huynhpham13790-rgb/Innowork-2026/docs/slide_assets/fire_car.jpg

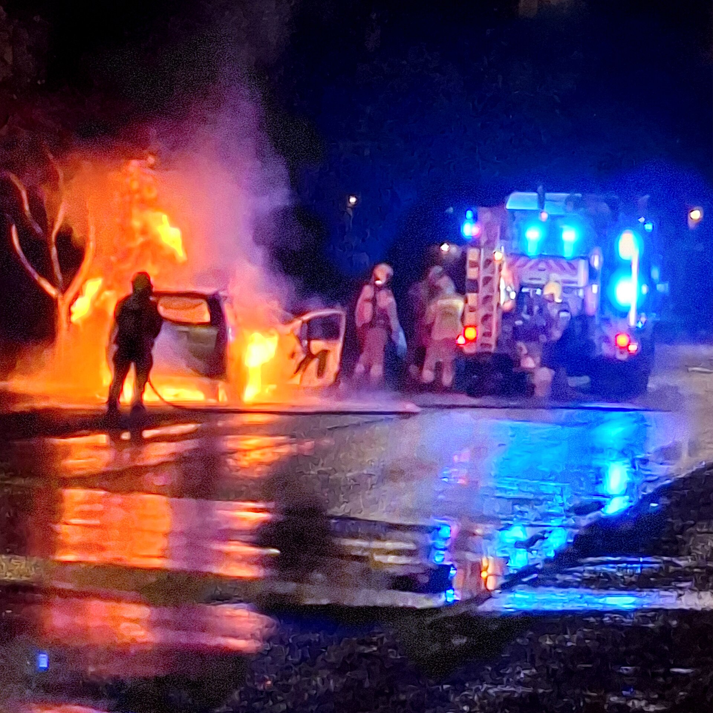
docs/slide_assets/fire_car.jpg
