huynhpham13790-rgb/Innowork-2026/docs/standee/grafana_crop.jpg

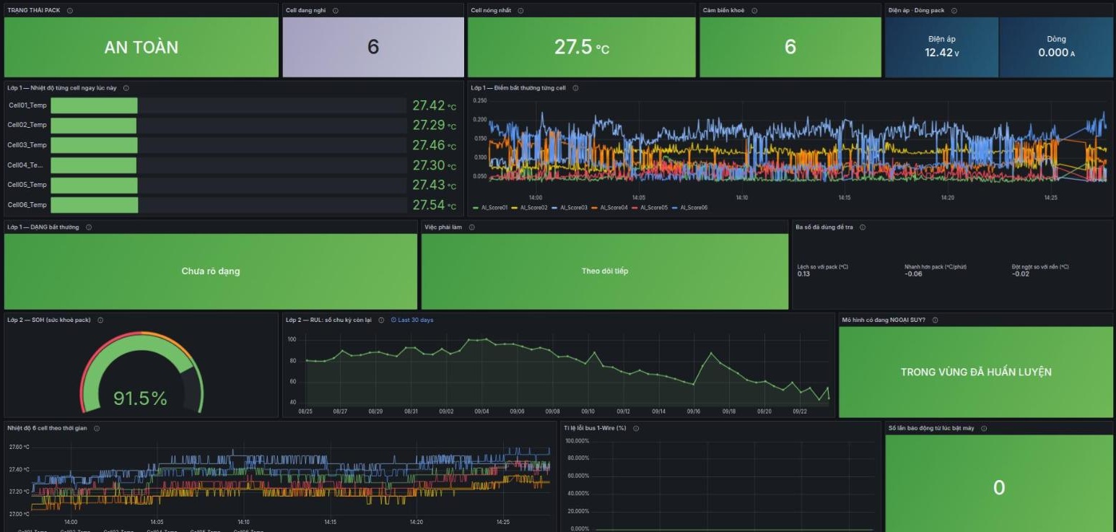
docs/standee/grafana_crop.jpg
