huynhpham13790-rgb/Innowork-2026/docs/MODULE_MAP.md

# Module Map — chức năng nằm ở đâu

Mục đích: người mới (hoặc AI) cần sửa một chức năng thì biết mở file nào, và biết sửa nó sẽ đụng tới đâu.

---

## Sơ đồ đường đi dữ liệu

```
ESP32-S3 ──MQTT/1883──► Mosquitto ──sub──► Node-RED ──HTTP──► InfluxDB ──Flux──► Grafana
   │                    (có auth)          (chuyển đổi)       (lưu 90d)      (dashboard)
   └── mất mạng ──► LittleFS spool ──► đẩy bù khi nối lại (giữ nguyên ts)
```

Khi có tài khoản WISE-IoT: bốn hộp bên phải được thay bằng WISE-IoT, ESP32 **không đổi** (xem `docs/DATA_CONTRACT.md` §5).

---

## Firmware — `VEDCaPhenika/esp32s3_wiseiot_test/esp32s3_wiseiot_test.ino`

Một file duy nhất, cố ý. Đây là sketch *test đường truyền*, không phải firmware sản phẩm; gộp một file để nạp nhanh và đọc hết trong một lượt.

| Vùng | Hàm | Ghi chú |
|---|---|---|
| **Số cell** | `pack_config.h` → `PACK_N_CELLS` | **Nguồn sự thật DUY NHẤT.** `AI_N_CELLS`, `DS_N_PROBES`, `CC_N_CELLS`, `PM_N_CELLS`, `NUM_CELLS`, `PM_V_MIN/MAX` đều suy ra từ đây. Đang là **6**; **8 là bản dự phòng**, đổi một dòng. Số khác 6/8 bị `#error` chặn. Xem QĐ-038. |
| Cấu hình | các `const` đầu file | `STAGE 1/2` quyết định bắn đi đâu. Sửa WiFi/broker ở đây. |
| Thời gian | `isoTimestampUtc()`, `syncTime()`, `timeIsValid()` | `timeIsValid()` chặn không cho gửi khi NTP chưa xong. |
| **Store-and-forward** | `spoolBegin/Append/Compact/Flush/Size()` | Đệm xuống LittleFS khi mất mạng. Có test riêng. |
| Mạng | `ensureWifi()`, `mqttTryConnect()` | **Không chặn.** Chặn ở đây là loop() đứng và mất luôn khả năng đệm. |
| Cloud WISE-IoT | `fetchCredentialFromDccs()` | Chỉ dùng ở STAGE 2. Lấy host/user/pass từ Credential Key. |
| **BLE cho thợ** | `ble_view.h/.cpp` → `BleView` | Dịch vụ GATT `HuTieu-BMS`: **6 đặc tính chỉ đọc + 1 đặc tính lệnh**, xem bằng nRF Connect. Phục vụ NGƯỜI DÙNG B (đứng cạnh pack), **không** thay Wi-Fi. Đặc tính lệnh chỉ nhận `mute`/`quiet`, đòi **ghép đôi + PIN**, tự hết hạn 5 phút. **Sưởi cố ý KHÔNG có mặt.** Thêm lệnh mới = phải qua QĐ. Xem QĐ-041, QĐ-042. |
| Giao thức | `buildTopics()`, `publishConfig/Data/ConnState/Heartbeat()` | Sửa mấy hàm này là **đụng data contract** → phải đọc `docs/DATA_CONTRACT.md` trước. |
| Vòng chính | `setup()`, `loop()` | `loop()` luôn lấy mẫu đúng nhịp bất kể có mạng hay không. |

**Cài đặt build:** Board `ESP32S3 Dev Module`, Partition Scheme **`8M with spiffs (3MB APP/1.5MB SPIFFS)`**.
⚠️ Không chọn các scheme `16M Flash (... FATFS)` — chúng không có phân vùng SPIFFS nên `LittleFS.begin()` sẽ fail và mất toàn bộ store-and-forward. Chi tiết: `docs/DECISION_LOG.md` QĐ-006.

Thư viện: `PubSubClient`, `ArduinoJson` v7.

## Test firmware — `VEDCaPhenika/esp32s3_wiseiot_test/test/`

| File | Vai trò |
|---|---|
| `run_test.sh` | Cắt code spool **thật** từ `.ino` rồi biên dịch cùng test. Chạy trên PC, không cần board. |
| `test_spool.cpp` | Giả lập LittleFS + MQTT, kiểm 5 nhóm tình huống mất mạng. |
| `ble_check.py` | Nghiệm thu BLE **từ PC**: đọc đủ các đặc tính, khẳng định **chỉ đúng một đặc tính ghi được**, notify có bắn, và có quảng bá lại sau khi ngắt. |
| `ble_write_check.py` | Nối mà **không ghép đôi** rồi thử ghi lệnh tắt còi. Phải bị chặn. Xem QĐ-042. |
| `dtr_mute_check.py` | Mở cổng serial với `dtr=True` (kịch bản xấu nhất) rồi **đọc trạng thái qua BLE** để chắc còi không bị tự tắt tiếng. Xem QĐ-041. |

⚠️ Hai file trên cần `bleak` + `pyserial` và **Bluetooth trên PC đang bật**
(`rfkill unblock bluetooth`). Chạy bằng venv riêng:
`/tmp/claude-1000/blevenv/bin/python test/ble_check.py`.

⚠️ **Đọc serial phải dùng `dtr=False`.** `dtr=True` ghì GPIO0 xuống suốt phiên
(GPIO0 = nút tắt tiếng) **và** làm mất dữ liệu — đo 21/09: 4 dòng so với 25.

Chạy: `./test/run_test.sh`. Sửa logic spool mà không chạy lại cái này là đang bay mù.

## Bench phần cứng — `test/`

Sketch chạy **trên board thật**, không phải test trên PC. Mỗi thư mục nghiệm thu
một mảnh phần cứng, để khi hỏng thì chỉ có một nghi phạm.

| Thư mục | Nghiệm thu cái gì |
|---|---|
| `ds18b20_stress_test/` · `ds18b20_power_diag/` · `ds18b20_boot_latch/` | Bus 1-Wire, nguồn, hiệu chuẩn offset |
| `cell_temp_ai_bench/` | `cell_temp` + `cell_ai` chạy cùng nhau |
| `alarm_bench/` | Bốn mức báo động (QĐ-028) |
| `pack_meter_bench/` | Giải mã thanh ghi INA228 — **chạy khô, không cần chip** |
| `pack_meter_live/` | `PackMeter` trên **chip thật**: kiểm đường tự nhận INA226/INA228 (QĐ-037) |
| **`hw_bringup_6s/`** | **Đợt 3: INA226 + 2×D4184 + sưởi 20 Ω + còi SFM-27.** Menu serial T1..T9 + `d`. Bằng chứng: `docs/BANG_CHUNG_BRINGUP_PHAN_CUNG_2026-09-20.md` |

Nạp `hw_bringup_6s` (board cắm cổng USB-Serial-JTAG, `/dev/ttyACM0`):

```
FQBN="esp32:esp32:esp32s3:USBMode=hwcdc,CDCOnBoot=default,PSRAM=opi,FlashSize=16M"
```

⚠️ FQBN trên là của `hw_bringup_6s`. Sketch chính `esp32s3_wiseiot_test` phải
thêm **`PartitionScheme=default_8MB`**, nếu không build trượt với
`text section exceeds available space in board` — app đã 1,37 MB, không lọt
phân vùng mặc định:

```
FQBN="esp32:esp32:esp32s3:USBMode=hwcdc,CDCOnBoot=default,PSRAM=opi,FlashSize=16M,PartitionScheme=default_8MB"
```

⚠️ `CDCOnBoot=cdc` **nạp được, chạy được, nhưng serial câm tịt**. Máy này không
có `arduino-cli` trên PATH; bản đi kèm nằm trong AppImage của Arduino IDE
(`--appimage-extract`).

## Tầng cloud Plan B — `VEDCaPhenika/planb_cloud/`

| File | Vai trò | Sửa khi nào |
|---|---|---|
| `docker-compose.yml` | 4 container: mosquitto, influxdb, nodered, grafana | Đổi port, đổi version (đọc comment ghim version trước) |
| `.env.example` | Mẫu secret. Copy thành `.env` | Không commit `.env` |
| `mosquitto/mosquitto.conf` | Bắt buộc đăng nhập MQTT | Bật ẩn danh chỉ khi chạy LAN nhà |
| `mosquitto/passwd` | Sinh bằng `mosquitto_passwd`, **không commit** | Đổi mật khẩu MQTT |
| `nodered/flow_wisepaas_to_influx.json` | Flow chạy thật, import qua UI | Đổi luồng xử lý |
| `nodered/flow_demo_control.json` | **Màn hình người dùng cuối** — `http://127.0.0.1:1880/hutieu`. Trạng thái, 6 cell, chẩn đoán TH-1/2/3, nút tắt còi; phần sưởi nằm dưới mục "chỉ dùng khi trình diễn", **hai nút: TH-1 nóng vọt / TH-2 ấm ổn định** (gửi `{"cmd":"heat","mode":"fast\|steady"}`, QĐ-049) | Đổi giao diện. Chỉ dùng node LÕI, không cần cài palette. **Flow đang chạy có id `1c36b21664cab788`**, khác tên file — sửa xong phải đồng bộ hai chiều |
| `seed_layer2.py` | Seed lịch sử Lớp 2: phát lại 60 chu kỳ pin NASA B0005 qua MQTT thật, để Node-RED tự tính SOH/RUL (QĐ-050). `--clear` xoá kết quả Lớp 2 mô phỏng 45 ngày qua | Trước buổi demo; đổi đoạn chu kỳ phát lại |
| `nodered/convert.js` | Bản đọc được của node "WISE-PaaS → line protocol" | Đổi cách map payload → DB |
| `nodered/check_influx_response.js` | Bản đọc được của node "Kiểm tra kết quả ghi" | Đổi cách báo lỗi ghi |

⚠️ `convert.js` và `check_influx_response.js` là **bản chép để đọc**; bản chạy thật nằm trong JSON. Sửa file `.js` thì phải đồng bộ lại vào JSON, nếu không sẽ sửa một đằng chạy một nẻo.

## Tài liệu

| Nhóm | Ở đâu |
|---|---|
| Điều khiển AI, gate, DoD | `CLAUDE.md` |
| Hợp đồng dữ liệu, module map, test, quyết định, RTM | `docs/` |
| Nghiên cứu, phần cứng, lộ trình, Plan B | `VEDCaPhenika/*.md` |

## Ba màn hình, ba người dùng — đừng nhầm vai

| Màn | Phục vụ ai | Chỉ nó làm được |
|---|---|---|
| **Grafana** `:3000` | A — quản lý đội xe | Đồ thị lịch sử, nhiều pack. **Đây là phần được chấm điểm.** |
| **Node-RED** `/hutieu` | Người dùng cuối + người trình diễn | **Có nút bấm** gửi lệnh xuống thiết bị. Hợp điện thoại. |
| **BLE** (nRF Connect) | B — thợ đứng cạnh pack | **Chạy không cần mạng.** Đọc tự do; tắt còi thì phải ghép đôi. |

Grafana là dashboard đồ thị nên **không gửi lệnh xuống thiết bị được** — mọi nút
bấm bắt buộc nằm ở trang Node-RED. Đó là lý do có hai trang web chứ không một.

## App Android — `app_android/app/src/main/java/vn/ictu/hutieu/`

| File | Vai trò | Sửa khi nào |
|---|---|---|
| `MainActivity.kt` | Kết nối BLE, hàng đợi GATT, vẽ màn hình | Đổi bố cục, đổi luồng kết nối |
| `Strings.kt` | Chữ của app hai thứ tiếng + từ điển dự phòng cho chữ chip | Thêm nhãn/nút |
| `ChipText.kt` | Bóc SỐ khỏi chuỗi chip gửi (`ble_view.cpp`) rồi tự viết câu có dấu, song ngữ (QĐ-049) | **Mỗi lần đổi định dạng `snprintf` trong `ble_view.cpp`** — không khớp mẫu thì app rơi về chữ không dấu, không mất số |

## Sưởi demo — `demo_heater.*`

Hai chế độ (QĐ-049): `DH_MODE_FAST` bật hết cỡ tới +6 °C (diễn TH-1), `DH_MODE_STEADY`
băm xung tỉ lệ, trần 30 % công suất, giữ cell ấm ổn định (diễn TH-2). Serial: `h` = nhanh,
`w` = ổn định, `s` = dừng. Mọi hạn mức an toàn dùng chung, chế độ không nới cái nào.
