huynhpham13790-rgb/Innowork-2026/VEDCaPhenika/KICH_BAN_CALL_ADVANTECH.md

# Cuộc gọi với Advantech WISE — chuẩn bị sẵn, khỏi lo tiếng Anh

Đội Hủ Tiếu · 06/09/2026

---

## Trước hết: đây không phải phỏng vấn

Không ai chấm điểm bạn cả. Đây là **cuộc gọi bán hàng** — quy trình chuẩn của mọi công ty B2B khi có người đăng ký dùng thử. Mục đích của họ chỉ là biết bạn là ai, định dùng sản phẩm làm gì, và có khả năng thành khách hàng không. Không có câu trả lời đúng/sai, không ai trượt. Thực tế bạn còn đang ở thế thuận: bạn là đội thi trong chương trình InnoWorks do chính Advantech tổ chức, tức là đúng đối tượng họ muốn hỗ trợ.

Nút **Book Time** chỉ là đặt lịch. Email ghi "DO NOT reply" nên đừng trả lời email, cứ bấm nút đó.

---

## Đường tắt nên thử trước: xin nói chuyện bằng tiếng Việt

Advantech có văn phòng tại Việt Nam. Trong ô ghi chú khi đặt lịch, cứ nói thẳng là bạn muốn được kết nối với đội ngũ Advantech Việt Nam. Đây là yêu cầu bình thường, họ gặp suốt và thường đồng ý. Nếu được chuyển sang Advantech VN thì toàn bộ vấn đề ngôn ngữ biến mất.

Song song, hỏi BTC InnoWorks xem có đầu mối Advantech Việt Nam không — một lời giới thiệu từ BTC thường nhanh hơn form công khai.

---

## Text tiếng Anh dán vào ô ghi chú khi đặt lịch

Viết đủ thông tin vào đây là quan trọng nhất. Nếu họ đọc mà đã hiểu hết, cuộc gọi sẽ rất ngắn — hoặc họ cấp trial luôn không cần gọi.

```
Hello,

I am Pham Van Huynh, team leader of "Hu Tieu" from Thai Nguyen University
of Information and Communication Technology (ICTU), Vietnam.

We are a finalist team (Top 20) in AIoT InnoWorks 2026, organized by
Advantech. Our semifinal is on September 15, 2026 at Phenikaa University,
and the final is on November 27, 2026.

Our project monitors per-cell temperature of electric motorcycle battery
packs. An autoencoder runs on an ESP32-S3 to detect abnormally hot cells,
and we want to use EdgeHub as our cloud layer for dashboards and RUL
(remaining useful life) computation.

We would like to request the EdgeHub 90-day free trial (5 devices /
100 parameters is more than enough for us - we need 1 device and 8 tags).

Two requests:
1. Because our semifinal is on September 15, we would be very grateful if
   the trial could be activated as soon as possible.
2. My English is limited. If possible, could we communicate by email
   instead of a call? Or could we be connected to the Advantech Vietnam
   team so we can speak Vietnamese?

Thank you very much for your support.

Pham Van Huynh
Team Hu Tieu - AIoT InnoWorks 2026
huynhpham13790@gmail.com
```

Đoạn "My English is limited" không hề làm mất điểm. Nói trước như vậy là chuyên nghiệp, và người ta sẽ tự động nói chậm lại hoặc chuyển sang email.

---

## Nếu vẫn phải gọi — kịch bản 5 phút

Họ gần như chỉ hỏi bốn câu này. Bạn học thuộc câu trả lời là đủ.

**"Can you tell me about your project?"** (Dự án của bạn là gì?)
> We monitor the temperature of each battery cell in electric motorcycles. An AI model on the ESP32 detects abnormal cells. We use EdgeHub for the cloud dashboard.

**"How many devices do you need?"** (Cần bao nhiêu thiết bị?)
> Just one device and eight tags. The trial quota is enough.

**"What is your timeline?"** (Tiến độ thế nào?)
> Our competition semifinal is September 15. We need access before that date.

**"Are you a student or a company?"** (Sinh viên hay công ty?)
> I am a student at ICTU in Vietnam. This is for the AIoT InnoWorks 2026 competition organized by Advantech.

Câu cứu hộ khi không nghe kịp — dùng thoải mái, không ai phiền:
> Sorry, could you repeat that more slowly, please?
> Could you type that in the chat, please?
> Could you send me that by email? My English is not very good.

Mẹo thực tế: cuộc gọi thường qua Teams hoặc Google Meet, cả hai đều có **phụ đề trực tiếp** (live captions). Bật lên, bạn đọc chữ dễ hơn nghe nhiều. Và rủ thêm một bạn trong đội khá tiếng Anh vào cùng — đây là cuộc gọi của cả đội chứ không riêng bạn.

---

## Đặt lịch khung giờ nào

Advantech ở Đài Loan, cùng múi giờ Việt Nam +1. Chọn khung 14:00–16:00 giờ Việt Nam là an toàn, rơi vào đầu giờ chiều của họ.

---

## Quan trọng nhất

Đừng để việc này chặn tiến độ. Đặt lịch xong là quay lại cắm ESP chạy STAGE 1 — phần đó không phụ thuộc vào Advantech chút nào, và nó mới là thứ giám khảo xem ở vòng bán kết.
