huynhpham13790-rgb/Innowork-2026/docs/standee/standee_80x180.pdf

AIoT InnoWorks 2026 | Đội Hủ Tiếu · ICTU

GIÁM SÁT AN TOÀN PIN XE ĐIỆN

# Bắt cell pin hỏng trước khi nó cháy

Đám cháy pin nào cũng bắt đầu từ một cell nóng hơn phần còn lại.

## Chúng tôi đo từng cell, và AI ngay trên chip nhận ra cell đó khi nó mới

lệch vài độ — còn rất xa ngưỡng 60 °C.

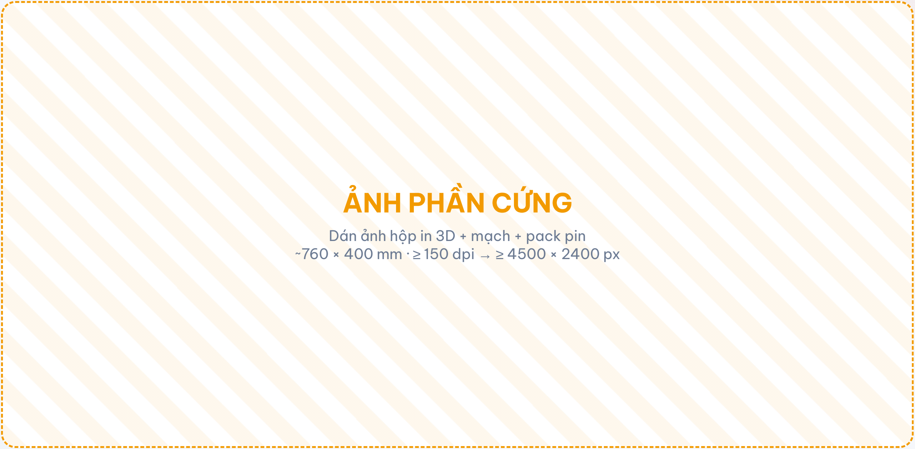
[picture p17: figure]
ẢNH PHẦN CỨNG; Dán ảnh hộp in 3D + mạch + pack pin

~760 × 400 mm · ≥ 150 dpi → ≥ 4500 × 2400 px

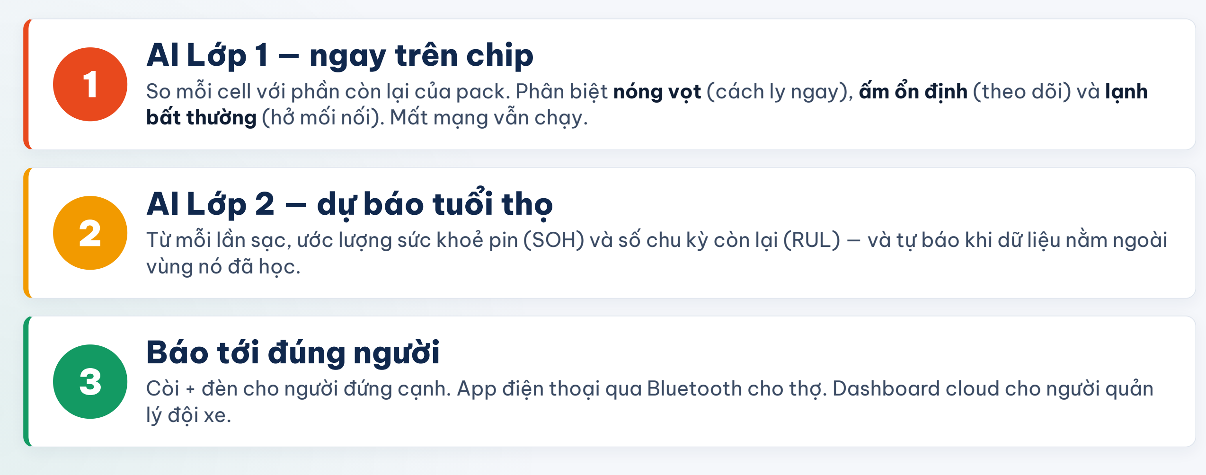
[picture p18: figure]
AI Lớp 1 — ngay trên chip; AI Lớp 2 — dự báo tuổi thọ; vùng nó đã học.; Báo tới đúng người; lý đội xe.

So mỗi cell với phần còn lại của pack. Phân biệt nóng vọt (cách ly ngay), ấm ổn định (theo dõi) và lạnh bất thường (hở mối nối). Mất mạng vẫn chạy.

Từ mỗi lần sạc, ước lượng sức khoẻ pin (SOH) và số chu kỳ còn lại (RUL) — và tự báo khi dữ liệu nằm ngoài

Còi + đèn cho người đứng cạnh. App điện thoại qua Bluetooth cho thợ. Dashboard cloud cho người quản

Xem trực tiếp tại gian ảnh chụp từ hệ thống đang chạy

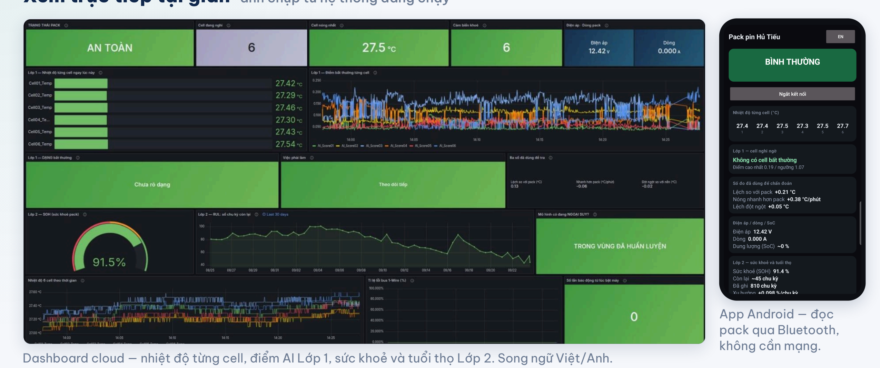
[picture p19: figure]
App Android — đọc pack qua Bluetooth, không cần mạng.

Dashboard cloud — nhiệt độ từng cell, điểm AI Lớp 1, sức khoẻ và tuổi thọ Lớp 2. Song ngữ Việt/Anh.

Cảm biến
6 cell + dòng/áp

›

ESP32-S3
AI on-device

›

MQTT
WISE-PaaS

›

Cloud
dashboard · app

## Đội Hủ Tiếu

Phạm Văn Huynh · Phạm Minh Tú · Đàm Đức Đôn · Hoàng Văn Huy · Nguyễn Hoàng Anh Tuấn GVHD: Đào Thị Hằng

Trường ĐH Công nghệ Thông tin và Truyền thông — ĐH Thái Nguyên · Khoa CNTT
