huynhpham13790-rgb/Innowork-2026/VEDCaPhenika/DOC_LANDING_PAGE_BTC.md

# Đọc landing page BTC — ba thứ cần xử lý ngay

Đội Hủ Tiếu · 06/09/2026 · nguồn: https://giaiphap.advantech.com.vn/aiot-innoworks/

---

## 1. Ngày Bán kết đang lệch — hỏi BTC hôm nay

Bảng lịch trên landing page chính thức ghi:

| Vòng thi | Thời gian | Địa điểm |
|---|---|---|
| Vòng Bán Kết | **26/09** | ĐH Phenikaa |
| Vòng Chung Kết | 27/11 | ĐH Phenikaa |

Tài liệu của đội mình đang ghi Bán kết **26/09**. Chênh 11 ngày. Đây là thứ phải gọi hỏi trước tất cả mọi thứ khác, vì mọi kế hoạch tớ viết cho bạn mấy hôm nay đều tính theo 26/09.

Cho tới khi BTC xác nhận, **cứ chuẩn bị theo mốc 26/09**. Sai theo hướng sớm thì thừa 11 ngày, sai theo hướng muộn thì mất giải.

**BTC Phenikaa:** Cô Trần Thị Linh — 0346.286.519 · Anh Quan Văn Dương — 0328.582.728

---

## 2. Tài khoản Academy mà BTC nhắc **không phải** nền tảng cloud

Đây là điểm dễ hiểu lầm nhất trong tin nhắn của BTC. "Tài khoản miễn phí bằng Gmail trên Advantech Academy" là tài khoản **học liệu** — vào xem khóa học, làm quiz, lấy chứng chỉ. Nó không kèm tenant WISE-IoT, không có IoT Hub để nhận MQTT, không có Grafana để dựng dashboard.

Nên nếu mục tiêu của bạn là *có dashboard thật chạy dữ liệu thật từ ESP32*, tài khoản Academy không giải quyết được. Vẫn phải đi một trong hai đường: xin BTC cấp, hoặc tự redeem trial EdgeHub.

Landing page cũng viết rõ: dự án 2026 **không bắt buộc** phải dựng trên WISE-IoT, nhưng *"những nhóm có nhu cầu sử dụng nền tảng này trong cuộc thi cần đăng ký trước với BTC. Số lượng tài khoản đăng ký có hạn."*

Câu đó đáng chú ý ở chỗ "số lượng có hạn" — nghĩa là đăng ký sớm có lợi, và **BTC mới là kênh chính thức**, không phải form free-trial quốc tế.

---

## 3. Advantech có văn phòng Hà Nội — hết lo tiếng Anh

Đây là thứ gỡ hẳn nỗi lo cuộc gọi tiếng Anh hôm qua:

**Advantech Việt Nam — Hà Nội:** Tầng 2, Tòa nhà VTC Online, 18 Tam Trinh, P. Tương Mai · **+84 24 3399 1155**
**TP.HCM:** Tầng 4, Central Garden, 328 Võ Văn Kiệt · +84 28 3836 5856
Đầu mối marketing của Advantech VN cho cuộc thi: **Ms. Quỳnh Anh**

Gọi thẳng số Hà Nội, nói tiếng Việt: bạn là đội Top 20 InnoWorks 2026, cần tài khoản WISE-IoT/EdgeHub để làm dự án, hỏi xin hướng dẫn. Nhanh hơn và dễ hơn nhiều so với đặt lịch call tiếng Anh với đội sales quốc tế.

---

## Thứ tự làm

1. Gọi/nhắn BTC chốt ngày Bán kết + hỏi luôn xin tài khoản WISE-IoT (kênh chính thức, có hạn số lượng).
2. Gọi Advantech VN Hà Nội bằng tiếng Việt làm đường song song.
3. Vẫn giữ lịch call quốc tế đã đặt — không mất gì, có thì tốt.
4. **Trong lúc chờ cả ba: cắm ESP chạy STAGE 1.** Phần đó không phụ thuộc ai, và nó mới là thứ giám khảo xem.
