huynhpham13790-rgb/Innowork-2026/docs/SLIDE_BAN_KET_HuTieu_VI.pptx

AIoT InnoWorks 2026 · Vòng Bán kết

Giám sát an toàn nhiệt
pack pin xe điện bằng Edge AI

Đội Hủ Tiếu · ICTU – Đại học Thái Nguyên
Tìm ra cell hỏng trước khi nó thành đám cháy.

Ảnh: pack pin lithium-ion hỏng vì thermal runaway (pin APU Boeing 787 của JAL) — NTSB, phạm vi công cộng

## Slide 2

Vấn đề

Pack pin không hỏng đồng loạt.
Một cell yếu nóng lên trước.
Thermal runaway một khi đã chạy thì tự nuôi, không dừng được.


vụ cháy xe điện xảy ra khi xe đang đỗ

~31%

xảy ra trong hầm để xe

~25%

đồng để thay một pack xe máy điện

Ảnh: xe cháy trong bãi đỗ (không phải xe điện) — Jim Heaphy, CC BY-SA 3.0 · Số liệu cháy: EV FireSafe

1,5–12tr

## Slide 3

BMS nào cũng có ngưỡng cứng 60 °C. Vậy cần AI làm gì?

Vì dấu hiệu nguy hiểm xuất hiện rất lâu trước khi chạm bất kỳ ngưỡng tuyệt đối nào.


NGƯỠNG CỨNG
Kết luận: bình thường
Không cell nào gần 60 °C.

EDGE AI CỦA ĐỘI
Kết luận: cell bất thường
Cell #3 nóng hơn phần còn lại 4 °C, cùng một tải.

Mô hình đọc quan hệ giữa các cell — không đọc con số tuyệt đối.

## Slide 4

Giải pháp của đội

Một module giá thấp, theo dõi từng cell và tự suy luận ngay trên thiết bị.


Autoencoder chạy trên ESP32-S3, mỗi giây chỉ ra cell bất thường. Không cần cloud.

1

PHÁT HIỆN

Mô hình trên cloud đọc đường sạc, báo sức khoẻ pin và tuổi thọ còn lại.

2

DỰ BÁO

Báo động tại chỗ 4 mức: còi và đèn vẫn kêu khi mất mạng hoàn toàn.

3

HÀNH ĐỘNG

Ảnh: cell 18650 / 21700 — Wikimedia Commons, CC0

## Slide 5

Kiến trúc hệ thống

Hai lớp AI, chia theo việc câu trả lời cần nhanh tới mức nào.

An toàn không bao giờ phụ thuộc vào mạng. Thiết bị tự phát hiện và tự kêu; cloud chỉ thêm dashboard và phần dự báo dài hạn.

Pack thí nghiệm 6 cell
6 × DS18B20 · INA228
1 mẫu / giây

ESP32-S3
LỚP 1 — autoencoder
chạy trên thiết bị, mỗi giây

MQTT / WISE-PaaS
/wisepaas/scada/{nodeId}/data

Cloud
LỚP 2
sức khoẻ / tuổi thọ còn lại
1 lần mỗi chu kỳ sạc

BÁO ĐỘNG TẠI CHỖ
còi + LED · chạy khi mất mạng

Đệm và gửi bù
lưu vào flash lúc offline

## Slide 6

Phần cứng đội đã làm

Pack thí nghiệm 6 cell 18650 — mỗi cell một đầu dò riêng.

Gây lỗi một cách an toàn: điện trở công suất sứ sưởi một cell. Firmware cắt cứng ở 60 °C. Không cell nào bị lạm dụng.

Ảnh linh kiện: Wikimedia Commons (CC BY-SA 4.0 / CC BY 2.0 / CC0)


ESP32-S3-DevKitC-1
có tập lệnh vector cho ML


6 × DS18B20
mỗi cell một đầu dò


BMS 6S có cân bằng
chính nó tạo tình huống ngắt


6 cell 18650 đồng bộ
cùng lô, cùng tuổi

## Slide 7

Lớp 1 — bộ phát hiện cell bất thường

Chạy ngay trên vi điều khiển, mỗi giây một lần, không cần internet.

Mô hình có sai thì ngưỡng cứng vẫn kêu. Dòng đó không bao giờ được bỏ.

Nó đọc quan hệ, không đọc độ C
· lệch bao nhiêu so với trung bình của pack
· có nóng lên nhanh hơn các cell khác không
· lệch từ từ (lão hoá) hay đột ngột (sự cố)

Chỉ báo động khi tín hiệu giữ liên tục nửa phút — nhiễu một mình không kích hoạt được.

rất nhỏ

mô hình gọn
trong ~1 KB flash

1 Hz

tần số suy luận
trên thiết bị

offline

phát hiện
không cần mạng

60 °C

ngưỡng cứng,
nằm ngoài AI

## Slide 8

Đội đã thử nghiệm những gì

Pack thí nghiệm dùng cell tương tự, cộng với dữ liệu công khai đo trên pack thật — chưa phải pack xe điện đang chạy.

Đây là kết quả trên bàn thí nghiệm và trên dữ liệu công khai. Sưởi một cell trên chính pack của đội, và đo trên pack xe điện đang chạy, là hai bước tiếp theo — đội chưa làm.

Cảm biến và đường truyền, trên bàn

lên dashboard theo thời gian thực, đệm khi mất mạng

Logic báo động, kiểm đủ trên bench

cả bốn mức đúng, kể cả khi tắt AI

Dữ liệu công khai, tiêm lỗi vào một cell

phát hiện ổn định

Pack thật độc lập, chưa từng thấy

file lỗi tách rõ khỏi file bình thường

## Slide 9

Phép kiểm đội đã TRƯỢT — và nó dạy được gì

Đội nêu chuyện này vì đây là kết quả kỹ thuật giá trị nhất đội có.

Đây cũng chính là thứ làm cho sản xuất hàng loạt khả thi: mọi máy nạp cùng một mô hình.

1 · TRƯỢT
Trên pack thật chưa từng huấn luyện, mô hình báo động cả ở file bình thường.
Cao hơn cả file có lỗi.

2 · CHẨN ĐOÁN
Các đầu vào tuyệt đối — nhiệt môi trường, dòng, mức sạc — lệch xa khỏi dải đã học.
Chúng giống nhau ở mọi cell nên đẩy tất cả lên cùng lúc.

3 · ĐÃ SỬA
Bỏ chúng, chỉ giữ quan hệ giữa các cell.
Báo oan giảm, phát hiện tốt hơn, và chuyển giao được sang pack lạ.

## Slide 10

Lớp 2 — pack này còn dùng được bao lâu?

Không ai xả kiệt pin mỗi tuần để đo. Nhưng ngày nào người dùng cũng cắm sạc.

Lớp 2 đặt trên cloud là cố ý: cải tiến mô hình không được phép bắt nạp lại firmware cho từng xe.

Đọc dáng của đường sạc.
Cell chai chạm ngưỡng điện áp sớm hơn, rồi nằm ở pha điện áp không đổi lâu hơn hẳn.
Đo được ngay trong một lần sạc bình thường — người dùng không phải làm gì.


## Slide 11

Bốn mức báo động, không phải một cái còi

"Theo dõi tiếp" và "ngắt sạc ngay" là hai mệnh lệnh khác nhau.

OK

bình thường

THEO DÕI

một cell đang lệch

BÁO ĐỘNG

AI, giữ liên tục

NGUY KỊCH

có cell vượt 60 °C

MẤT CẢM BIẾN báo xanh dương, không phải đỏ.
"Không nhìn thấy pack" ≠ "pack đang nguy hiểm".

Có nút tắt tiếng — và tắt tiếng không tắt đèn.
Còi không tắt được thì sẽ bị cắt dây.

## Slide 12

Hiện tại hệ thống đang chạy ở đâu

Firmware đã nói đúng giao thức WISE-PaaS — đội chỉ đang tự host các lớp bên dưới.

topic /wisepaas/scada/{nodeId}/data — đúng định dạng của Edge SDK chính chủ Advantech

Dashboard Grafana của chính đội — số liệu trong ảnh là số mô phỏng

ESP32-S3
payload WISE-PaaS

Mosquitto
MQTT broker

Node-RED
bóc tách + Lớp 2

InfluxDB
chuỗi thời gian

Grafana
dashboard


Vì sao đúng bộ này?
Đây chính là các thành phần mà WISE-PaaS dựng trên đó.
Không phần nào là giải pháp chống chế phải vứt đi.

## Slide 13

Người vận hành nhìn thấy gì

Ba giây để trả lời: pack có an toàn không, cell nào, và số này có tin được không?

Dashboard Grafana của chính đội. Số liệu trong ảnh là số mô phỏng để minh hoạ kịch bản.


Đọc hàng đầu là đủ

Trạng thái pack, cell đang nghi, cell nóng nhất, cảm biến khoẻ — không phải đọc biểu đồ.

Cell #3 lộ ngay

Bar gauge là so sánh không gian, nên cell khác thường thấy ngay.

Trung thực trên màn hình

Số nào còn là giả định thì tự khai là giả định.

## Slide 14

Nếu được cấp tài khoản WISE-PaaS

Là đổi cấu hình, không phải viết lại — firmware không đổi một dòng nào.

ESP32-S3
firmware không đổi
cùng payload, cùng topic

WISE-PaaS IoT Hub
quản lý thiết bị + TLS

chỉ đổi host broker + credential

WISE-PaaS Dashboard

AFS — nơi chạy mô hình Lớp 2

Quản lý thiết bị

Cấp phát, TLS và cập nhật OTA do nền tảng lo.

Dashboard & cảnh báo

WISE-PaaS Dashboard thay cho Grafana của đội.

AFS cho Lớp 2

Huấn luyện lại, triển khai mà không đụng vào xe nào.

## Slide 15

Demo trực tiếp — 90 giây

Dashboard đang chảy nhiệt độ từng cell theo thời gian thực.

Rút mạng ngay trước mặt giám khảo.

Sưởi một cell bằng điện trở.

Module phát hiện và kêu còi — vẫn đang mất mạng.

Cắm mạng lại: dữ liệu quãng offline hiện lên dashboard, đúng vị trí trên trục thời gian.

Edge AI, báo động tại chỗ và đệm-gửi-bù — cả ba trong một lần chạy.


1

2

3

4

5

Ảnh: trạm sạc xe điện — Wikimedia Commons, CC BY-SA 3.0

## Slide 16

Ai là người trả tiền

Đơn vị vận hành đội xe và mạng lưới trạm đổi pin — nơi pin thuộc về một pháp nhân.

Người dùng cá nhân là câu chuyện mở đầu. Đội xe mới là mô hình kinh doanh.

Ảnh: tủ đổi pin xe máy điện — Wikimedia Commons, CC BY-SA 4.0


Pin thuộc đơn vị vận hành, nên người mất tiền khi pin hỏng cũng chính là người mua được thiết bị.

Chủ sở hữu = người trả tiền

Thay pack thành bảo dưỡng có lịch, thay vì sự cố.

Có kế hoạch, không khẩn cấp

Pin về trạm mỗi ngày — WiFi trạm làm đường truyền.

Không cần SIM

## Slide 17

Những gì đội CHƯA chứng minh được

Thà nói trước còn hơn để bị hỏi.

Không có điều gì trong bộ slide này được nói quá hơn thứ đội thật sự đo được.

Không cell nào lệch nên Lớp 1 im. Ngưỡng cứng 60 °C lo việc này — chưa kiểm được trên phần cứng.

Cả pack cùng nóng đều

Hiện mới có pack thí nghiệm cùng loại cell và dữ liệu công khai. Đo trên xe chạy hằng ngày là bước tiếp theo.

Pack xe điện đang vận hành thật

Cell còn mới — chỉ có một điểm ở đầu thang đo. Đội tính mượn pack đã chai.

Dự báo lão hoá trên pack đã chai

## Slide 18

Từ Bán kết tới Chung kết

27/11/2026

HIỆN TẠI

THÁNG 10

THÁNG 11

Giàn 6 cell, Lớp 1 chạy trên thiết bị, báo động 4 mức, cloud đã chạy

Đo dòng thật → chu kỳ sạc thật → kết quả Lớp 2 thật

Kiểm trên pack đã chai · vỏ hộp · mô hình chi phí · phỏng vấn đội xe

## Slide 19


Một cell châm ngòi.
Đội theo dõi từng cell.

Đội Hủ Tiếu · ICTU – Đại học Thái Nguyên
Cảm ơn thầy cô. Rất mong nhận câu hỏi — nhất là câu khó.

Ảnh: cell 18650 sau thermal runaway — Wikimedia Commons, CC BY 4.0
