huynhpham13790-rgb/Innowork-2026/docs/anh/grafana_lop2_seed_2026-09-23.jpg

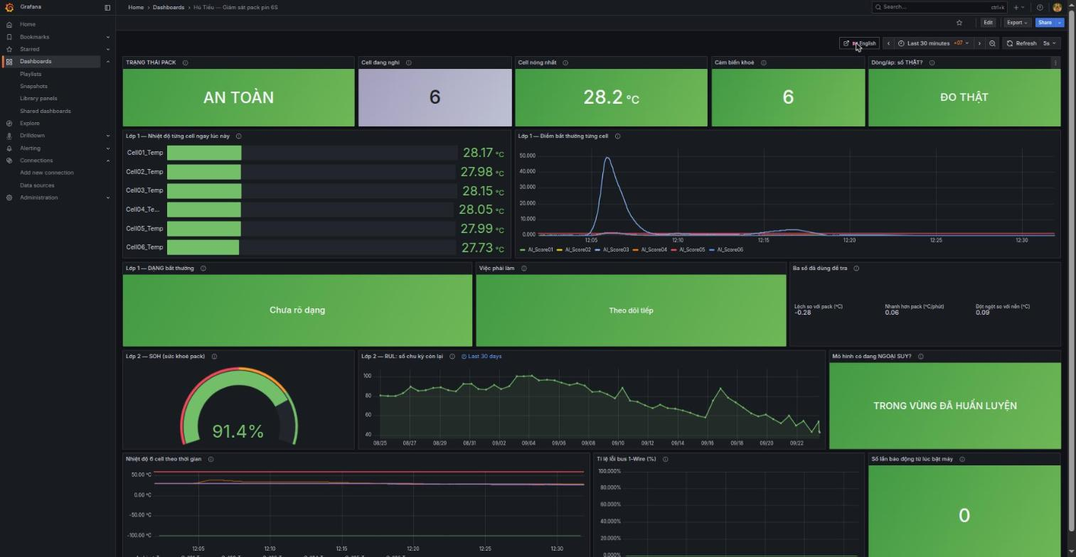
docs/anh/grafana_lop2_seed_2026-09-23.jpg
