huynhpham13790-rgb/Innowork-2026/docs/slide_assets/bms6s.jpg

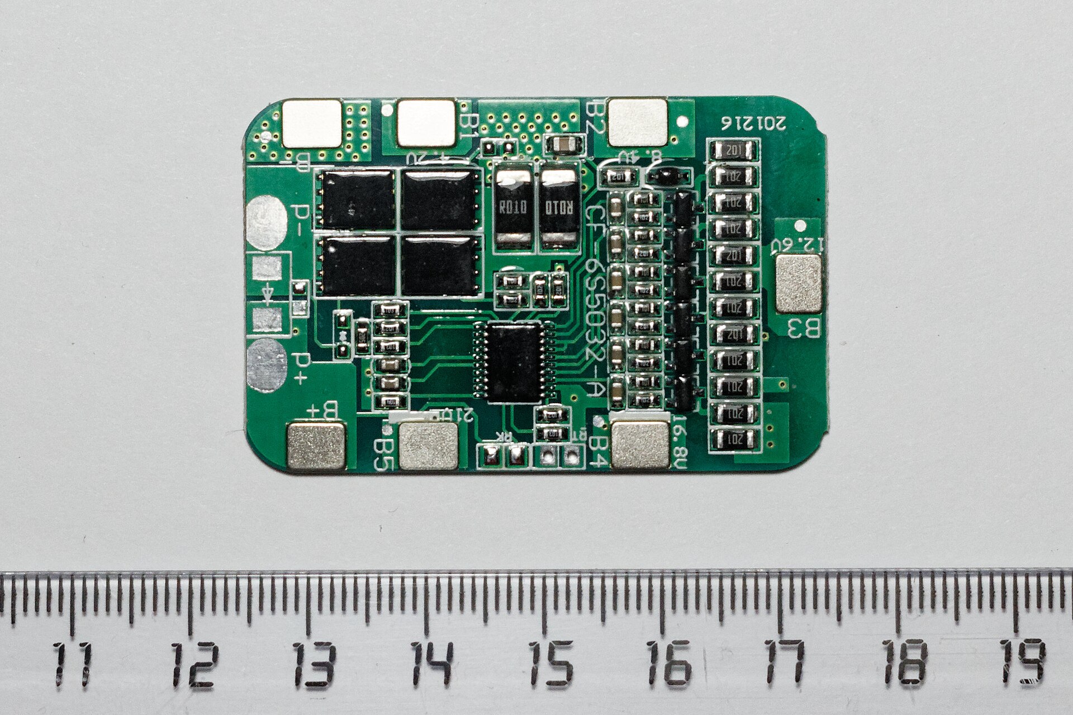
docs/slide_assets/bms6s.jpg
