huynhpham13790-rgb/Innowork-2026/docs/slide_assets/burnt_car.jpg

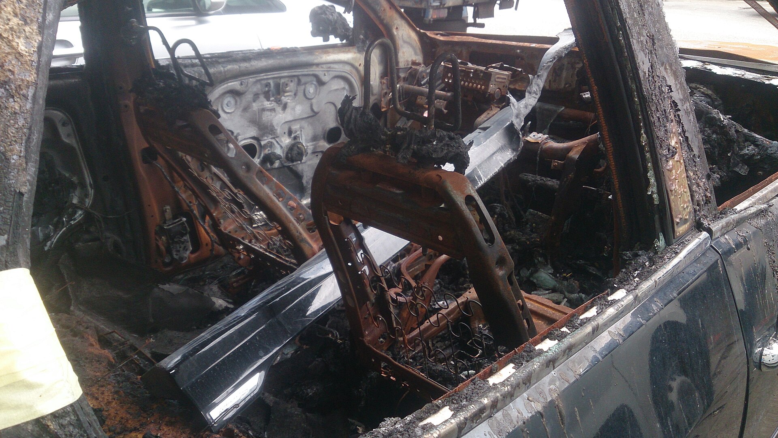
docs/slide_assets/burnt_car.jpg
