huynhpham13790-rgb/Innowork-2026/docs/slide_assets/cell_explosion.jpg

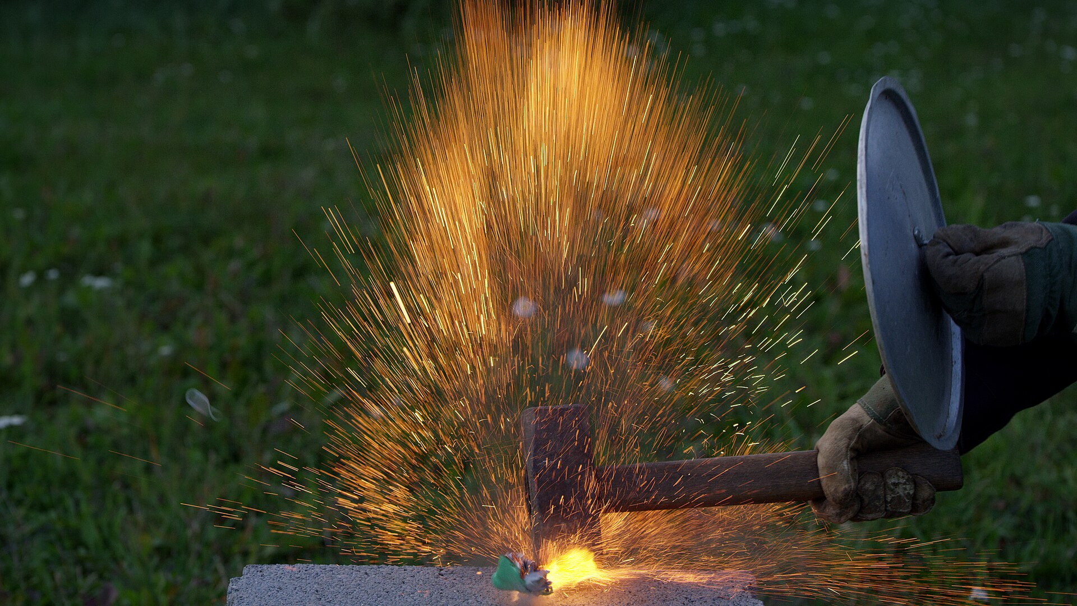
docs/slide_assets/cell_explosion.jpg
