huynhpham13790-rgb/Innowork-2026/docs/slide_assets/cells_charger.jpg

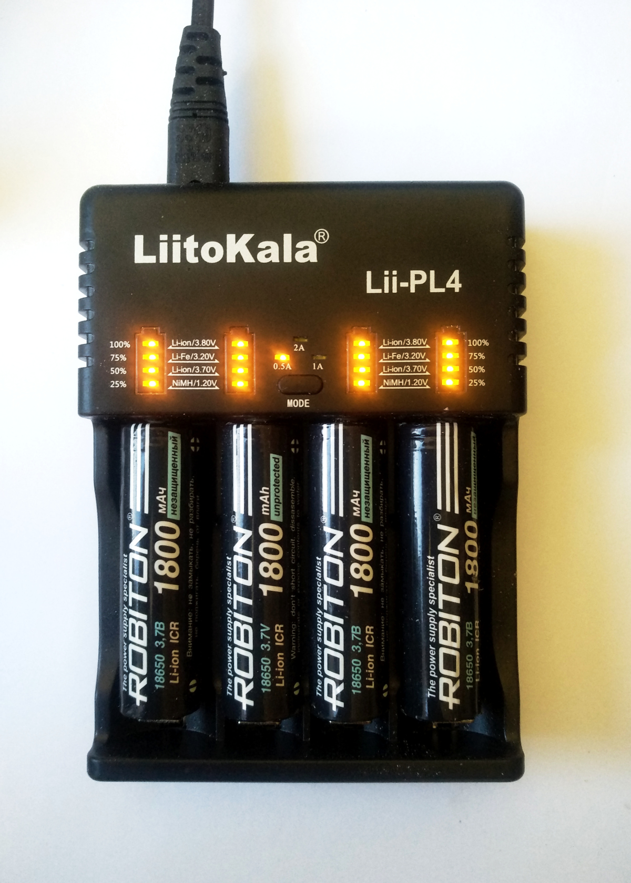
docs/slide_assets/cells_charger.jpg
