huynhpham13790-rgb/Innowork-2026/docs/slide_assets/pack_bmw.jpg

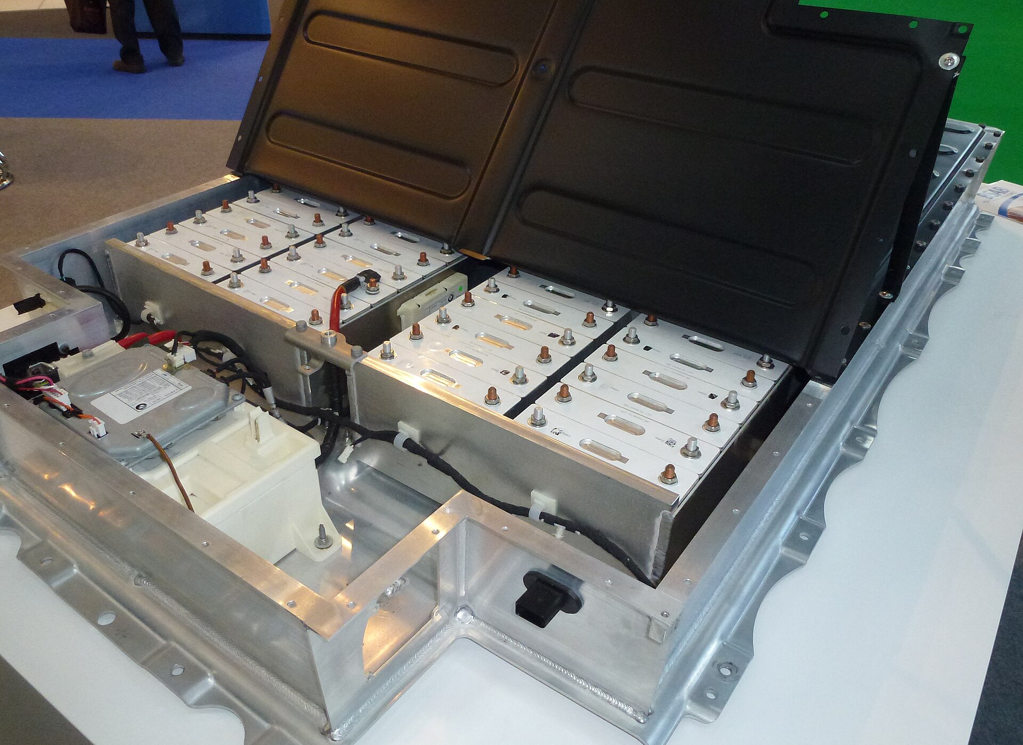
docs/slide_assets/pack_bmw.jpg
