huynhpham13790-rgb/Innowork-2026/docs/slide_assets/pack_leaf.jpg

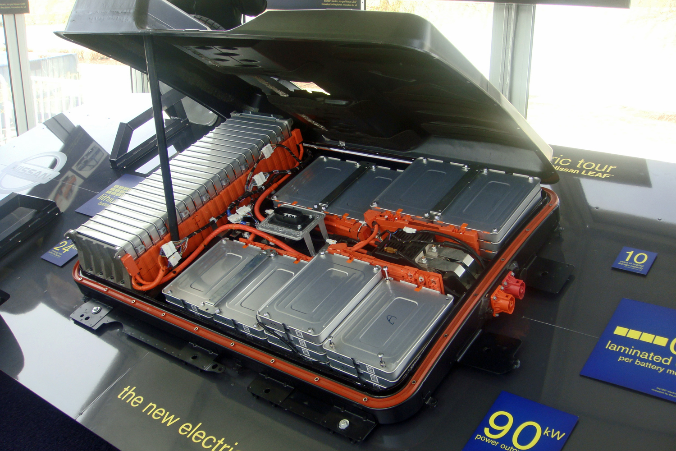
docs/slide_assets/pack_leaf.jpg
