huynhpham13790-rgb/Innowork-2026/docs/slide_assets/swap.jpg

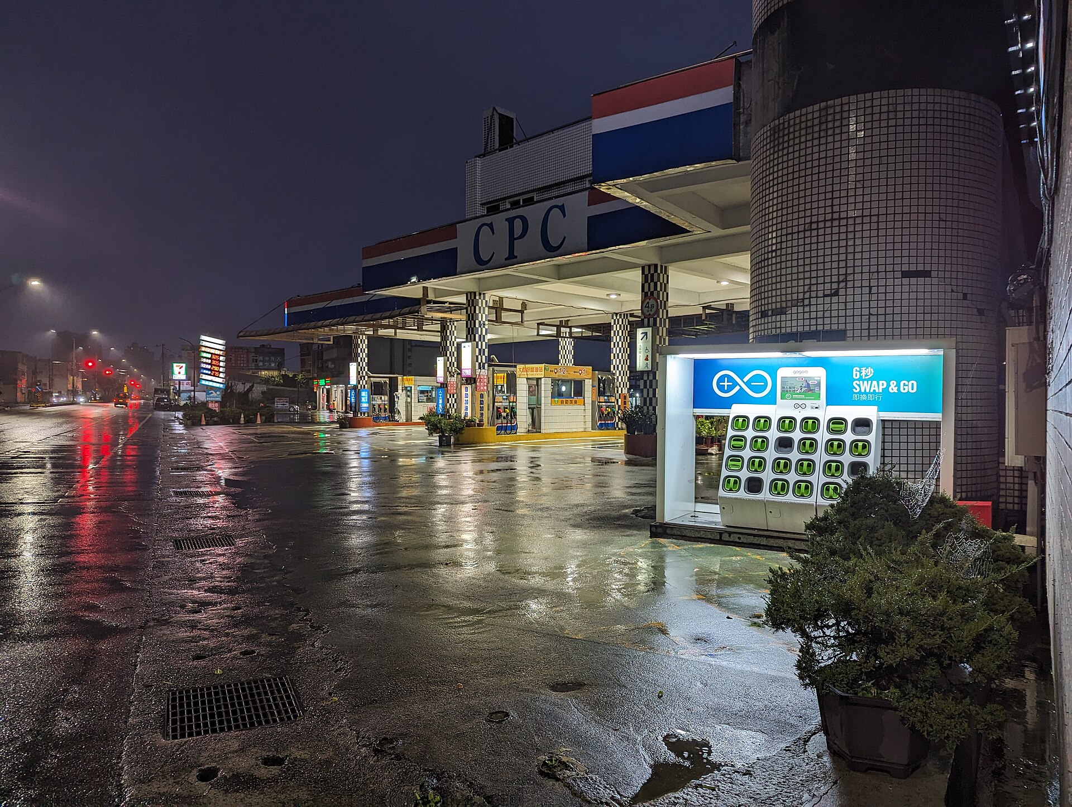
docs/slide_assets/swap.jpg
