huynhpham13790-rgb/Innowork-2026/docs/slide_assets/swap_cabinet.jpg

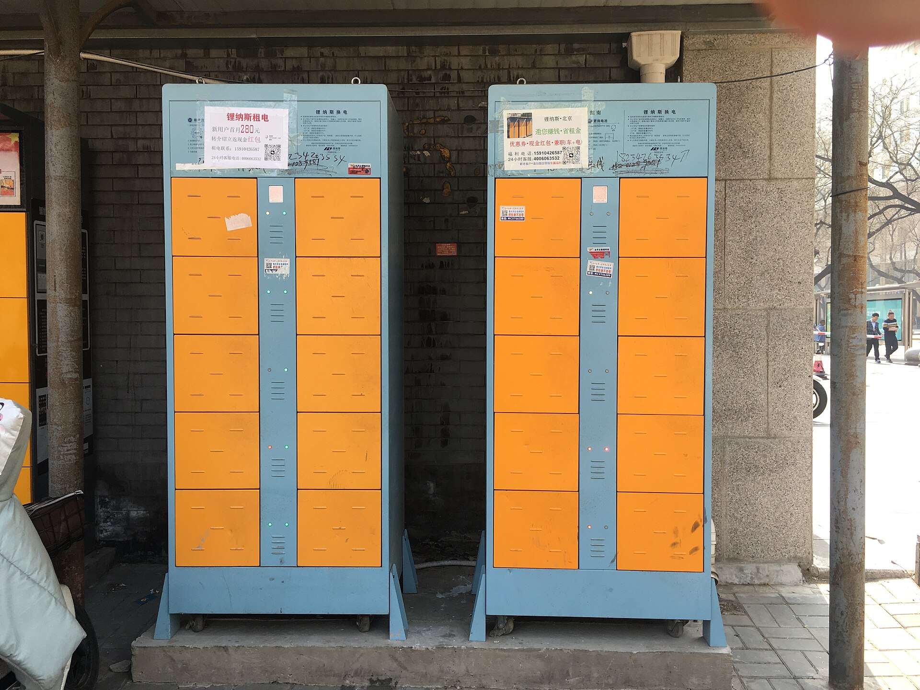
docs/slide_assets/swap_cabinet.jpg
