huynhpham13790-rgb/Innowork-2026/docs/standee/app_crop.png

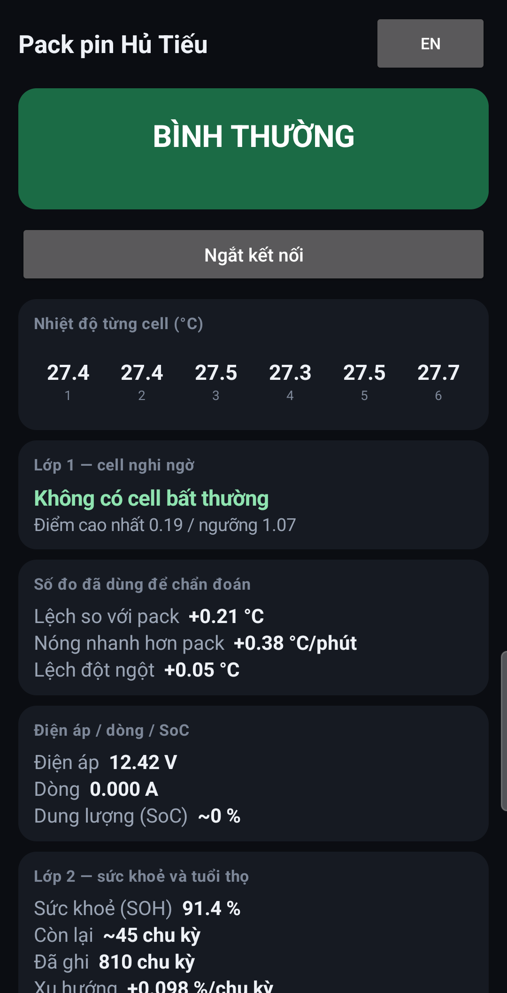
docs/standee/app_crop.png
