huynhpham13790-rgb/Innowork-2026/docs/standee/xem_truoc.png

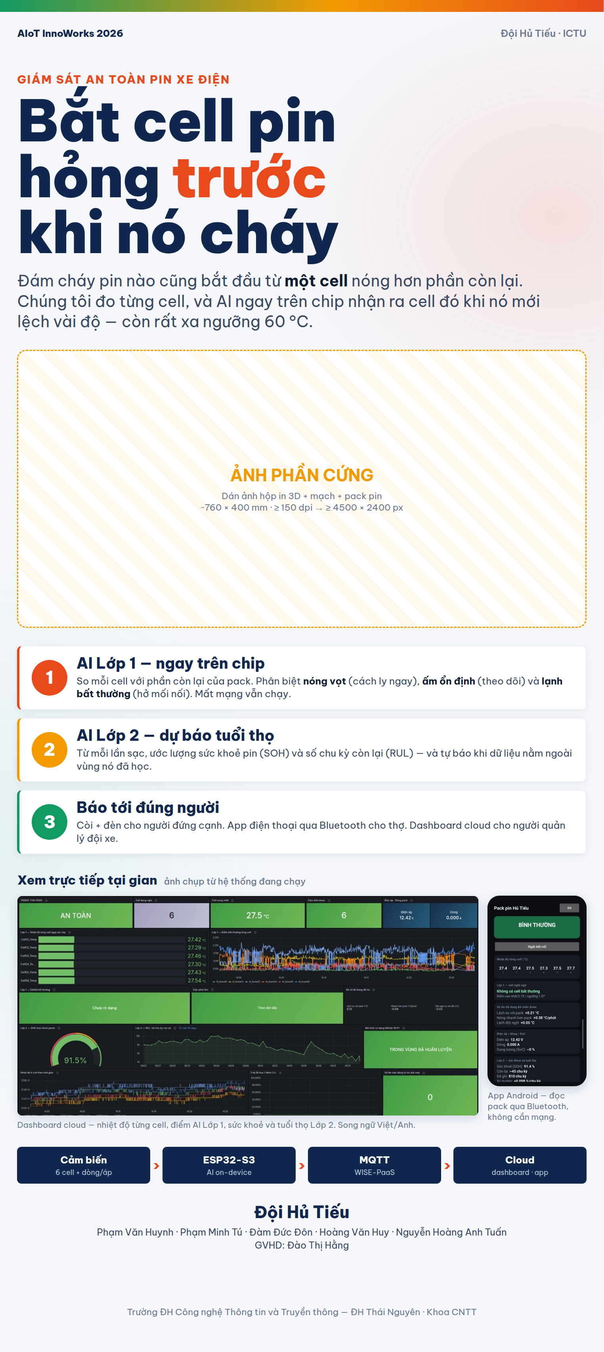
docs/standee/xem_truoc.png
