huynhpham13790-rgb/Innowork-2026/VEDCaPhenika/DANH_SACH_MUA_LINH_KIEN_DOT1_DOT2.xlsx

Sheet: ĐỢT 1 - Mua ngay
ĐỢT 1 — BẮT BUỘC MUA TRƯỚC (đủ để chạy demo bán kết 15/09/2026)
Đội Hủ Tiếu — ICTU | AIoT InnoWorks 2026 | Lập ngày 05/09/2026 | Giá tham khảo, phải xác nhận lại với shop
# | Nhóm | Tên linh kiện (tên để tìm/đặt hàng) | SL | Shop đề xuất | Giá/cái (₫) | Thành tiền (₫) | Link sản phẩm | ⚠️ Biến thể PHẢI chọn / Ghi chú | HĐ đỏ?
A. BỘ NÃO — không có cái này thì không làm được gì (mua đầu tiên)
1 | A. Vi điều khiển | ESP32-S3-DevKitC-1 N16R8 (16MB Flash / 8MB PSRAM) | 2 | icdayroi.com | 239000 |  | https://icdayroi.com/kit-esp32-s3-devkitc-1-n16r8 | ⚠️ PHẢI chọn đúng biến thể N16R8. Bản N8R2 / N8R8 KHÔNG đủ Flash cho buffer offline. Mua 2 cái: 1 chạy, 1 dự phòng — cháy 1 board sát ngày là hỏng cả cuộc thi. | Cần hỏi
2 | A. Vi điều khiển | (DỰ PHÒNG — chỉ mua nếu món #1 hết hàng) MKE-K01 ESP32-S3 N16R8 | 0 | hshop.vn | 230000 |  | https://hshop.vn/ | SL để 0 nên KHÔNG tính vào tổng. Dùng chip nạp CH343P (không phải CP2102) → phải cài driver CH343 riêng. GPIO35/36/37 đã bị PSRAM chiếm, không dùng được. Chỉ đổi SL thành 2 khi món #1 hết hàng. | Cần hỏi
B. CẢM BIẾN NHIỆT — trái tim của đề tài, thiếu là không có dữ liệu
3 | B. Cảm biến | DS18B20 loại đầu dò thép chống nước, dây 1m (6x50mm) | 10 | nshopvn.com | 19000 |  | https://nshopvn.com/product/cam-bien-nhiet-do-ds18b20-chong-nuoc/ | 8 con gắn 8 cell + 2 con dự phòng (dễ đứt dây khi hàn). Loại đầu dò TRỤ áp vào cell TRÒN chỉ tiếp xúc theo ĐƯỜNG → bắt buộc phải bôi keo tản nhiệt vào khe. | Cần hỏi
4 | B. Cảm biến | Điện trở 4.7kΩ 1/4W (pull-up cho bus 1-Wire) | 20 | icdayroi.com | 350 |  | https://icdayroi.com/dien-tro-4-7k-1-4w | ⚠️ Listing thường bán theo dải giá trị — PHẢI chọn đúng 4K7. Mua thêm 20 con 2K2 phòng khi bus dài bị lỗi CRC thì hạ trở kéo xuống. | Cần hỏi
5 | B. Cảm biến | Điện trở 2.2kΩ 1/4W (dự phòng cho bus dài) | 20 | icdayroi.com | 350 |  | https://icdayroi.com/dien-tro-2-2k-1-4w | Chỉ dùng nếu 4K7 bị lỗi đọc. Rẻ, mua kèm luôn cho đỡ phải đặt lần 2. | Cần hỏi
C. PACK PIN THÍ NGHIỆM 8S — đối tượng đo
6 | C. Pack pin | Cell 18650 Samsung INR18650-25R 2500mAh 20A (CHÍNH HÃNG, CÙNG LÔ) | 10 | nshopvn.com | 86000 |  | https://nshopvn.com/product/pin-18650-samsung-25r-2500mah/ | ⚠️ PHẢI mua 1 lần 10 viên CÙNG LÔ. Cell lệch nội trở sẽ tự sinh nhiệt khác nhau ngay từ đầu → Autoencoder học phải nhiễu thay vì học dị thường. LG HG2 tốt hơn nhưng shop có HĐ đỏ không bán. | Cần hỏi
7 | C. Pack pin | Đế/hộp nhựa giữ 4 cell 18650 NỐI TIẾP (không có pin bên trong) | 2 | hshop.vn | 9000 |  | https://hshop.vn/ | ⚠️ Listing có option 1/2/3/4 cell và nối tiếp/song song — PHẢI chọn '4 cell NỐI TIẾP'. Chọn nhầm song song là sai toàn bộ mạch. 2 đế nối tiếp nhau = 8S. | Cần hỏi
8 | C. Pack pin | Sạc pin 18650 rời đa năng LiitoKala Lii-500 (4 khe, đo dung lượng + nội trở) | 1 | nshopvn.com | 440000 |  | https://nshopvn.com/product/bo-sac-pin-liitokala-lii-500/ | ⚠️ MÓN QUAN TRỌNG NGẦM. Ngoài sạc, nó ĐO ĐƯỢC NỘI TRỞ từng viên → dùng để CHỌN 8 viên đồng đều nhất trong 10 viên. Đây chính là việc mà cả đề tài phụ thuộc vào. | Cần hỏi
D. BƠM NHIỆT (tạo dị thường để demo) — không có thì không có gì để phát hiện
9 | D. Sưởi | Điện trở sứ công suất 10W — GIÁ TRỊ 10R (10 Ohm) | 4 | icdayroi.com | 4000 |  | https://icdayroi.com/dien-tro-su-10w-10r | ⚠️ CHỌN ĐÚNG 10R. KHÔNG mua 1R/2R (5V đã ăn 25W/12,5W → cháy). 10R ở 5V=2,5W (sưởi chậm), 7V=4,9W (tốc độ demo tốt nhất), 10V=10W (kịch trần). | Cần hỏi
10 | D. Sưởi | Điện trở sứ 10W — 5R và 20R (mỗi loại 2 con, để thử dải công suất) | 4 | icdayroi.com | 4000 |  | https://icdayroi.com/dien-tro-su-10w | Tùy chọn. Gọi hỏi tồn kho trước — nhiều shop chỉ có 5R ở loại 25W. Không có cũng không sao, 10R là đủ. | Cần hỏi
11 | D. Sưởi | Module MOSFET công suất HA210N06 (kích mức logic 3.3V thật) | 2 | hshop.vn | 45000 |  | https://hshop.vn/ | ⚠️ ĐỪNG chỉ mua IRF520. IRF520 có Vgs(th) tới 4V → ESP32 3.3V kích không mở hết, MOSFET nóng và điện trở sưởi không đủ nhiệt. Mua cả 2 loại rồi thử. | Cần hỏi
12 | D. Sưởi | Module MOSFET IRF520 (mua kèm để đối chứng, rẻ) | 2 | icdayroi.com | 13000 |  | https://icdayroi.com/mach-cong-suat-mosfet-irf520 | Chỉ dùng được nếu kích cổng bằng 5V. Rẻ nên mua kèm để so sánh. | Cần hỏi
13 | D. Sưởi | Nguồn adapter 12V 2A (thay cho nguồn bàn 1,8 triệu) | 2 | icdayroi.com | 50000 |  | https://icdayroi.com/nguon-adapter-12v-2a | 💡 TIẾT KIỆM 1,75 TRIỆU: 12V trên 10R = 14,4W (quá tải), nhưng băm xung PWM 20–40% qua MOSFET → trung bình 2,9–5,8W, ĐÚNG dải cần. ESP32 điều khiển đường sưởi bằng phần mềm — demo còn đẹp hơn vặn núm tay. | Cần hỏi
E. TIẾP XÚC NHIỆT — quyết định số đo có thật hay không
14 | E. Lắp ráp | Keo tản nhiệt STARS-922 (hoặc silicone thermal paste bất kỳ) | 2 | icdayroi.com | 12000 |  | https://icdayroi.com/keo-tan-nhiet-stars-922 | ⚠️ BẮT BUỘC. Đầu dò trụ áp vào cell trụ chỉ chạm theo 1 đường → không có keo thì đo nhiệt độ không khí chứ không phải nhiệt độ cell. | Cần hỏi
15 | E. Lắp ráp | Băng keo Kapton chịu nhiệt 10mm (ép đầu dò vào thân cell) | 2 | nshopvn.com | 38000 |  | https://nshopvn.com/product/bang-keo-kapton-chiu-nhiet/ | Ép cơ học cho đầu dò dính chặt. Băng keo điện thường sẽ chảy/bong ở 50–60°C. | Cần hỏi
F. ĐỒ NGHỀ LẮP MẠCH — thiếu là không cắm được board
16 | F. Đồ nghề | Breadboard MB-102 830 lỗ | 2 | icdayroi.com | 35000 |  | https://icdayroi.com/breadboard-mb-102-830-lo | ⚠️ ĐỪNG mua loại 400 lỗ. Board ESP32-S3 44 chân cắm vào 400 lỗ là không còn hàng lỗ nào để đấu dây. | Cần hỏi
17 | F. Đồ nghề | Dây cắm breadboard đực-đực / đực-cái / cái-cái (mỗi loại 1 bó 40 sợi) | 3 | icdayroi.com | 8000 |  | https://icdayroi.com/day-cam-breadboard | Mua đủ cả 3 loại. DS18B20 ra dây trần nên cần loại cái-cái để nối qua domino/terminal. | Cần hỏi
18 | F. Đồ nghề | Đồng hồ vạn năng UNI-T UT33D+ (đo điện áp từng cell để đối chứng) | 1 | hshop.vn | 285000 |  | https://hshop.vn/ | Không có đồng hồ thì mọi lỗi đấu nhầm đều thành lỗi 'phần mềm' và mất cả buổi để mò. | Cần hỏi
TỔNG CỘNG

Sheet: ĐỢT 2 - Hoãn được
ĐỢT 2 — HOÃN ĐƯỢC (mua khi kinh phí về, kịp cho chung kết 27/11/2026)
Không món nào trong sheet này chặn demo bán kết. Nếu tiền về chậm, bỏ qua toàn bộ sheet này.
# | Nhóm | Tên linh kiện (tên để tìm/đặt hàng) | SL | Shop đề xuất | Giá/cái (₫) | Thành tiền (₫) | Link sản phẩm | ⚠️ Biến thể PHẢI chọn / Ghi chú | HĐ đỏ?
G. ĐO DÒNG & QUẢN LÝ PIN — nâng cấp cho vòng chung kết
1 | G. Đo dòng | Module cảm biến dòng INA228 (85V, 20-bit) | 2 | icdayroi.com | 420000 |  | https://icdayroi.com/cam-bien-dong-ina228 | ⚠️ KHÔNG dùng INA219 (chỉ 26V) — pack 8S sạc đầy 33,6V sẽ làm chết chip. INA228 đo luôn điện áp bus nên KHÔNG cần mạch chia áp + ADC nữa. | Cần hỏi
2 | G. Quản lý pin | BMS DALY Smart 8S Li-ion 3.7V có cân bằng, có cổng UART | 2 | icdayroi.com | 720000 |  | https://icdayroi.com/bms-daly-smart-8s | ⚠️ BẪY: listing mặc định thường là bản LiFePO4. PHẢI chọn 'Li-ion 3.7V 8S'. Bản smart đọc được ĐIỆN ÁP TỪNG CELL qua UART — điện áp thường lệch TRƯỚC nhiệt độ, ghép vào vector đặc trưng là lợi thế lớn. | Cần hỏi
3 | G. Sạc pack | Sạc pack 8S Li-ion 33.6V 2A (đầu DC 5.5x2.1) | 1 | icdayroi.com | 350000 |  | https://icdayroi.com/sac-pin-lithium-33-6v-2a | ⚠️ PHẢI là 33,6V (Li-ion 8x4,2V). Loại 29,2V là LiFePO4 — SAI hóa học, sạc không bao giờ đầy. Dòng 2A (~0,8C), KHÔNG mua loại 10A (3,3C sẽ phá cell). | Cần hỏi
H. GHI DỮ LIỆU & BẰNG CHỨNG ĐỐI CHỨNG
4 | H. Lưu trữ | Module đọc thẻ microSD SPI + thẻ 32GB Class10 | 2 | icdayroi.com | 45000 |  | https://icdayroi.com/module-doc-the-nho-micro-sd | Lưu dữ liệu thô khi mất mạng. Có thể thay tạm bằng ghi vào 16MB Flash của S3 trong giai đoạn đầu. | Cần hỏi
5 | H. Bằng chứng | Camera nhiệt gắn điện thoại InfiRay P2 Pro (hoặc FLIR ONE) | 1 | Shopee Mall | 4200000 |  | https://shopee.vn/search?keyword=infiray%20p2%20pro | 💡 Vũ khí thuyết phục giám khảo: chiếu ảnh nhiệt cạnh biểu đồ AI → chứng minh mô hình chỉ đúng chỗ cell nóng. Nhưng KHÔNG chặn tiến độ, mua sau cũng kịp. | Có (Mall)
I. NGUỒN PHÒNG THÍ NGHIỆM & HÀN MẠCH — chỉ mua nếu còn dư kinh phí
6 | I. Nguồn | Nguồn DC điều chỉnh DF-305D (0-30V 5A) | 1 | hshop.vn | 1800000 |  | https://hshop.vn/ | 💡 CÓ THỂ BỎ HẲN: adapter 12V 2A (50k) + PWM qua MOSFET đã thay thế được hoàn toàn cho mục đích sưởi. Chỉ mua nếu muốn có thiết bị lâu dài cho lab. | Cần hỏi
7 | I. Hàn mạch | Mạch đục lỗ (perfboard) 7x9cm + thiếc + nhựa thông | 5 | icdayroi.com | 12000 |  | https://icdayroi.com/board-duc-lo | Dùng để chuyển từ breadboard sang bản chạy ổn định trước chung kết 27/11. | Cần hỏi
8 | I. Hàn mạch | Mỏ hàn nhiệt độ điều chỉnh 60W + chân đế | 1 | hshop.vn | 250000 |  | https://hshop.vn/ | Nếu trường/khoa đã có thì bỏ qua. | Cần hỏi
9 | I. Dây dẫn | Dây silicone chịu nhiệt 18AWG (đỏ + đen, mỗi màu 2m) | 4 | icdayroi.com | 15000 |  | https://icdayroi.com/day-dien-silicone-18awg | Dùng cho đường dòng lớn của pack. Dây thường sẽ giòn khi gần điện trở sưởi. | Cần hỏi
TỔNG CỘNG

Sheet: LƯU Ý QUAN TRỌNG
1. HÓA ĐƠN ĐỎ (VAT) — ĐỌC TRƯỚC KHI ĐẶT BẤT KỲ ĐƠN NÀO
Vấn đề | KHÔNG shop nào trong danh sách này công bố chính sách xuất hóa đơn VAT trên website. Cột 'HĐ đỏ?' ghi 'Cần hỏi' là vì mình CHƯA xác minh được, không phải vì shop từ chối.
Việc phải làm TRƯỚC | Nhắn tin / gửi mail hỏi từng shop: 'Shop có xuất hóa đơn GTGT (VAT) cho đơn hàng không? Cần thông tin gì của bên mua?' — HỎI BẰNG VĂN BẢN để có bằng chứng, đừng gọi điện suông.
Ai nhiều khả năng có | hshop.vn (có chuỗi cửa hàng vật lý, pháp nhân rõ) > icdayroi.com > nshopvn.com > Shopee Mall. Người bán cá nhân trên Shopee gần như KHÔNG xuất được HĐ đỏ.
Liên hệ | hshop.vn: trang /lien-he. nshopvn.com: 0932734186 / dientunshop@gmail.com.
Chiến thuật | Gom càng ít shop càng tốt — mỗi shop là một bộ hồ sơ hóa đơn phải làm. Nếu 1 shop chịu xuất HĐ và có ~80% danh mục, mua hết ở đó dù đắt hơn 10-15% vẫn lời về mặt thủ tục.
2. NĂM CÁI BẪY CHỌN BIẾN THỂ — chọn sai là mua lại
BMS DALY | Listing mặc định là LiFePO4. Phải chọn Li-ion 3.7V 8S. Chọn nhầm → ngưỡng cắt sai, pack không bao giờ sạc đầy.
Sạc pack | 33,6V = Li-ion 8S (đúng). 29,2V = LiFePO4 8S (SAI). Dòng 2A, không phải 10A.
Đế pin | Phải chọn '4 cell NỐI TIẾP'. Loại song song cho ra 4,2V thay vì 16,8V.
Điện trở kéo | Listing bán theo dải 1K2→10K, phải bấm chọn đúng 4K7.
Board ESP32-S3 | Phải là N16R8. N8R2/N8R8 thiếu Flash cho buffer offline.
3. HAI QUYẾT ĐỊNH TIẾT KIỆM ĐÃ CHỐT
Bỏ nguồn bàn 1,8tr | Adapter 12V 2A (50k) + PWM qua MOSFET → công suất trung bình 2,9–5,8W trên điện trở 10R, đúng dải cần. ESP32 điều khiển được bằng phần mềm, demo đẹp hơn vặn núm.
Sạc rời thay sạc pack (đợt 1) | Sạc từng viên cắt đúng 4,2V nên giai đoạn 1 KHÔNG cần BMS → hoãn được 1,44 triệu. Đánh đổi: ESP32 không quan sát được pha sạc tại chỗ, mà đó là lúc ~15–18% vụ cháy xảy ra và là lúc tín hiệu suy giảm rõ nhất. Chấp nhận cho bán kết, phải bổ sung trước chung kết.
4. AN TOÀN — LÀM TRƯỚC LẦN SƯỞI ĐẦU TIÊN
Điện trở ≠ cell | Điện trở sứ 10W chạy kịch trần có thể vượt 200°C bề mặt. Mình cần CELL ở 50°C, không phải ĐIỆN TRỞ ở 200°C. Chạy ở 2–5W thôi.
Cắt cứng firmware | Gá 1 con DS18B20 áp thẳng vào cell bị sưởi. Viết cắt cứng: chạm 60°C → MOSFET ngắt ngay. Viết cái này TRƯỚC khi sưởi lần đầu, không phải sau.
Đo baseline trước | 8 cell nghỉ cùng điều kiện chênh nhau bao nhiêu độ? Đó là sàn nhiễu. Mọi dị thường phải vượt trên nó mới có nghĩa.
5. CHÚ THÍCH CỘT
Cột 'Thành tiền' | Là công thức =SL × Giá. Sửa số lượng hoặc đơn giá là tổng tự tính lại.
Ô nền vàng | Là chỗ dễ mua sai — đọc kỹ trước khi bấm đặt hàng.
Giá | Là giá tham khảo tháng 9/2026, phải xác nhận lại khi đặt. Gọi hỏi tồn kho ESP32-S3 N16R8 và BMS 8S trước — hai món này hay hết hàng.
Còn 10 ngày tới bán kết 15/09/2026. Đặt nhóm A + B + C ngay hôm nay.
