huynhpham13790-rgb/Innowork-2026/docs/TEST_VA_ACCEPTANCE.md

# Test & Acceptance Criteria — thế nào là "chạy đúng"

Không có mục nào ở đây được tick bằng cảm giác. Mỗi mục phải có **bằng chứng chạy được** ghi vào `docs/BANG_CHUNG_KIEM_THU_*.md`.

Ký hiệu: ✅ đã kiểm chứng · ⬜ chưa làm · 🔶 làm rồi nhưng chưa có board thật

---

## AC-01 — Đường truyền ESP → cloud thông suốt

| # | Tiêu chí | Cách kiểm | Trạng thái |
|---|---|---|---|
| 1.1 | 4 container đều `running` | `docker compose ps` | ✅ 06/09 |
| 1.2 | Node-RED nối được Mosquitto có auth | log `Connected to broker` | ✅ 06/09 |
| 1.3 | Payload đúng contract → ghi được vào InfluxDB | query Flux thấy đủ 8 tag | ✅ 06/09 |
| 1.4 | Grafana vẽ được 8 đường nhiệt độ | dashboard `hutieu-pin`, panel + ô cảnh báo ngưỡng | ✅ 06/09 |
| 1.5 | Firmware biên dịch cho ESP32-S3 | `arduino-cli compile` | ✅ 06/09 |
| 1.6 | ESP32 thật bắn lên và thấy trên dashboard | nạp board, 800 điểm / 100 mỗi cell, không mất gói | ✅ 06/09 |

## AC-02 — Timestamp do thiết bị quyết định (nền của màn demo)

| # | Tiêu chí | Cách kiểm | Trạng thái |
|---|---|---|---|
| 2.1 | Gói có `ts` lùi 2 giờ được vẽ đúng ở vị trí 2 giờ trước | bắn 1 gói backdate, query Influx | ✅ 06/09 |
| 2.2 | Gói `ts` năm 1970 (NTP fail) bị chặn kèm cảnh báo rõ | bắn gói ts 1970, xem `docker compose logs nodered` | ✅ 06/09 |
| 2.3 | ESP32 không gửi khi NTP chưa đồng bộ | `timeIsValid()` chặn trong `publishData()` | ✅ 06/09 (NTP đồng bộ OK trên board) |
| 2.4 | WISE-IoT thật có tôn trọng `ts` không | **ẩn số** — chỉ trả lời được khi có tài khoản | ⬜ chờ tài khoản |

## AC-03 — Store-and-forward (90 giây đắt nhất của bài demo)

| # | Tiêu chí | Cách kiểm | Trạng thái |
|---|---|---|---|
| 3.1 | Mất mạng → dữ liệu ghi xuống flash, không mất | `test/run_test.sh` TEST 1 | ✅ 06/09 |
| 3.2 | Nối lại → đẩy bù **đúng thứ tự gốc** | TEST 1 | ✅ 06/09 |
| 3.3 | Rớt mạng giữa lúc đang đẩy bù → phần còn lại giữ nguyên, không mất không đảo | TEST 2 | ✅ 06/09 |
| 3.4 | Đệm nhiều hơn 1 lô → chia nhiều lượt, không nghẽn `loop()` | TEST 3 | ✅ 06/09 |
| 3.5 | Flash đầy → bỏ dữ liệu cũ, giữ dữ liệu mới, không phình vô hạn | TEST 4 | ✅ 06/09 |
| 3.6 | **Trên board thật:** ngắt 60s, nối lại, dữ liệu bù về đúng vị trí thời gian | 83 điểm liên tục, 0 lỗ hổng | ✅ 06/09 |
| 3.7 | Không đẩy bù trước khi subscriber kịp nối lại | TEST 6 + chạy thật trên board | ✅ 06/09 |

## AC-04 — An toàn khi đưa lên máy chủ công cộng

| # | Tiêu chí | Cách kiểm | Trạng thái |
|---|---|---|---|
| 4.1 | Node-RED (1880) không lắng nghe trên 0.0.0.0 | `docker compose ps` thấy `127.0.0.1:1880` | ✅ 06/09 |
| 4.2 | InfluxDB (8086) không lắng nghe trên 0.0.0.0 | như trên | ✅ 06/09 |
| 4.3 | MQTT bắt buộc đăng nhập | `allow_anonymous false` + nối thử không user → bị từ chối | ✅ 06/09 |
| 4.4 | Không có secret nào trong git | `git log -p` không thấy `.env`, `passwd` | ✅ 06/09 |
| 4.5 | Lỗi ghi DB hiện trong `docker compose logs`, không im lặng | ép token sai, xem log | ✅ 06/09 |
| 4.6 | Chạy thử trên VPS công cộng thật | dựng lên rồi bắn từ ESP qua 4G | ⬜ trước ngày thi vài hôm |

## AC-05 — Sẵn sàng ngày thi

| # | Tiêu chí | Trạng thái |
|---|---|---|
| 5.1 | Phát WiFi từ điện thoại, không dùng mạng hội trường | ⬜ |
| 5.2 | Có đường lùi: cloud Advantech hỏng → đổi 1 dòng về Plan B | 🔶 cơ chế có sẵn (`#define STAGE`), chưa diễn tập |
| 5.3 | Diễn tập trọn kịch bản 5 phút ít nhất 2 lần | ⬜ |
| 5.4 | Dashboard Grafana đã dựng sẵn, không dựng tại chỗ | ⬜ |

## AC-06 — Lớp 1: AI phát hiện cell bất thường

| # | Tiêu chí | Cách kiểm | Trạng thái |
|---|---|---|---|
| 6.1 | Mô hình < 50 KB | 1,4 KB float32 (356 tham số) | ✅ 11/09 |
| 6.2 | Bắt 100% ca ramp ở mọi tốc độ đã thử | `tune_threshold.py` | ✅ 11/09 |
| 6.3 | **Bản C khớp bản Python từng số** | `test_c_vs_python.py`, lệch <1e-6 | ✅ 11/09 |
| 6.4 | Báo động giả < 1 lần/ngày | 0,033/giờ = 1 lần mỗi 1,3 ngày | ✅ 11/09 |
| 6.5 | Chạy được trên ESP32 thật, 1 Hz | +5,5 KB flash, +2,9 KB RAM | ✅ 11/09 |
| 6.6 | Phát hiện đúng cell trên board thật | cell 5: 5,189 vs 7 cell còn lại ~0,4 | ✅ 11/09 |
| 6.7 | Kết quả AI lên tới dashboard, không đổi data contract | query InfluxDB thấy `AI_*` | ✅ 11/09 |
| 6.8 | Kiểm chứng trên mất cân bằng THẬT (Stanford/Warwick) | — | ⬜ **chưa làm** |
| 6.9 | Ngưỡng cứng 60°C vẫn chạy song song | `runAI()` kiểm độc lập | ✅ 11/09 |
| 6.10 | 8 cảm biến DS18B20 lên bus, ROM ổn định | 8/8 con, ROM giống nhau qua 4 lần chạy | ✅ 14/09 |
| 6.11 | Nhiễu nền nhỏ hơn tín hiệu cần bắt | std 0,019–0,033 °C | ✅ 14/09 |
| 6.12 | Cả 8 con có nguồn riêng (hỏi từng ROM) | 1 600 lần hỏi, 0 lần ký sinh | ✅ 14/09 |
| 6.13 | Đọc không chặn vòng lặp 1 Hz | chặn và không chặn đều 0,00 % lỗi | ✅ 14/09 |
| 6.14 | **Bus sạch: 3 lần × ≥5 phút liên tiếp, lỗi 0,00 %** | 3×2 800 đọc, 0 lỗi, sau khi lau khô đầu dò | ✅ 14/09 |
| 6.15 | Firmware đếm + báo lỗi cảm biến theo từng kênh | `cell_temp.cpp` + tag `Sensor_*` lên cloud | ✅ 14/09 |
| 6.16 | Bảng offset đo trong nước, 2 lần khớp ~0,05 °C | 2 lần khớp 0,025 °C; lệch thật 0,3665 °C | ✅ 14/09 — `ds18b20_offsets.h` |
| 6.17 | Bỏ breadboard, hàn/terminal block trước khi gắn pack | — | ⬜ chưa làm |
| 6.8b | **Kiểm chứng Lớp 1 trên pack THẬT có lỗi cố ý (McMaster)** | `ai/validate_mcmaster.py` | ❌ **15/09 — TRƯỢT**, không chuyển giao zero-shot |
| 6.40 | **Chuyển Lớp 1 sang 11 đặc trưng thuần tương đối** | ngưỡng 1,0707 giữ 30 s; C khớp Python 11/11 | ✅ 15/09 — QĐ-033 |
| 6.41 | `test_c_vs_python.py` không viết cứng số đặc trưng | đọc từ `AI_N_FEAT` trong `cell_ai.h` | ✅ 15/09 |
| 6.42 | Lớp 1 (11 đặc trưng) chạy thật trên pack của đội | — | ⬜ chờ dán đầu dò lên pin |
| 6.37 | **AE thuần tương đối: giữ được khả năng phát hiện?** | tốt hơn toàn diện trên NASA; drift 46%→88% | ✅ 15/09 |
| 6.38 | **AE thuần tương đối: chuyển giao sang pack lạ?** | lỗi 0,36–1,26% vs bình thường ≤0,065% — tách ~19 lần | ⚠️ 15/09 dùng được, còn 1 ca trượt |
| 6.39 | ESP32 tự tìm broker, không ghim IP | `broker_find.cpp` 3 đường lùi, chạy thật OK | ✅ 15/09 |
| 6.35 | Chuẩn hoá 4 đặc trưng bối cảnh theo dải vận hành của chính pack | — | ⬜ sửa đúng nguyên nhân tìm được ở 6.8b |
| 6.36 | Tách nguyên nhân trượt: hạ dữ liệu NASA xuống bước 1 °C rồi chạy lại | — | ⬜ làm được ngay, không cần phần cứng |
| 6.31 | **Driver INA228 viết sẵn trước khi linh kiện về** | `pack_meter.{h,cpp}`, bench giải mã 14/14 đạt | ✅ 15/09 |
| 6.32 | Dòng/áp thật thay hằng số bịa `0.0f`/`80.0f` trong `runAI()` | có `Meter_IsReal` lên dashboard khi vẫn là giả định | ✅ 15/09 (mã); ⬜ chờ chip |
| 6.33 | Đo lại `PM_R_SHUNT` bằng nguồn dòng đã biết | — | ⬜ **bắt buộc trước khi tin số Lớp 2** (~5 % sai số) |
| 6.34 | SOC thật bằng đếm coulomb thay vì xấp xỉ tuyến tính từ điện áp | — | ⬜ chưa làm; hiện dùng ước lượng thô, sai >20 đ.p.t. ở vùng giữa |
| 6.30 | **Đo mức đánh đổi khi bớt cảm biến (8/4/2)** | `ai/sensor_count_study.py` — ramp trễ ×2,6 và ×7; offset N=2 bằng 0 % | ✅ 15/09 |
| 6.22 | **Còi + LED cảnh báo tại chỗ** (không cần mạng) | `alarm.cpp`, bench 11/11 đạt, LED RGB trên board | ✅ 15/09 — logic xong, còi rời chưa về (`AL_PIN_BUZZER -1`) |
| 6.24 | Báo động có 4 mức, phân biệt được bằng nhịp lẫn màu | `test/alarm_bench` TH-A…TH-D | ✅ 15/09 |
| 6.25 | Ngưỡng cứng 60 °C kích được KỂ CẢ khi AI im hoàn toàn | TH-E: `ai_alarm=false`, vẫn NGUY KỊCH | ✅ 15/09 |
| 6.26 | Trễ 5 °C chống còi kêu ngắt quãng quanh ngưỡng | TH-F: 57 °C vẫn kêu, 54,5 °C mới nhả | ✅ 15/09 |
| 6.27 | Mất cảm biến báo màu RIÊNG, không trộn vào màu đỏ | TH-G xanh dương; TH-H không xoá báo động đang có | ✅ 15/09 |
| 6.28 | Mất cả bus không làm đèn đứng hình | nhánh `isnan` vẫn gọi `gAlarm.update(...,true)` | ✅ 15/09 |
| 6.29 | Tắt tiếng được, và tắt tiếng tự huỷ khi leo thang | nút BOOT; `if (lvl_ > prev) muted_ = false` | ✅ 15/09 (logic; chờ còi để nghe thật) |
| 6.23 | Rơ-le/MOSFET ngắt đường sạc khi báo động | — | ⬜ chưa làm, cần cân nhắc rủi ro ngắt sai |
| 6.18 | Lớp 1 chạy trên nhiệt độ THẬT (không mô phỏng) | bench `cell_temp_ai_bench`, `USE_REAL_TEMP 1` | ✅ 14/09 (chưa chạy toàn tuyến, thiếu WiFi) |
| 6.19 | Hiệu chỉnh offset thu hẹp độ rộng trên board thật | thô 0,375 → 0,030 °C (12,4 lần) | ✅ 14/09 |
| 6.20 | Lớp 1 im lặng khi 8 cell cùng nhiệt độ | 0/251 mẫu báo động; điểm 0,32 vs ngưỡng 1,85 | ✅ 14/09 |
| 6.21 | `runAI()` và `publishData()` dùng chung một bộ số đo | `sampleCellTemps()` | ✅ 14/09 |

## AC-07 — Lớp 2: Dự báo tuổi thọ (RUL/SOH), chạy ở CẢ cloud và chip

| # | Tiêu chí | Cách kiểm | Trạng thái |
|---|---|---|---|
| 7.1 | Chỉ dùng đặc trưng đo được ngoài đời (pha sạc) | `nasa_prepare.py`, không dùng dung lượng phóng | ✅ 11/09 |
| 7.2 | Đánh giá trên pin CHƯA TỪNG THẤY | leave-one-battery-out, 4 pin | ✅ 11/09 |
| 7.3 | Thắng baseline "đoán trung bình" | 12,2 vs 25,8 chu kỳ MAE | ✅ 11/09 |
| 7.4 | So với LSTM như tài liệu đề xuất | LSTM 20,3 — **thua** tuyến tính 12,2 | ✅ 11/09 (kết quả ngược kỳ vọng) |
| 7.5 | Sai số dự đoán sớm (25–50% vòng đời) | 9,8 chu kỳ | ✅ 11/09 |
| 7.6 | SOH có ích thương mại | RMSE 3,8 điểm phần trăm | ✅ 11/09 |
| 7.7 | Kiểm chéo trên bộ dữ liệu thứ hai (UPC/CALCE) | — | ⬜ **chưa làm** |
| 7.8 | Nối luồng thật: ESP32 → cloud tính → dashboard | chạy trên board, RUL 85,2→79,6 | ✅ 11/09 |
| 7.9 | Bản C của đặc trưng sạc khớp bản Python | `test_charge_cycle.py` | ✅ 11/09 |
| 7.10 | Cảnh báo khi mô hình ngoại suy | cờ `Extrapolating` + log | ✅ 11/09 |
| 7.11 | Hiệu chỉnh lại hệ số trên pack THẬT của đội | — | ⬜ **bắt buộc trước khi tin con số RUL** |
| 7.12 | Chip tự tính RUL/SOH khi mất mạng | log `[RUL ] tren chip` trên board thật | ✅ 22/09 |
| 7.13 | Chip và cloud ra CÙNG một số | `test_rul_c_vs_js.py`, 500 chu kỳ, lệch 3,2e-5 | ✅ 22/09 |
| 7.14 | Kết quả trên chip lên tới cloud (`ONB_*`) | bắt bằng `mosquitto_sub` | ✅ 22/09 |
| 7.15 | Lịch sử chu kỳ sống qua mất điện | reset cứng → `lich su: 7 chu ky` | ✅ 22/09 |
| 7.16 | Không báo xu hướng khi chưa đủ dữ liệu | `ONB_SOH_Slope` vắng ở n=2, có ở n=3 | ✅ 22/09 |

Bằng chứng 7.12–7.16: `docs/BANG_CHUNG_LOP2_TREN_CHIP_2026-09-22.md`.

---

## Cách chạy bộ test

**Test store-and-forward (không cần board, ~10 giây):**
```bash
cd VEDCaPhenika/esp32s3_wiseiot_test && ./test/run_test.sh
```

**Test biên dịch firmware:**
```bash
arduino-cli compile --fqbn esp32:esp32:esp32s3:PartitionScheme=default_8MB,FlashSize=16M \
  VEDCaPhenika/esp32s3_wiseiot_test
```

**Test đường truyền cloud (cần Docker):** làm theo `VEDCaPhenika/PLAN_B_CLOUD.md`, rồi bắn thử một gói bằng `mosquitto_pub` và query lại InfluxDB. Các bước cụ thể và kết quả mong đợi nằm trong `docs/BANG_CHUNG_KIEM_THU_2026-09-06.md`.

## AC-08 — Tắt tiếng ở mức NGUY KỊCH và song ngữ (QĐ-045, QĐ-046)

| # | Tiêu chí | Cách kiểm | Trạng thái |
|---|---|---|---|
| 8.1 | Vào được mức NGUY KỊCH | hạ tạm ngưỡng xuống 27 °C | ✅ 22/09 |
| 8.2 | Còi kêu ở mức NGUY KỊCH | log `[ALRM] coi: KEU` | ✅ 22/09 |
| 8.3 | Tắt được tiếng từ app ở mức NGUY KỊCH | log `coi: IM` | ✅ 22/09 |
| 8.4 | Tự bật lại sau 2 phút | log `het han tat tieng o muc NGUY KICH` | ✅ 22/09 |
| 8.5 | Ngưỡng đã trả về 60 °C sau khi thử | MQTT `Alarm_Level = 0` @ 27,7 °C | ✅ 22/09 |
| 8.6 | Nút trên app phản ánh trạng thái chip | đặc tính `000A`, đếm lùi 4:54 | ✅ 22/09 |
| 8.7 | App song ngữ Việt/Anh | ảnh chụp cả hai ngôn ngữ | ✅ 22/09 |
| 8.8 | Dashboard song ngữ | `/hutieu`, nhớ trong localStorage | ✅ 22/09 |
| 8.9 | Grafana bản tiếng Anh | `make_dashboard.py --lang en` → `hutieu-pin-en` | ✅ 22/09 |
| 8.10 | Thử ở **60 °C thật** bằng sưởi | — | ⬜ **chưa** — bài 8.1 xác nhận đường đi, không xác nhận ngưỡng |

Bằng chứng: `docs/BANG_CHUNG_NGUY_KICH_2026-09-22.md`.
