huynhpham13790-rgb/Innowork-2026/VEDCaPhenika/esp32s3_wiseiot_test/esp32s3_wiseiot_test.ino

/* =============================================================================
 *  Đội Hủ Tiếu — AIoT InnoWorks 2026
 *  Test đường truyền: ESP32-S3-DevKitC-1 N16R8  ->  WISE-IoT (EdgeSync360/EdgeHub)
 *
 *  Chạy theo 2 GIAI ĐOẠN, đổi bằng #define STAGE bên dưới:
 *    STAGE 1 : bắn lên broker công cộng (HiveMQ). KHÔNG cần tài khoản WISE-IoT.
 *              -> Chứng minh: WiFi OK, MQTT OK, JSON đúng format, timestamp đúng.
 *    STAGE 2 : bắn lên WISE-IoT IoT Hub thật. Chỉ đổi thông tin đăng nhập,
 *              KHÔNG phải sửa logic. Nếu STAGE 1 chạy mà STAGE 2 hỏng
 *              => lỗi nằm ở credential/tenant, không phải ở code.
 *
 *  Dữ liệu: nhiệt độ giả lập cho PACK_N_CELLS cell (pack 6S). Một cell được cho nóng dần lên
 *  để có sẵn một "bất thường" nhìn thấy trên dashboard.
 *
 *  Thư viện cần cài (Arduino IDE > Library Manager):
 *    - PubSubClient   (Nick O'Leary)
 *    - ArduinoJson    (Benoit Blanchon, v7)
 *  Board: "ESP32S3 Dev Module"  (esp32 by Espressif >= 3.0)
 * ============================================================================= */

#define STAGE 1          // <<<<<< ĐỔI 1 -> 2 khi đã có credential WISE-IoT

#include <WiFi.h>
#include <WiFiClientSecure.h>
#include <HTTPClient.h>
#include <PubSubClient.h>
#include <ArduinoJson.h>
#include <LittleFS.h>
#include <time.h>
#include "cell_ai.h"
#include "charge_cycle.h"
#include "cell_temp.h"
#include "alarm.h"
#include "pack_meter.h"
#include "broker_find.h"
#include "demo_heater.h"
#include "ble_view.h"
#include "rul_onboard.h"

// ---------------------------------------------------------------- Nguồn nhiệt độ
// 1 = đọc 8 con DS18B20 thật · 0 = quay lại giả lập (khi tháo cảm biến ra)
// Giữ đường lùi này vì ngày thi mà dây tuột thì vẫn còn cái để diễn.
#define USE_REAL_TEMP 1
#define TEMP_PIN      4      // bus 1-Wire, khớp với các sketch trong test/

// Bí mật (mật khẩu WiFi + MQTT). Phải include TRƯỚC khối WiFi bên dưới vì
// danh sách mạng lấy từ SECRET_WIFI_LIST trong file này.
#include "arduino_secrets.h"

// ---------------------------------------------------------------- WiFi
// Danh sách mạng nằm trong arduino_secrets.h (không commit), thử theo thứ tự
// ưu tiên. Board chạy lúc ở trường, lúc ở nhà, lúc qua hotspot điện thoại —
// ghim một SSID nghĩa là mỗi lần đổi chỗ phải sửa code rồi nạp lại.
struct WifiCred { const char* ssid; const char* pass; };
static const WifiCred WIFI_LIST[] = { SECRET_WIFI_LIST };
static const int WIFI_N = sizeof(WIFI_LIST) / sizeof(WIFI_LIST[0]);
static int gWifiIdx = 0;            // mạng đang thử

const char* WIFI_SSID = WIFI_LIST[0].ssid;   // chỉ để in log cho quen mắt

// Mạng mở thì phải gọi WiFi.begin(ssid) MỘT tham số. Truyền chuỗi rỗng làm
// tham số mật khẩu khiến driver vẫn thương lượng theo kiểu có mã hoá và hỏng
// im lặng — nối mãi không được mà không báo lỗi gì.
static inline void wifiStart() {
  const WifiCred& c = WIFI_LIST[gWifiIdx];
  Serial.printf("[WiFi] thu mang %d/%d: %s\n", gWifiIdx + 1, WIFI_N, c.ssid);
  WiFi.disconnect(true);            // bỏ phiên cũ, nếu không thì đổi SSID không ăn
  if (c.pass && c.pass[0]) WiFi.begin(c.ssid, c.pass);
  else                     WiFi.begin(c.ssid);
}

// Chuyển sang mạng kế tiếp trong danh sách, quay vòng. Gọi khi một mạng thử
// mãi không được — thà quay vòng còn hơn kẹt vĩnh viễn ở mạng đầu tiên khi
// mang board tới chỗ khác.
static inline void wifiNext() {
  gWifiIdx = (gWifiIdx + 1) % WIFI_N;
}
// LƯU Ý: ESP32-S3 chỉ bắt WiFi 2.4GHz. Wifi 5GHz sẽ không hiện/không nối được.

// ---------------------------------------------------------------- STAGE 2: WISE-IoT
// Cách A (khuyến nghị): dán Credential Key lấy từ portal, ESP tự gọi DCCS lấy
// host/port/user/pass. Đây đúng là việc mà EdgeAgent SDK làm bên trong.
#define WISE_USE_DCCS   1
const char* DCCS_API_URL  = "https://api-dccs-ensaas.education.wise-paas.com";
const char* DCCS_CRED_KEY = "DAN_CREDENTIAL_KEY_VAO_DAY";

// Cách B: nhập tay nếu portal cho thẳng thông tin broker
const char* MQTT_HOST_MANUAL = "";
const int   MQTT_PORT_MANUAL = 8883;
const char* MQTT_USER_MANUAL = "";
const char* MQTT_PASS_MANUAL = "";

// nodeId lấy ở portal (EdgeHub > Node). deviceId do mình tự đặt.
const char* NODE_ID   = "DAN_NODE_ID_VAO_DAY";   // dạng UUID
const char* DEVICE_ID = "BatteryPack01";

// ---------------------------------------------------------------- STAGE 1: broker riêng / công cộng
// Mặc định: broker công cộng HiveMQ, không cần tài khoản.
// PLAN B: đổi TEST_HOST thành IP server của đội + điền TEST_USER/TEST_PASS.
//   ví dụ: TEST_HOST = "203.0.113.45";  TEST_USER = "hutieu";  TEST_PASS = "matkhau";
// Để TEST_USER = "" thì nối ẩn danh (dùng cho HiveMQ công cộng).
// Broker của đội (Plan B). IP phải khớp LAN_IP trong planb_cloud/.env — ĐỔI
// MỖI KHI ĐỔI MẠNG. Xem IP máy chủ bằng: hostname -I
const char* TEST_HOST = "172.172.3.126";   // cap nhat 21/09; chi la duong lui cuoi, mDNS di truoc
const int   TEST_PORT = 1883;

// Mật khẩu KHÔNG nằm trong file này — nó bị commit lên GitHub.
// Xem arduino_secrets.example.h để biết cách tạo arduino_secrets.h.
const char* TEST_USER = SECRET_MQTT_USER;
const char* TEST_PASS = SECRET_MQTT_PASS;

// ---------------------------------------------------------------- Cấu hình chung
/* Số cell đẩy lên MQTT. PHẢI bằng AI_N_CELLS: vòng lặp publishData() đọc
   gCellTemp[] — mảng có kích thước AI_N_CELLS — theo chỉ số chạy tới NUM_CELLS.
   Trước 21/09 hai con số này là hai hằng số rời nhau; hạ AI_N_CELLS xuống 6 mà
   quên NUM_CELLS thì vòng lặp đọc tràn mảng và đẩy hai cell RÁC lên dashboard,
   không có lỗi nào báo. Buộc cả hai về cùng một nguồn (QĐ-038). */
const int   NUM_CELLS      = PACK_N_CELLS;
static_assert(NUM_CELLS == AI_N_CELLS, "NUM_CELLS phai bang AI_N_CELLS");
const long  PUBLISH_MS     = 2000;    // 0.5 Hz cho lúc test
const long  HEARTBEAT_MS   = 60000;   // đúng mặc định của EdgeAgent

// ---------------------------------------------------------------- Store-and-forward
// Mất mạng thì gói dữ liệu được ghi xuống flash, nối lại thì đẩy bù lên theo
// đúng thứ tự, giữ nguyên `ts` gốc. Đây là màn 90 giây trong kịch bản demo:
// rút mạng -> ESP đệm -> cắm lại -> dữ liệu bù về đúng vị trí thời gian.
const char* SPOOL_PATH      = "/spool.jsonl";   // mỗi dòng là 1 payload JSON
const char* SPOOL_TMP_PATH  = "/spool.tmp";
const size_t SPOOL_MAX_BYTES = 512UL * 1024UL;  // ~1.5 ngày ở nhịp 2s; thừa cho demo
const int   FLUSH_BATCH      = 25;              // đẩy bù mỗi lượt bấy nhiêu gói,
                                                // rồi trả quyền cho loop() -> không nghẽn
const long  RECONNECT_MS     = 5000;            // nhịp thử nối lại, KHÔNG chặn loop

// Sau khi nối lại, ĐỪNG tin đường truyền ngay. Lý do đã trả giá bằng một lần
// test hỏng: khi broker vừa sống lại, ESP32 nối lại sau 5s nhưng phía subscriber
// (Node-RED) mất tới 15s mới nối lại. ESP bắn nguyên buffer vào broker chưa có
// ai nghe -> MQTT QoS 0 không lưu cho subscriber offline -> mất sạch, mà log
// phía ESP vẫn báo "đẩy bù OK". Nên trong khoảng này vẫn ghi tiếp vào spool,
// hết khoảng mới đẩy bù một lượt. Đổi lại: dữ liệu lên chậm hơn vài chục giây.
const long  LINK_GRACE_MS    = 20000;

// -----------------------------------------------------------------------------
WiFiClient        netPlain;
WiFiClientSecure  netTls;
PubSubClient      mqtt;

String  gHost, gUser, gPass;
int     gPort = 1883;
bool    gUseTls = false;

char topicData[160], topicConn[160], topicCfg[160], topicCmd[160], topicAck[160];

unsigned long lastPublish = 0, lastHeartbeat = 0, lastReconnect = 0, lastAi = 0;
const long AI_PERIOD_MS = 1000;   // AI chạy đúng 1 Hz — đặc trưng phụ thuộc nhịp này
unsigned long linkTrustedAt = 0;   // trước mốc này thì vẫn đệm, chưa đẩy bù
unsigned long spoolDropped = 0;   // số gói bị bỏ vì flash đầy (báo cho biết là có mất)
bool   fsReady = false;
float cellBias[NUM_CELLS];
float faultRise = 0.0f;   // độ nóng cộng dồn của cell lỗi
const int FAULT_CELL = 5; // cell "hỏng" (1-based)

// ---------------------------------------------------------------- Lớp 1: AI on-device
// Autoencoder phát hiện cell bất thường. Trọng số nằm trong cell_ae_weights.h,
// sinh ra từ ai/export_c_model.py. Ngưỡng và quy tắc giữ liên tục cũng ở đó.
void publishAnomaly(const CellAIResult& r);      // định nghĩa bên dưới
void publishCycleSummary(const ChargeSummary& s);
CellAI gAI;

// ---------------------------------------------------------------- Lớp 2: tóm tắt chu kỳ sạc
// ESP32 quan sát quá trình sạc, rút ra 9 con số, rồi LÀM HAI VIỆC (QĐ-043):
//   1. gửi 9 số lên cloud — Node-RED vẫn là nơi giữ mô hình CHUẨN, và đổi hệ
//      số ở đó không phải nạp lại firmware cho từng thiết bị ngoài hiện trường
//   2. tự tính RUL/SOH ngay trên chip, để còn trả lời được KHI MẤT MẠNG
// Hai bên dùng chung hệ số (sinh từ ai/models/rul_model.json) và đã kiểm là ra
// cùng một số: ai/test_rul_c_vs_js.py, lệch 0,00003 chu kỳ trên 500 ca.
ChargeCycle gCharge;
int  gSimCycle = 0;                 // số chu kỳ sạc đã MÔ PHỎNG
const long SIM_CHARGE_EVERY_MS = 45000;   // cứ 45s lại mô phỏng 1 chu kỳ sạc
unsigned long lastSimCharge = 0;
float  gCellTemp[AI_N_CELLS];     // nhiệt từng cell của bước hiện tại
bool   gAlarmLatched = false;     // đã báo động rồi thì không spam lại
int    gAlarmCell    = -1;

// ---------------------------------------------------------------- Cảm biến thật
CellTemp gTemp;
Alarm    gAlarm;
PackMeter gMeter;
DemoHeater gHeater;
BleView   gBle;
bool      gMeterOk = false;
RulResult gLastRul = {};          // Lớp 2 tính trên chip, để BLE và dashboard dùng

/* Kết quả Lớp 1 của bước gần nhất, để BLE hiển thị. Phải có cờ valid và phải
   được HẠ XUỐNG khi mất cảm biến — nếu không, thợ cầm điện thoại đứng cạnh
   pack sẽ đọc được kết luận AI cũ trong lúc AI thực ra đã mù. Đó đúng là kiểu
   hỏng âm thầm mà cell_temp.h được viết ra để chống. */
static CellAIResult gLastAi = {};

// Chân I2C mặc định của ESP32-S3-DevKitC-1.
#define I2C_SDA 8
#define I2C_SCL 9

/* SOC thô từ điện áp hở mạch trung bình mỗi cell.
 *
 * ⚠️ ĐÂY LÀ PHÉP ƯỚC LƯỢNG THÔ, không phải SOC thật. Đường OCV của lithium
 * phẳng ở khoảng giữa, nên xấp xỉ tuyến tính sai tới hơn 20 điểm phần trăm ở
 * vùng 30–70 %. Và khi đang có dòng thì điện áp còn bị sụt trên nội trở nữa.
 *
 * Vẫn dùng vì nó THẬT SỰ TỐT HƠN hằng số 80.0f trước đây — ít nhất nó biến
 * thiên đúng chiều theo trạng thái pin. Đặc trưng số 14 của Lớp 1 chỉ dùng SOC
 * làm biến ngữ cảnh chứ không dựng quyết định trên nó.
 *
 * Làm đúng thì phải đếm coulomb (thanh ghi CHARGE của INA228) hiệu chỉnh lại
 * bằng OCV lúc pin nghỉ. Chưa làm — xem docs/TEST_VA_ACCEPTANCE.md. */
static float crudeSocFromVoltage(float cell_v) {
  const float soc = (cell_v - 3.0f) / (4.2f - 3.0f) * 100.0f;
  return soc < 0.0f ? 0.0f : (soc > 100.0f ? 100.0f : soc);
}
bool     gTempOk = false;         // begin() có đủ cảm biến không
unsigned long lastTempPrint = 0;
const long TEMP_PRINT_MS = 30000;
void publishSensorHealth();

/* Nạp gCellTemp[] cho bước hiện tại. Tách riêng để runAI() và publishData()
   dùng CHUNG một bộ số — bản cũ mỗi hàm tự sinh số ngẫu nhiên riêng, nên nhiệt
   độ đẩy lên dashboard không phải nhiệt độ mà AI nhìn thấy. Với dữ liệu giả
   thì không ai để ý; với dữ liệu thật thì đó là hai sự thật mâu thuẫn nhau. */
void sampleCellTemps() {
#if USE_REAL_TEMP
  if (gTemp.status().ready) {
    const float* t = gTemp.temps();
    for (int i = 0; i < AI_N_CELLS; i++) gCellTemp[i] = t[i];
    return;
  }
  // Chưa có lượt đọc nào (vài giây đầu) — để nguyên, runAI() sẽ tự bỏ qua.
  for (int i = 0; i < AI_N_CELLS; i++) gCellTemp[i] = NAN;
#else
  faultRise += 0.05f;
  if (faultRise > 18.0f) faultRise = 0.0f;   // reset để demo lặp lại
  for (int i = 0; i < AI_N_CELLS; i++) {
    float v = 30.0f + cellBias[i] + random(-30, 31) / 100.0f;
    if (i + 1 == FAULT_CELL) v += faultRise;
    gCellTemp[i] = roundf(v * 16.0f) / 16.0f;   // bước 0,0625 °C như DS18B20
  }
#endif
}

// ============================================================ Tiện ích thời gian
// EdgeHub yêu cầu ISO-8601 UTC, đúng format "%Y-%m-%dT%H:%M:%S.%fZ" (6 số lẻ giây).
String isoTimestampUtc() {
  struct timeval tv;
  gettimeofday(&tv, nullptr);
  struct tm t;
  gmtime_r(&tv.tv_sec, &t);
  char buf[40];
  snprintf(buf, sizeof(buf), "%04d-%02d-%02dT%02d:%02d:%02d.%06ldZ",
           t.tm_year + 1900, t.tm_mon + 1, t.tm_mday,
           t.tm_hour, t.tm_min, t.tm_sec, (long)tv.tv_usec);
  return String(buf);
}

// Giờ đã hợp lệ chưa? Nếu NTP chưa xong, ts sẽ ra năm 1970 và cloud vứt dữ liệu
// đi (InfluxDB trả HTTP 422 vì ngoài retention). Thà không gửi còn hơn gửi rác.
bool timeIsValid() {
  time_t now = 0;
  time(&now);
  return now >= 1700000000;
}

void syncTime() {
  configTime(0, 0, "pool.ntp.org", "time.google.com");
  Serial.print("[NTP] dong bo gio");
  time_t now = 0;
  int tries = 0;
  while (now < 1700000000 && tries < 40) {   // chờ tới khi gio hop le
    delay(500); Serial.print(".");
    time(&now); tries++;
  }
  Serial.println(now < 1700000000 ? " THAT BAI" : " OK -> " + isoTimestampUtc());
  // Nếu NTP fail: timestamp sẽ sai năm 1970, WISE-IoT sẽ vứt dữ liệu đi
  // hoặc vẽ điểm ở tận 1970 trên dashboard. Đây là lỗi hay gặp nhất.
}

// ============================================================ Store-and-forward
void spoolBegin() {
  fsReady = LittleFS.begin(true);        // true = tự format nếu chưa có filesystem
  if (!fsReady) { Serial.println("[FS  ] LittleFS hong -> mat mang la mat du lieu"); return; }
  File f = LittleFS.open(SPOOL_PATH, FILE_READ);
  size_t sz = f ? f.size() : 0;
  if (f) f.close();
  Serial.printf("[FS  ] LittleFS OK, spool dang co %u byte\n", (unsigned)sz);
}

// Flash gần đầy thì bỏ nửa cũ đi, giữ nửa mới. Dữ liệu mới đáng giá hơn dữ liệu
// cũ trong bài toán giám sát pin, và cách này tránh phải viết ring buffer thật.
void spoolCompact() {
  File in = LittleFS.open(SPOOL_PATH, FILE_READ);
  if (!in) return;
  size_t half = in.size() / 2;
  in.seek(half);
  in.readStringUntil('\n');              // bỏ nốt dòng bị cắt dở
  File out = LittleFS.open(SPOOL_TMP_PATH, FILE_WRITE);
  if (!out) { in.close(); return; }
  while (in.available()) {
    String line = in.readStringUntil('\n');
    if (line.length()) { out.println(line); }
  }
  in.close(); out.close();
  LittleFS.remove(SPOOL_PATH);
  LittleFS.rename(SPOOL_TMP_PATH, SPOOL_PATH);
  Serial.println("[FS  ] spool day -> da bo nua cu");
}

void spoolAppend(const String& payload) {
  if (!fsReady) { spoolDropped++; return; }
  File f = LittleFS.open(SPOOL_PATH, FILE_APPEND);
  if (!f) { spoolDropped++; return; }
  if (f.size() > SPOOL_MAX_BYTES) { f.close(); spoolCompact(); f = LittleFS.open(SPOOL_PATH, FILE_APPEND); }
  if (!f) { spoolDropped++; return; }
  f.println(payload);
  f.close();
}

size_t spoolSize() {
  if (!fsReady) return 0;
  File f = LittleFS.open(SPOOL_PATH, FILE_READ);
  size_t sz = f ? f.size() : 0;
  if (f) f.close();
  return sz;
}

// Đẩy bù tối đa FLUSH_BATCH gói. Gói nào chưa gửi được thì giữ nguyên trong file
// theo đúng thứ tự, nên rớt mạng giữa chừng cũng không mất và không đảo thứ tự.
// Trả về true khi spool đã sạch.
bool spoolFlush() {
  if (millis() < linkTrustedAt) return false;      // còn trong khoảng chờ subscriber
  if (!fsReady || spoolSize() == 0) return true;

  File in = LittleFS.open(SPOOL_PATH, FILE_READ);
  if (!in) return true;
  File out = LittleFS.open(SPOOL_TMP_PATH, FILE_WRITE);
  if (!out) { in.close(); return false; }

  int sent = 0, kept = 0;
  bool stillSending = true;
  while (in.available()) {
    String line = in.readStringUntil('\n');
    line.trim();
    if (line.length() == 0) continue;

    if (stillSending && sent < FLUSH_BATCH && mqtt.connected()) {
      if (mqtt.publish(topicData, line.c_str())) { sent++; continue; }
      stillSending = false;              // gửi hỏng -> phần còn lại giữ lại hết
    } else if (sent >= FLUSH_BATCH) {
      stillSending = false;              // hết lượt, để dành cho vòng loop sau
    }
    out.println(line);
    kept++;
  }
  in.close(); out.close();
  LittleFS.remove(SPOOL_PATH);
  LittleFS.rename(SPOOL_TMP_PATH, SPOOL_PATH);

  if (sent) Serial.printf("[BUFF] day bu %d goi, con lai %d\n", sent, kept);
  return kept == 0;
}

// ============================================================ WiFi
// KHÔNG chặn. Nếu chặn ở đây thì lúc mất mạng loop() đứng luôn, không lấy mẫu
// được và store-and-forward thành vô nghĩa — đó chính là bug của bản trước.
void ensureWifi() {
  static bool announced = false;
  if (WiFi.status() == WL_CONNECTED) {
    if (!announced) {
      Serial.println("[WiFi] OK  IP=" + WiFi.localIP().toString() +
                     "  RSSI=" + String(WiFi.RSSI()) + "dBm");
      announced = true;
    }
    return;
  }
  announced = false;
  static unsigned long lastTry = 0;
  if (millis() - lastTry < RECONNECT_MS) return;
  lastTry = millis();
  // Thử hai lần cùng một mạng rồi mới chuyển sang mạng kế. Chuyển ngay sau
  // MỘT lần trượt là sai: WiFi trượt một lần vì nhiễu là chuyện thường, và
  // nhảy mạng liên tục thì không mạng nào kịp bắt tay xong.
  static int fails = 0;
  if (++fails >= 2) { fails = 0; wifiNext(); }
  wifiStart();
}

// ============================================================ DCCS
// GET {apiUrl}/v1/serviceCredentials/{credentialKey}
// Trả về serviceHost + credential.protocols.mqtt / mqtt+ssl {port,username,password}
bool fetchCredentialFromDccs() {
  WiFiClientSecure https;
  https.setInsecure();                 // bỏ qua kiểm tra CA cho lần test đầu
  HTTPClient http;
  String url = String(DCCS_API_URL) + "/v1/serviceCredentials/" + DCCS_CRED_KEY;
  Serial.println("[DCCS] GET " + url);

  if (!http.begin(https, url)) { Serial.println("[DCCS] http.begin that bai"); return false; }
  int code = http.GET();
  if (code != 200) {
    Serial.printf("[DCCS] HTTP %d - kiem tra lai API URL va Credential Key\n", code);
    Serial.println(http.getString());
    http.end();
    return false;
  }
  String body = http.getString();
  http.end();

  JsonDocument doc;
  if (deserializeJson(doc, body)) { Serial.println("[DCCS] JSON hong"); return false; }

  gHost = doc["serviceHost"].as<String>();
  JsonObject p = gUseTls ? doc["credential"]["protocols"]["mqtt+ssl"]
                         : doc["credential"]["protocols"]["mqtt"];
  if (p.isNull()) { Serial.println("[DCCS] khong co protocol tuong ung"); return false; }

  gPort = p["port"] | 0;
  gUser = p["username"].as<String>();
  gPass = p["password"].as<String>();

  Serial.printf("[DCCS] host=%s port=%d user=%s\n", gHost.c_str(), gPort, gUser.c_str());
  return gPort != 0;
}

// ============================================================ MQTT
void buildTopics() {
  snprintf(topicData, sizeof(topicData), "/wisepaas/scada/%s/data", NODE_ID);
  snprintf(topicConn, sizeof(topicConn), "/wisepaas/scada/%s/conn", NODE_ID);
  snprintf(topicCfg,  sizeof(topicCfg),  "/wisepaas/scada/%s/cfg",  NODE_ID);
  snprintf(topicCmd,  sizeof(topicCmd),  "/wisepaas/scada/%s/cmd",  NODE_ID);
  snprintf(topicAck,  sizeof(topicAck),  "/wisepaas/scada/%s/ack",  NODE_ID);
}

/* Nhận lệnh từ cloud.
 *
 * ⚠️ NGUYÊN TẮC: CLOUD CHỈ ĐƯỢC XIN, THIẾT BỊ MỚI QUYẾT.
 * Hàm này KHÔNG bật sưởi. Nó chỉ gọi gHeater.request(), và DemoHeater tự kiểm
 * mọi hạn mức — trần 50 °C, hạn mức thời gian, mất cảm biến — rồi mới quyết.
 * Không lệnh nào từ mạng nâng được các hạn mức đó. Một nút bấm trên dashboard
 * có thể nâng ngưỡng an toàn là một nút bấm đốt pack pin.
 *
 * ⚠️ VÀ LỆNH XIN TỰ HẾT HẠN. Muốn sưởi tiếp thì dashboard phải gửi lại đều
 * đặn. Mất mạng, sập Node-RED, đóng tab trình duyệt → sưởi TẮT. Đây là khác
 * biệt giữa một nút bấm tiện tay và một nút bấm bật sưởi rồi kẹt ở đó lúc
 * không ai nhìn.
 *
 * Định dạng: {"cmd":"heat"} · {"cmd":"heat_stop"} · {"cmd":"mute","on":true}
 *            {"cmd":"quiet","on":true}
 * Trả lời trên topicAck để dashboard hiển thị THIẾT BỊ ĐANG THẾ NÀO, chứ không
 * phải hiển thị NGƯỜI VỪA BẤM GÌ. Hai thứ đó khác nhau, và chỉ cái đầu là thật.
 */
void publishAck(const char* cmd, const char* result);

void onMqttMessage(char* topic, byte* payload, unsigned int len) {
  Serial.printf("[MQTT<-] %s : ", topic);
  for (unsigned int i = 0; i < len; i++) Serial.write(payload[i]);
  Serial.println();

  if (strcmp(topic, topicCmd) != 0) return;   // chỉ nghe lệnh trên topic cmd

  JsonDocument d;
  if (deserializeJson(d, payload, len)) { publishAck("?", "json hong"); return; }
  const char* cmd = d["cmd"] | "";

  if (!strcmp(cmd, "heat")) {
    // "mode":"steady" = diễn TH-2. Thiếu hoặc lạ thì về NHANH như cũ, để trang
    // cũ chưa biết trường này vẫn chạy đúng.
    const char* md = d["mode"] | "fast";
    gHeater.request(DH_DEADMAN_MS, strcmp(md, "steady") ? DH_MODE_FAST : DH_MODE_STEADY);
    publishAck(cmd, gHeater.state() == DH_BLOCKED ? "bi chan" : "da nhan");
  } else if (!strcmp(cmd, "heat_stop")) {
    gHeater.stop();
    publishAck(cmd, "da dung");
  } else if (!strcmp(cmd, "mute")) {
    gAlarm.setMuted(d["on"] | true);
    publishAck(cmd, gAlarm.muted() ? "dang tat tieng" : "dang keu");
  } else if (!strcmp(cmd, "quiet")) {
    gAlarm.setQuiet(d["on"] | true);
    publishAck(cmd, gAlarm.quiet() ? "bip thua" : "keu binh thuong");
  } else {
    publishAck(cmd, "khong hieu lenh");
  }
}

void publishAck(const char* cmd, const char* result) {
  if (!mqtt.connected()) return;
  JsonDocument d;
  d["cmd"]     = cmd;
  d["result"]  = result;
  // Trạng thái THẬT của thiết bị sau khi xử lý lệnh
  d["heater"]  = gHeater.on() ? 1 : 0;
  d["state"]   = (int)gHeater.state();
  d["mode"]    = (int)gHeater.mode();
  d["reason"]  = gHeater.reason();
  d["delta"]   = round(gHeater.delta() * 100) / 100.0;
  d["left_s"]  = gHeater.secondsLeft();
  d["muted"]   = gAlarm.muted() ? 1 : 0;
  d["quiet"]   = gAlarm.quiet() ? 1 : 0;
  d["alarm"]   = (int)gAlarm.level();
  char buf[320];
  const size_t n = serializeJson(d, buf, sizeof(buf));
  mqtt.publish(topicAck, (const uint8_t*)buf, n, false);
}

// Gửi Config: khai báo Node + Device + 8 tag analog. Chỉ cần gửi 1 lần sau khi
// kết nối; không có bước này WISE-IoT sẽ không biết tag nào tồn tại và
// dashboard sẽ trống dù dữ liệu vẫn về.
void publishConfig() {
  JsonDocument doc;
  JsonObject d     = doc["d"].to<JsonObject>();
  d["Action"]      = 1;                               // 1 = Create
  JsonObject scada = d["Scada"].to<JsonObject>();
  JsonObject node  = scada[NODE_ID].to<JsonObject>();
  node["Type"]     = 0;                               // 0 = Gateway
  node["Hbt"]      = HEARTBEAT_MS / 1000;
  JsonObject dev   = node["Device"][DEVICE_ID].to<JsonObject>();
  dev["Name"]      = "Pack pin 6S";
  dev["Type"]      = "BatteryPack";
  dev["Desc"]      = "Pack thi nghiem 6 cell LG HG2";
  JsonObject tags  = dev["Tag"].to<JsonObject>();

  for (int i = 1; i <= NUM_CELLS; i++) {
    char name[16]; snprintf(name, sizeof(name), "Cell%02d_Temp", i);
    JsonObject t = tags[name].to<JsonObject>();
    t["Type"] = 1;          // 1 = Analog
    t["Desc"] = "Nhiet do cell";
    t["RO"]   = 1;          // read only
    t["Ary"]  = 0;
    t["SH"]   = 80;         // span high
    t["SL"]   = 0;          // span low
    t["EU"]   = "degC";
    t["IDF"]  = 3;
    t["FDF"]  = 2;
  }
  doc["ts"] = isoTimestampUtc();

  String out; serializeJson(doc, out);
  bool ok = mqtt.publish(topicCfg, out.c_str());
  Serial.printf("[CFG ] %d bytes -> %s\n", out.length(), ok ? "OK" : "THAT BAI (tang buffer?)");
}

void publishConnState(int con) {
  JsonDocument doc;
  doc["d"][con ? "Con" : "DsC"] = 1;
  doc["ts"] = isoTimestampUtc();
  String out; serializeJson(doc, out);
  mqtt.publish(topicConn, (const uint8_t*)out.c_str(), out.length(), true); // retained
}

void publishHeartbeat() {
  JsonDocument doc;
  doc["d"]["Hbt"] = 1;
  doc["ts"] = isoTimestampUtc();
  String out; serializeJson(doc, out);
  mqtt.publish(topicConn, out.c_str());
  Serial.println("[HBT ] .");
}

// Payload dữ liệu — đây là thứ quyết định dashboard có vẽ được hay không:
// { "d": { "<deviceId>": { "<tag>": <so>, ... } }, "ts": "...Z" }
// ============================================================ Lớp 1: AI on-device
// Chạy 1 Hz. Đọc nhiệt từng cell (hiện đang giả lập — khi gắn DS18B20 thật thì
// chỉ thay chỗ đọc), cho qua autoencoder, và báo động nếu một cell vượt ngưỡng
// đủ lâu.
//
// LƯU Ý AN TOÀN: đây là lớp phát hiện SỚM cell bất thường, KHÔNG phải bộ dự
// báo cháy nổ. Nó bỏ sót kiểu trôi nhiệt rất chậm (xem ai/README.md), nên
// ngưỡng cứng 60 °C bên dưới PHẢI giữ, không được bỏ đi vì "đã có AI".
void runAI() {
  sampleCellTemps();

  // Cảm biến có đủ và khoẻ không — tính một lần, dùng cho cả các nhánh thoát
  // sớm bên dưới.
  const bool sensorBad = !gTempOk || gTemp.status().n_healthy < CT_N;

  // Chưa có số đọc hợp lệ (vài giây đầu, hoặc mất cả bus) thì không cho AI ăn
  // số rác. Thà không có kết quả còn hơn có kết quả sai.
  //
  // NHƯNG vẫn phải nuôi gAlarm.update(). Nếu thoát thẳng ở đây thì mất cả bus
  // sẽ làm đèn ĐỨNG HÌNH ở trạng thái cũ — nghĩa là mất hết cảm biến trông y
  // hệt mọi thứ bình thường. Đó đúng là kiểu hỏng âm thầm mà cell_temp.h được
  // viết ra để chống; đừng mở lại cửa đó ở đây.
  if (isnan(gCellTemp[0])) {
    gLastAi.valid = false;      // mất cảm biến thì BLE phải nói "chưa kết luận"
    gAlarm.update(false, false, NAN, true);
    return;
  }

  // Nhiệt độ môi trường: cảm biến thứ 9 nếu có. Không có thì lùi về hằng số —
  // và mã hoá chuyện đó thành tag riêng lên dashboard, chứ không im lặng dùng
  // số giả định như thể nó là số đo.
  const bool  ambOk   = gTemp.ambientOk();
  const float ambient = ambOk ? gTemp.ambient() : 28.0f;

  // Dòng và áp: số thật nếu có INA228, còn không thì lùi về giả định CŨ và
  // đánh dấu chuyện đó lên dashboard (Meter_IsReal) — không bao giờ để số giả
  // định trôi lên cloud mà trông y hệt số đo.
  const PackMeasurement pm = gMeter.read();
  const float current = pm.valid ? pm.current : 0.0f;
  const float soc     = pm.valid ? crudeSocFromVoltage(pm.cell_v) : 80.0f;

  CellAIResult r = gAI.update(gCellTemp, ambient, current, soc);
  gLastAi = r;                  // nguồn duy nhất cho màn hình BLE
  if (!r.valid) {               // còn trong giai đoạn khởi động (AI chưa đủ
    // cửa sổ lịch sử). AI chưa nói được gì, nhưng ngưỡng cứng 60 °C thì KHÔNG
    // cần lịch sử — nó phải có hiệu lực ngay từ giây đầu tiên.
    float t0 = -1000.0f;
    for (int i = 0; i < AI_N_CELLS; i++) if (gCellTemp[i] > t0) t0 = gCellTemp[i];
    gAlarm.update(false, false, t0, sensorBad);
    return;
  }

  // --- lớp an toàn độc lập với AI: ngưỡng cứng, không bao giờ được bỏ ---
  float tmax = -1000.0f;
  for (int i = 0; i < AI_N_CELLS; i++) {
    if (gCellTemp[i] > tmax) tmax = gCellTemp[i];
    if (gCellTemp[i] >= AL_T_CRIT) {
      Serial.printf("[SAFE] CELL %d = %.2f degC >= 60 - NGUONG CUNG\n", i + 1, gCellTemp[i]);
    }
  }

  // Mức THEO DOI: có cell đang vượt ngưỡng nhưng chưa giữ đủ lâu để thành báo
  // động. Đèn vàng ở đây chính là thứ cho người trực thấy AI đang làm việc,
  // thay vì im lặng rồi hét lên sau 60 giây.
  bool watch = false;
  for (int i = 0; i < AI_N_CELLS; i++) if (r.run_s[i] > 0) { watch = true; break; }

  // Đưa vào báo động tại chỗ. Ba đường vào tách biệt nên ngưỡng cứng vẫn kêu
  // kể cả khi autoencoder sai hoàn toàn.
  gAlarm.update(r.alarm, watch, tmax, sensorBad);

  if (r.alarm && !gAlarmLatched) {
    gAlarmLatched = true;
    gAlarmCell = r.worst_cell;
    Serial.printf("[AI  ] *** BAT THUONG *** cell %d, diem %.3f (nguong %.3f), "
                  "giu %us\n", r.worst_cell + 1, r.worst_score,
                  (double)CellAI::threshold(), r.run_s[r.worst_cell]);
    publishAnomaly(r);
  } else if (!r.alarm && gAlarmLatched) {
    gAlarmLatched = false;
    Serial.println("[AI  ] het bat thuong");
    publishAnomaly(r);
  }
}

// Đẩy kết quả AI lên cloud theo ĐÚNG data contract hiện có: vẫn là
// {"d":{"<device>":{...}},"ts":...} nên Node-RED/WISE-IoT không phải sửa gì.
// Xem docs/DATA_CONTRACT.md — giá trị phải là số, nên trạng thái mã hoá bằng 0/1.
void publishAnomaly(const CellAIResult& r) {
  if (!timeIsValid()) return;
  JsonDocument doc;
  JsonObject dev = doc["d"][DEVICE_ID].to<JsonObject>();
  dev["AI_Alarm"]      = r.alarm ? 1 : 0;
  dev["AI_WorstCell"]  = r.worst_cell + 1;         // 1-based cho người đọc
  dev["AI_WorstScore"] = round(r.worst_score * 1000) / 1000.0;

  /* DẠNG bất thường + ba số đã tra ra nó. Data contract đòi giá trị phải là
     SỐ nên dạng đi dưới dạng mã 0..3 (xem enum AiPattern); Node-RED dịch sang
     chữ. KHÔNG gửi chuỗi ở đây — đổi kiểu giá trị là phá hợp đồng dữ liệu, và
     docs/DATA_CONTRACT.md là thứ không được tự ý sửa. */
  dev["AI_Pattern"]    = (int)r.pattern;
  dev["AI_Dev"]        = round(r.dev     * 100) / 100.0;
  dev["AI_DtDiff"]     = round(r.dt_diff * 100) / 100.0;
  dev["AI_Shock"]      = round(r.shock   * 100) / 100.0;
  for (int i = 0; i < AI_N_CELLS; i++) {
    char name[16]; snprintf(name, sizeof(name), "AI_Score%02d", i + 1);
    dev[name] = round(r.score[i] * 1000) / 1000.0;
  }
  doc["ts"] = isoTimestampUtc();

  String out; serializeJson(doc, out);
  bool linkReady = mqtt.connected() && millis() >= linkTrustedAt;
  if (!(linkReady && mqtt.publish(topicData, out.c_str()))) {
    spoolAppend(out);        // mất mạng thì cảnh báo cũng phải được đệm lại
  }
  Serial.printf("[AI  ] gui ket qua: %s\n", out.c_str());
}

// ============================================================ Lớp 2: chu kỳ sạc
// Gửi 9 con số tóm tắt một chu kỳ sạc. Vẫn đi qua ĐÚNG data contract hiện có
// (docs/DATA_CONTRACT.md) nên Node-RED và WISE-IoT không phải sửa gì về đường
// truyền — chỉ thêm một nhánh xử lý khi thấy tag CYC_*.
void publishCycleSummary(const ChargeSummary& s) {
  if (!timeIsValid()) return;
  JsonDocument doc;
  JsonObject dev = doc["d"][DEVICE_ID].to<JsonObject>();
  for (int i = 0; i < CC_N_FEATURES; i++) {
    char name[24];
    snprintf(name, sizeof(name), "CYC_%s", CC_FEATURE_NAMES[i]);
    /* KHÔNG làm tròn. Bản cũ làm tròn 4 chữ số thập phân: dvdt_cc chỉ cỡ
       0,0001 V/s nên bị xoá gần hết, cloud tính SOH lệch chip 3,45 điểm trên
       CÙNG một chu kỳ (91,36 vs 87,91 — đo 23/09). ArduinoJson tự in đủ số
       chữ số có nghĩa của float. */
    dev[name] = s.f[i];
  }
  dev["CYC_duration_s"] = (double)s.duration_s;

  /* Gửi kèm kết quả TÍNH TRÊN CHIP, tiền tố ONB_ để phân biệt với bản cloud
     tính. Có cả hai trên dashboard thì lệch nhau là nhìn ra ngay — nếu chỉ gửi
     đặc trưng rồi tin cả hai bên giống nhau thì lúc lệch sẽ không ai biết. */
  if (gLastRul.valid) {
    dev["ONB_RUL_Cycles"]   = round(gLastRul.rul_cycles * 100) / 100.0;
    dev["ONB_SOH_Percent"]  = round(gLastRul.soh * 10000) / 100.0;
    dev["ONB_Extrapolating"] = gLastRul.extrapolating ? 1 : 0;
    const float sl = rulHistSohSlope(20);
    if (!isnan(sl)) dev["ONB_SOH_Slope"] = round(sl * 10000) / 10000.0;
    dev["ONB_Cycles_Logged"] = rulHistCount();
  }
  doc["ts"] = isoTimestampUtc();

  String out; serializeJson(doc, out);
  bool linkReady = mqtt.connected() && millis() >= linkTrustedAt;
  if (!(linkReady && mqtt.publish(topicData, out.c_str()))) spoolAppend(out);
  Serial.printf("[CYC ] chu ky sac #%d xong sau %us ao -> gui %d dac trung\n",
                gSimCycle, s.duration_s, CC_N_FEATURES);
}

/* Đẩy sức khoẻ cảm biến lên cloud (QĐ-024).
   Vẫn đúng data contract: {"d":{"<device>":{...}},"ts":...}, chỉ thêm tag mới,
   giá trị đều là số. Node-RED/WISE-IoT không phải sửa gì.

   Vì sao đáng một gói riêng: đã đo được bus lỗi 35 % mà không có dấu hiệu nào,
   và đã gặp cảnh tuột một dây mà chương trình vẫn chạy với 6 cảm biến. Nếu
   dashboard chỉ có 8 đường nhiệt độ thì không ai nhận ra — các đường vẫn đẹp,
   chỉ là chúng không còn là sự thật. */
void publishSensorHealth() {
  if (!timeIsValid()) return;
  JsonDocument doc;
  JsonObject dev = doc["d"][DEVICE_ID].to<JsonObject>();

  const CellTempStatus& s = gTemp.status();
  dev["Sensor_Healthy"]   = s.n_healthy;          // phải luôn bằng 8
  dev["Sensor_Found"]     = s.n_found;
  dev["Sensor_ErrPct"]    = round(gTemp.errorRate() * 1000) / 1000.0;
  // Bitmask kênh hỏng: 0 là mọi thứ bình thường, khác 0 là có vấn đề.
  uint8_t mask = 0;
  for (int i = 0; i < CT_N; i++) if (!s.healthy[i]) mask |= (1 << i);
  dev["Sensor_FaultMask"] = mask;
  dev["Ambient_Temp"]     = gTemp.ambientOk() ? round(gTemp.ambient()*100)/100.0 : -99.0;
  dev["Ambient_IsReal"]   = gTemp.ambientOk() ? 1 : 0;   // 0 = đang dùng hằng số
  // Trạng thái báo động tại chỗ — để dashboard và còi luôn kể cùng một câu
  // chuyện. Alarm_Events đếm số lần leo lên mức báo động kể từ khi bật máy:
  // đó là cách duy nhất biết đêm qua có gì xảy ra mà không ai ở đó nghe.
  dev["Alarm_Level"]      = (int)gAlarm.level();
  dev["Alarm_Muted"]      = gAlarm.muted() ? 1 : 0;
  dev["Alarm_Quiet"]      = gAlarm.quiet() ? 1 : 0;
  dev["Alarm_Events"]     = (int)gAlarm.eventCount();

  // Dòng/áp pack. Meter_IsReal = 0 nghĩa là hai giá trị trên là GIẢ ĐỊNH, đừng
  // vẽ đồ thị rồi tin.
  const PackMeasurement pm = gMeter.read();
  dev["Meter_IsReal"]     = pm.valid ? 1 : 0;
  dev["Pack_Voltage"]     = pm.valid ? round(pm.voltage * 1000) / 1000.0 : -99.0;
  dev["Pack_CellV"]       = pm.valid ? round(pm.cell_v  * 1000) / 1000.0 : -99.0;
  dev["Pack_Current"]     = pm.valid ? round(pm.current * 1000) / 1000.0 : -99.0;
  dev["Pack_ChargeAh"]    = pm.valid ? round(pm.charge_ah * 10000) / 10000.0 : -99.0;
  dev["Meter_ErrCount"]   = (int)gMeter.errorCount();

  /* Trạng thái sưởi demo. Đẩy lên dashboard vì người xem PHẢI phân biệt được
     "cell nóng vì đội đang cố ý sưởi để diễn" với "cell nóng thật". Giấu chuyện
     này đi là biến một màn demo trung thực thành một màn gây hiểu nhầm. */
  dev["Heater_On"]        = gHeater.on() ? 1 : 0;
  dev["Heater_State"]     = (int)gHeater.state();
  dev["Heater_Delta"]     = round(gHeater.delta() * 100) / 100.0;

  doc["ts"] = isoTimestampUtc();
  String out; serializeJson(doc, out);
  bool linkReady = mqtt.connected() && millis() >= linkTrustedAt;
  if (!(linkReady && mqtt.publish(topicData, out.c_str()))) spoolAppend(out);
}

// ------------------------------------------------------------ MÔ PHỎNG SẠC
// TẠM THỜI: chưa có mạch sạc thật nên sinh một chu kỳ CC-CV tổng hợp, chạy ở
// "thời gian ảo" (mỗi vòng lặp = 1 giây ảo) để một chu kỳ 3 tiếng gói gọn
// trong vài giây thật. Khi có phần cứng thật thì bỏ hàm này và gọi
// gCharge.update() 1 Hz với số đo thật từ INA228 + ADC + DS18B20.
//
// Pin được cho "già đi" theo từng chu kỳ mô phỏng: pha CV dài dần ra, đúng
// quy luật vật lý mà mô hình đã học -> RUL trên dashboard sẽ giảm dần.
void simulateChargeCycle() {
  gSimCycle++;
  // Hằng số HIỆU CHỈNH theo dải thật của bộ NASA mà mô hình đã học:
  // t_cv chạy từ ~2470 giây (pin mới) tới ~3170 giây (pin sắp hết đời).
  // Với profile CV suy giảm mũ thì t_cv = tau * ln(I0/I_END) = tau * 2,015,
  // nên tau phải nằm trong khoảng 1224..1573.
  // Không hiệu chỉnh thì đầu vào rơi ngoài dải huấn luyện và RUL ra số âm —
  // đã gặp đúng lỗi đó ở lần chạy đầu, mô hình trả -6 chu kỳ ngay từ chu kỳ 1.
  // Pha CC chia 3 đoạn, KHÔNG dâng tuyến tính. Pin lithium có vùng điện áp
  // phẳng ở giữa: lên nhanh tới ~3,9 V, bò rất chậm qua 3,9–4,15 V, rồi lên
  // nốt. Bản đầu cho dâng tuyến tính -> t_v_interval và dvdt_cc rơi ngoài dải
  // huấn luyện, và chính node cảnh báo ngoại suy bên Node-RED đã bắt được.
  // Các con số dưới đây khớp trung bình của bộ NASA (xem ai/data/nasa_cycles.csv).
  const float t_a = 300.0f;       // 3,60 -> 3,90 V
  const float t_b = 2074.0f;      // 3,90 -> 4,15 V  (NASA: t_v_interval TB 2074s)
  const float t_c = 379.0f;       // 4,15 -> 4,20 V
  const float t_cc = t_a + t_b + t_c;
  /* CV dài dần khi pin già. Bản cũ +18 s/chu kỳ từ 1224: cứ 45 s một chu kỳ
     nên chỉ ~15 phút là tau vượt 1573, RUL về 0, SOH 55 % và "ngoại suy" —
     đúng thứ dashboard hiện suốt buổi demo (đo 23/09). Giờ bắt đầu từ ~chu kỳ
     60 của pin NASA B0005 (t_cv ≈ 2760 s), khớp chỗ seed_layer2.py dừng, và
     già 0,05 s/chu kỳ. Bản 0,5 làm RUL tụt ~12 chu kỳ mỗi GIỜ (một chu kỳ ảo
     mỗi 45 s, nhanh hơn đời thật ~2000 lần) — biểu đồ 30 ngày có một vách dựng
     đứng ở cuối. 0,05: ~1,3 chu kỳ/giờ, cả ngày chạy vẫn trong dải. */
  const float tau_cv = 1370.0f + 0.05f * gSimCycle;
  const float I0 = 1.5f;

  for (int t = 0; t < 20000; t++) {
    float v_cell, i;
    if (t < t_a)              { v_cell = 3.60f + 0.30f * (t / t_a);            i = I0; }
    else if (t < t_a + t_b)   { v_cell = 3.90f + 0.25f * ((t - t_a) / t_b);    i = I0; }
    else if (t < t_cc)        { v_cell = 4.15f + 0.05f * ((t - t_a - t_b) / t_c); i = I0; }
    else {                                              // CV: giữ áp, dòng giảm mũ
      v_cell = 4.20f;
      i = I0 * expf(-(t - t_cc) / tau_cv);
    }
    // Nhiệt độ: hiệu chỉnh để T_mean rơi quanh 26,7 °C như bộ NASA
    const float temp = 25.5f + 1.8f * (i / I0);
    ChargeSummary s = gCharge.update(v_cell * CC_N_CELLS, i, temp);
    if (s.valid) {
      /* Tính ngay trên chip TRƯỚC khi gửi. Thứ tự này có chủ đích: mất mạng thì
         publishCycleSummary() rơi vào spool, nhưng gLastRul vẫn có số mới và
         app BLE vẫn hiện được. Gọi sau thì mất mạng là mất luôn cả hai. */
      gLastRul = rulPredict(s);
      rulHistAppend(gLastRul, s, timeIsValid() ? (uint32_t)time(nullptr) : 0);
      gBle.setLayer2(gLastRul, rulHistCount(), rulHistSohSlope(20));
      publishCycleSummary(s);
      return;
    }
    if (i < CC_I_END && t > t_cc) break;
  }
  Serial.println("[CYC ] mo phong khong ra summary hop le");
}

void publishData() {
  // Chưa có giờ chuẩn thì gói nào gửi lên cũng bị cloud vứt. Bỏ qua lượt này.
  if (!timeIsValid()) { Serial.println("[DATA] bo qua - NTP chua dong bo"); return; }

  // Chưa có số đọc thật thì không gửi gì. Gửi số bịa lên dashboard rồi sau đó
  // giải thích "lúc đó cảm biến chưa sẵn sàng" là cách nhanh nhất để mất tin.
  if (isnan(gCellTemp[0])) { Serial.println("[DATA] bo qua - cam bien chua san sang"); return; }

  JsonDocument doc;
  JsonObject dev = doc["d"][DEVICE_ID].to<JsonObject>();

  // Dùng đúng bộ số mà runAI() vừa nhìn thấy — xem sampleCellTemps().
  for (int i = 1; i <= NUM_CELLS; i++) {
    char name[16]; snprintf(name, sizeof(name), "Cell%02d_Temp", i);
    dev[name] = round(gCellTemp[i - 1] * 100) / 100.0;
  }

  /* Kết luận Lớp 1 đi kèm MỌI gói dữ liệu, không chỉ lúc chuyển trạng thái.
     publishAnomaly() chỉ bắn khi vào/ra báo động — nếu dashboard chỉ dựa vào
     đó thì ai mở trang GIỮA LÚC đang báo động sẽ thấy thẻ chẩn đoán TRỐNG,
     đúng lúc cần nó nhất. Thêm 6 trường SỐ, vẫn đúng format {"d":{...},"ts"}
     nên không đụng tới hợp đồng dữ liệu. */
  /* Mức báo động đi CÙNG NHỊP với các trường AI_*, dù publishSensorHealth()
     cũng gửi nó. Hai trường liên quan chặt mà đi hai nhịp khác nhau thì giao
     diện sẽ có lúc hiện "điểm 1,12 / ngưỡng 1,07" ngay cạnh chữ "Bình thường"
     — nhìn như hệ tự mâu thuẫn, và đó là thứ giám khảo hỏi ngay. */
  dev["Alarm_Level"] = (int)gAlarm.level();
  dev["Alarm_Muted"] = gAlarm.muted() ? 1 : 0;
  dev["Alarm_Quiet"] = gAlarm.quiet() ? 1 : 0;

  if (gLastAi.valid) {
    dev["AI_WorstCell"]  = gLastAi.worst_cell + 1;
    dev["AI_WorstScore"] = round(gLastAi.worst_score * 1000) / 1000.0;
    dev["AI_Pattern"]    = (int)gLastAi.pattern;
    dev["AI_Dev"]        = round(gLastAi.dev     * 100) / 100.0;
    dev["AI_DtDiff"]     = round(gLastAi.dt_diff * 100) / 100.0;
    dev["AI_Shock"]      = round(gLastAi.shock   * 100) / 100.0;

    /* Điểm TỪNG CELL cũng đi kèm mọi gói. Trước đây chúng chỉ có trong
       publishAnomaly(), nên biểu đồ "Điểm bất thường từng cell" trên Grafana
       TRỐNG RỖNG suốt lúc bình thường — tức trống đúng lúc giám khảo nhìn, và
       chỉ có dữ liệu ở những khoảnh khắc đã báo động. Đường nền phẳng mới là
       thứ chứng minh mô hình không báo bừa; không có nó thì mất nửa câu chuyện. */
    for (int i = 0; i < AI_N_CELLS; i++) {
      char nm[16]; snprintf(nm, sizeof(nm), "AI_Score%02d", i + 1);
      dev[nm] = round(gLastAi.score[i] * 1000) / 1000.0;
    }
  }

  doc["ts"] = isoTimestampUtc();

  String out; serializeJson(doc, out);

  // Còn mạng thì gửi thẳng; mất mạng (hoặc gửi hỏng) thì ghi xuống flash để
  // đẩy bù sau. `ts` đã nằm sẵn trong payload nên gói đệm giữ đúng thời điểm
  // lấy mẫu, không phải thời điểm đẩy lên.
  bool linkReady = mqtt.connected() && millis() >= linkTrustedAt;
  bool ok = linkReady && mqtt.publish(topicData, out.c_str());
  if (ok) {
    Serial.printf("[DATA] OK   %s\n", out.c_str());
  } else {
    spoolAppend(out);
    Serial.printf("[DATA] DEM  (spool %u byte) %s\n", (unsigned)spoolSize(), out.c_str());
  }
}

// MỘT lần thử nối, không chặn. Gọi lại theo nhịp RECONNECT_MS từ loop().
bool mqttTryConnect() {
    // Last Will: nếu ESP mất điện/rớt mạng, broker tự báo cho cloud biết.
    JsonDocument will;
    will["d"]["UeD"] = 1;
    will["ts"] = isoTimestampUtc();
    String willPayload; serializeJson(will, willPayload);

    String clientId = "HuTieu-S3-" + String((uint32_t)ESP.getEfuseMac(), HEX);

    Serial.printf("[MQTT] noi %s:%d ...\n", gHost.c_str(), gPort);
    bool ok;
#if STAGE == 2
    ok = mqtt.connect(clientId.c_str(), gUser.c_str(), gPass.c_str(),
                      topicConn, 0, true, willPayload.c_str());
#else
    if (strlen(TEST_USER) > 0) {
      // Broker riêng của đội (Plan B) — có tài khoản, và đăng ký luôn Last Will
      ok = mqtt.connect(clientId.c_str(), TEST_USER, TEST_PASS,
                        topicConn, 0, true, willPayload.c_str());
    } else {
      // Broker công cộng — nối ẩn danh
      ok = mqtt.connect(clientId.c_str(), nullptr, nullptr,
                        topicConn, 0, true, willPayload.c_str());
    }
#endif
    if (ok) {
      Serial.println("[MQTT] KET NOI OK");
      // Nối được rồi mới nhớ — nhớ một địa chỉ chưa kiểm chứng là tự đặt bẫy
      // cho lần khởi động sau.
      brokerRemember(gHost.c_str(), gPort);
      mqtt.subscribe(topicCmd);
      mqtt.subscribe(topicAck);
      publishConnState(1);
      publishConfig();
      delay(1000);            // cho cloud kịp ghi nhận config trước khi bắn data
      publishHeartbeat();
      lastHeartbeat = millis();
      linkTrustedAt = millis() + LINK_GRACE_MS;
      Serial.printf("[BUFF] cho %lds cho subscriber nói lai roi moi day bu\n", LINK_GRACE_MS / 1000);
      size_t pending = spoolSize();
      if (pending) Serial.printf("[BUFF] co %u byte cho day bu\n", (unsigned)pending);
      return true;
    }

    Serial.printf("[MQTT] that bai, rc=%d ", mqtt.state());
    switch (mqtt.state()) {
      case -4: Serial.println("(timeout - sai host/port hoac firewall)"); break;
      case -2: Serial.println("(connect failed - TLS/DNS hong)");         break;
      case  4: Serial.println("(SAI USER/PASSWORD)");                     break;
      case  5: Serial.println("(KHONG DU QUYEN - sai tenant/credential)");break;
      default: Serial.println();
    }
    return false;
}

/* Đếm số lần nối MQTT hỏng LIÊN TIẾP. Xem khối tự cứu trong loop() (QĐ-048). */
static uint16_t gMqttFails = 0;
/* Với RECONNECT_MS = 5 s: ép nối lại Wi-Fi sau ~30 s, khởi động lại sau ~2 phút.
   Đủ lâu để không phản ứng với một cú rớt mạng bình thường, đủ nhanh để không
   ai kịp nhận ra trên sân khấu. */
#define MQTT_FAILS_REWIFI   6
#define MQTT_FAILS_REBOOT  24

// ============================================================ setup / loop
void setup() {
  /* Sưởi về LOW là lệnh ĐẦU TIÊN, trước cả Serial.begin(). Chân ESP32 lúc reset
     thả nổi; nếu Serial.begin() hay USB CDC kẹt vài trăm ms thì trong khoảng đó
     gate MOSFET có thể được kéo lên và điện trở bắt đầu nóng khi chương trình
     còn chưa chạy tới dòng nào điều khiển nó. Bài học từ bring-up 21/09. */
  gHeater.begin();

  Serial.begin(115200);
  delay(1500);
  Serial.println("\n\n===== Hu Tieu | Test duong truyen ESP32-S3 -> WISE-IoT =====");
  Serial.printf("STAGE = %d\n", STAGE);

  randomSeed(esp_random());
  for (int i = 0; i < NUM_CELLS; i++) cellBias[i] = random(-80, 81) / 100.0f;

  spoolBegin();
  gAI.begin();
  gAlarm.begin();

  gMeterOk = gMeter.begin(I2C_SDA, I2C_SCL);
  if (!gMeterOk) {
    // Không dừng máy: cảnh báo nhiệt độ (Lớp 1) vẫn chạy được mà không cần
    // dòng/áp. Nhưng phải nói to, vì im lặng ở đây nghĩa là Lớp 2 âm thầm
    // chạy trên số bịa — đúng cái đang cố sửa.
    Serial.println("[INA ] *** KHONG CO INA228 - dong va ap VAN LA SO GIA DINH ***");
  }
  gCharge.begin();

#if USE_REAL_TEMP
  gTempOk = gTemp.begin(TEMP_PIN);
  if (!gTempOk) {
    // KHÔNG dừng máy: an toàn tại chỗ vẫn phải chạy với số cảm biến còn lại.
    // Nhưng phải kêu to, vì đây đúng là chế độ hỏng im lặng đã dính lúc đo
    // hiệu chuẩn — chương trình chạy ngon lành với 6 cảm biến, không báo gì.
    Serial.println("[TEMP] *** THIEU CAM BIEN - so lieu KHONG day du ***");
  }
#endif
  WiFi.mode(WIFI_STA);
  wifiStart();
  // CHỜ CÓ HẠN, không chờ vô hạn. Bản cũ quay vòng mãi trong setup(): mạng
  // hỏng là board treo, Lớp 1 không chạy, còi không kêu — trong khi an toàn
  // tại chỗ đúng ra KHÔNG được phụ thuộc đường truyền. Hết giờ thì đi tiếp,
  // ensureWifi() trong loop() sẽ tự thử lại nền.
  // Mỗi mạng được 8 giây; hết thì sang mạng kế. Quét hết danh sách một vòng
  // rồi thôi — ensureWifi() trong loop() sẽ tiếp tục thử nền.
  for (int k = 0; k < WIFI_N && WiFi.status() != WL_CONNECTED; k++) {
    unsigned long t0 = millis();
    while (WiFi.status() != WL_CONNECTED && millis() - t0 < 8000) {
      delay(500); Serial.print(".");
    }
    Serial.println();
    if (WiFi.status() != WL_CONNECTED && k + 1 < WIFI_N) { wifiNext(); wifiStart(); }
  }
  if (WiFi.status() != WL_CONNECTED)
    Serial.println("[WiFi] CHUA NOI DUOC - chay tiep offline, se tu thu lai");
  else
    Serial.printf("[WiFi] OK, mang %s, IP %s, RSSI %d dBm\n",
                  WIFI_LIST[gWifiIdx].ssid,
                  WiFi.localIP().toString().c_str(), WiFi.RSSI());
  ensureWifi();
  syncTime();
  buildTopics();

#if STAGE == 2
  gUseTls = true;                       // WISE-IoT dùng MQTT over TLS (8883)
  #if WISE_USE_DCCS
    while (!fetchCredentialFromDccs()) { Serial.println("[DCCS] thu lai sau 5s"); delay(5000); }
  #else
    gHost = MQTT_HOST_MANUAL; gPort = MQTT_PORT_MANUAL;
    gUser = MQTT_USER_MANUAL; gPass = MQTT_PASS_MANUAL;
  #endif
  netTls.setInsecure();                 // BƯỚC 1 bỏ qua kiểm tra CA cho nhanh.
                                        // Xong rồi hãy nạp CA thật (xem file .md).
  mqtt.setClient(netTls);
#else
  // Tự tìm broker thay vì tin IP biên dịch sẵn. IP máy chủ đổi liên tục vì
  // máy chạy lúc ở trường, lúc ở nhà, lúc qua hotspot điện thoại — ghim IP
  // nghĩa là mỗi lần đổi mạng phải nạp lại firmware. Xem broker_find.h.
  {
    BrokerAddr b = brokerFind(TEST_HOST, TEST_PORT);
    gHost = b.host; gPort = b.port;
    Serial.printf("[BRK ] broker = %s:%u (tim bang: %s)\n", b.host, b.port, b.how);
  }
  mqtt.setClient(netPlain);
  Serial.println("[i] Mo https://www.hivemq.com/demos/websocket-client/ ,");
  Serial.printf ("    Connect roi Subscribe topic:  /wisepaas/scada/%s/#\n", NODE_ID);
#endif

  mqtt.setServer(gHost.c_str(), gPort);
  mqtt.setCallback(onMqttMessage);
  mqtt.setBufferSize(4096);   // BẮT BUỘC: mặc định 256 byte, payload config sẽ bị cắt
  mqtt.setKeepAlive(90);

  mqttTryConnect();
  lastReconnect = millis();

  /* BLE khởi động SAU CÙNG, cố ý. Bluedroid ngốn vài chục KB heap; nếu nó
     tranh RAM với bộ đệm MQTT 4 KB và LittleFS thì phải để MQTT thắng —
     Wi-Fi là kênh chính lên cloud và là phần được chấm điểm (QĐ-021), BLE chỉ
     là kênh phụ cho thợ. Hỏng BLE thì mất tiện nghi; hỏng MQTT thì mất bài. */
  rulHistBegin();
  gBle.begin(DEVICE_ID);
  /* Hai hàm DUY NHẤT mà lệnh BLE chạm tới được. Sưởi không có mặt ở đây, cố ý:
     nó là thứ duy nhất bơm năng lượng vào pack nên vẫn chỉ đi qua MQTT có tài
     khoản kèm công tắc chết người (QĐ-042). */
  gBle.onCommand([](bool on){ gAlarm.setMuted(on); },
                 [](bool on){ gAlarm.setQuiet(on); });
}

void loop() {
  unsigned long now = millis();

  ensureWifi();   // không chặn

  // Thử nối lại theo nhịp, cũng không chặn. Trong lúc chưa nối được, phần
  // lấy mẫu bên dưới vẫn chạy bình thường và dữ liệu chảy vào spool.
  if (!mqtt.connected() && WiFi.status() == WL_CONNECTED &&
      now - lastReconnect >= RECONNECT_MS) {
    lastReconnect = now;
    if (mqttTryConnect()) {
      gMqttFails = 0;
    } else {
      gMqttFails++;
      /* --------------------------------------------------------------------
         TỰ CỨU KHI WI-FI "NÓI DỐI" (QĐ-048)

         Đo được 2 lần ngày 22/09: WiFi.status() trả WL_CONNECTED, RSSI tốt,
         nhưng máy khác KHÔNG ping tới được ESP32 và MQTT lặp rc=-2 hàng chục
         phút. Vòng lặp cũ chỉ thử lại MQTT mãi mãi và KHÔNG BAO GIỜ đụng tới
         Wi-Fi, vì điều kiện ở trên vẫn đúng. Không có nấc leo thang nào, nên
         chỉ rút điện cắm lại mới chữa được.

         Lần thứ hai nó xảy ra đúng lúc đang chạy thử: lệnh sưởi đi qua MQTT
         nên cả bài thử đứng hình. Hôm thi thì đó là "mất cloud" cho tới khi
         có người chạy lên sân khấu.

         Hai nấc, cả hai đều AN TOÀN VỚI DỮ LIỆU: spool nằm trên flash nên
         khởi động lại không mất gói nào (đang giữ 215 KB lúc đo).
         -------------------------------------------------------------------- */
      if (gMqttFails == MQTT_FAILS_REWIFI) {
        Serial.printf("[NET ] %d lan lien tiep khong noi duoc MQTT du WiFi bao OK "
                      "- ep noi lai WiFi\n", gMqttFails);
        WiFi.disconnect();
        wifiStart();
      } else if (gMqttFails >= MQTT_FAILS_REBOOT) {
        Serial.printf("[NET ] %d lan lien tiep van hong - KHOI DONG LAI "
                      "(spool %u byte con nguyen tren flash)\n",
                      gMqttFails, (unsigned)spoolSize());
        Serial.flush();
        delay(200);
        ESP.restart();
      }
    }
  }

  if (mqtt.connected()) {
    mqtt.loop();
    spoolFlush();   // đẩy bù tối đa FLUSH_BATCH gói mỗi vòng
  }

#if USE_REAL_TEMP
  // Máy trạng thái đọc cảm biến: gọi mỗi vòng, không chặn. Tự lo việc phát
  // lệnh chuyển đổi rồi quay lại lấy kết quả sau ~760 ms.
  gTemp.update();

  if (now - lastTempPrint >= TEMP_PRINT_MS) {
    lastTempPrint = now;
    gTemp.printStatus();
    publishSensorHealth();
  }
#endif

  /* Sưởi demo: NUÔI MỖI VÒNG, không phải theo nhịp 1 Hz của AI.
     Hạn mức an toàn phải được nuôi liên tục — đây đúng là chỗ đã sai ở bench
     ngày 21/09, khi đồng hồ hạn mức đứng yên trong lúc chương trình ngồi chờ và
     phép cắt không bao giờ tới. */
  gHeater.update(gCellTemp, AI_N_CELLS,
                 gTempOk && gTemp.status().n_healthy >= CT_N);

  /* Nút tắt tiếng cũng phải đọc MỖI VÒNG, cùng lý do với hạn mức sưởi ở trên:
     cú nhấn tay chỉ vài trăm ms, lấy mẫu 1 Hz là bỏ lọt. Đo 21/09: cú nhấn
     thứ hai của người dùng biến mất hoàn toàn vì chuyện này. */
  gAlarm.pollButton();
  gBle.tick();          // cho tắt tiếng từ BLE tự hết hạn

  // Lệnh bằng tay qua Serial. MQTT (phần B) sẽ gọi đúng hai hàm này, không có
  // đường tắt nào khác vào gHeater.
  if (Serial.available()) {
    const int c = Serial.read();
    if (c == 'w' || c == 'W') {          // w = warm: giữ ấm ổn định (TH-2)
      gHeater.request(DH_DEADMAN_MS, DH_MODE_STEADY);
      Serial.printf("[HEAT] xin giu am on dinh %lu s (goi lai de gia han)\n",
                    (unsigned long)(DH_DEADMAN_MS / 1000));
    } else if (c == 'h' || c == 'H') {
      gHeater.request();
      Serial.printf("[HEAT] xin bat %lu s (goi lai de gia han)\n",
                    (unsigned long)(DH_DEADMAN_MS / 1000));
    } else if (c == 's' || c == 'S' || c == '0') {
      gHeater.stop();
      Serial.println("[HEAT] da thu hoi lenh");
    }
  }

  // AI chạy 1 Hz, độc lập với nhịp gửi dữ liệu. Chạy cả khi MẤT MẠNG —
  // đây là lý do đặt AI on-device: an toàn không được phụ thuộc đường truyền.
  if (now - lastAi >= AI_PERIOD_MS) {
    lastAi = now;
    runAI();

    /* Cập nhật màn hình BLE ngay sau runAI(), trong cùng một nhịp — để thứ thợ
       đọc trên điện thoại và thứ còi đang kêu luôn là CÙNG MỘT bước tính. Đặt
       ở nhịp khác là mở cửa cho cảnh còi hét mà điện thoại vẫn xanh. */
    const PackMeasurement pmv = gMeter.read();
    gBle.update(gCellTemp, gLastAi, gAlarm.level(),
                gAlarm.muted(), gAlarm.quiet(),
                pmv.valid, pmv.voltage, pmv.current,
                pmv.valid ? crudeSocFromVoltage(pmv.cell_v) : 0.0f,  // đã là 0..100
                gTempOk ? gTemp.status().n_healthy : 0,
                WiFi.status() == WL_CONNECTED, mqtt.connected(),
                gAlarm.muteLeftS());
  }

  // Lớp 2: mô phỏng một chu kỳ sạc theo nhịp, chỉ khi đã có mạng để gửi
  if (now - lastSimCharge >= SIM_CHARGE_EVERY_MS && timeIsValid()) {
    lastSimCharge = now;
    simulateChargeCycle();
  }

  if (now - lastPublish >= PUBLISH_MS)    { lastPublish   = now; publishData(); }
  if (now - lastHeartbeat >= HEARTBEAT_MS){ lastHeartbeat = now;
                                            if (mqtt.connected()) publishHeartbeat(); }

  if (spoolDropped) {
    Serial.printf("[BUFF] CANH BAO: da bo %lu goi vi flash day\n", spoolDropped);
    spoolDropped = 0;
  }
}
