huynhpham13790-rgb/Innowork-2026/VEDCaPhenika/esp32s3_wiseiot_test/demo_heater.h

/* =============================================================================
 *  Sưởi một cell để diễn — có hạn mức cứng, cloud không nâng được.
 *
 *  VÌ SAO CẦN: kịch bản demo là "một cell nóng bất thường → Lớp 1 bắt được".
 *  Muốn diễn thì phải làm cho một cell nóng lên, và làm bằng tay thì không lặp
 *  lại được, không hẹn giờ được, và không dừng được từ xa.
 *
 *  ⚠️ ĐÂY LÀ MODULE DUY NHẤT TRONG FIRMWARE CHỦ ĐỘNG BƠM NHIỆT VÀO PACK PIN.
 *  Mọi thứ khác chỉ đọc. Nên nó được viết theo ba nguyên tắc, và cả ba đều đến
 *  từ chuyện đã xảy ra trên bàn thí nghiệm ngày 21/09 (QĐ-040):
 *
 *  1. CLOUD CHỈ ĐƯỢC XIN, THIẾT BỊ MỚI QUYẾT.
 *     Không có lệnh nào từ mạng nâng được các hạn mức dưới đây. Nút trên
 *     dashboard chỉ gửi "xin bật"; module tự kiểm rồi mới bật. Một nút bấm có
 *     thể nâng ngưỡng an toàn là một nút bấm đốt pack.
 *
 *  2. LỆNH XIN TỰ HẾT HẠN (công tắc chết người).
 *     Xin bật chỉ có hiệu lực DH_DEADMAN_MS rồi hết. Muốn sưởi tiếp thì phải
 *     xin lại. Mất mạng, sập Node-RED, đóng tab trình duyệt → sưởi TẮT, chứ
 *     không kẹt ở trạng thái bật lúc không ai nhìn.
 *
 *  3. HẠN MỨC THỜI GIAN KHÔNG ĐỌC CẢM BIẾN.
 *     Ngày 21/09 hệ an toàn của bench không cắt, vì nó chỉ nhìn nhiệt độ mà
 *     nhiệt độ lại đo ở chỗ không phải chỗ nóng nhất — đầu dò báo 47 °C trong
 *     khi thân điện trở đã bỏng tay, và thứ dừng thí nghiệm là BÀN TAY NGƯỜI.
 *     DH_MAX_ON_MS đếm thời gian, không đọc cảm biến: nó vẫn cắt khi đầu dò
 *     tuột, dán sai chỗ, hoặc tiếp xúc kém.
 *     23/09: nới từ 180 s lên 20 phút (cắt giữa chừng khi có keo tản nhiệt),
 *     và thêm DH_NORESP_* — "bật 4 phút mà cell không nóng thêm 0,5 °C thì
 *     chốt" — để bắt đúng ca đầu dò tuột mà không cắt một lần chạy bình thường.
 *
 *  VÌ SAO TRẦN 50 °C CHỨ KHÔNG PHẢI 60:
 *  AL_T_CRIT = 60 °C là lớp bảo vệ CUỐI CÙNG. Nếu demo chạy tới 60 thì lớp cuối
 *  cùng thành lớp làm việc hằng ngày, và ta mất mất cái đệm. Thêm nữa, đo được
 *  ngày 21/09: cắt ở 40 °C mà nhiệt vẫn vọt tiếp lên 45,62 °C — ngưỡng cắt
 *  KHÔNG phải trần nhiệt. Trần 50 để vọt lố còn chỗ mà vọt.
 *
 *  VÌ SAO +6 °C LÀ ĐỦ: Lớp 1 bắt 100 % lỗi offset ở +2 °C (QĐ-039). Đẩy lên
 *  +6 là thừa gấp ba, mà vẫn an toàn tuyệt đối. Demo KHÔNG cần đến gần 60 °C.
 * ========================================================================== */
#pragma once
#include <stdint.h>
#include "pack_config.h"

#define DH_PIN            10        // D4184 #1 -> điện trở sưởi
#define DH_MAX_DELTA_C    6.0f      // dừng khi cell nóng nhất vượt trung vị pack bấy nhiêu
#define DH_RESUME_DELTA_C 4.5f      // bật lại khi tụt xuống dưới mức này (trễ, chống nhấp nháy)
#define DH_ABS_MAX_C      50.0f     // trần tuyệt đối — CỐ Ý thấp hơn AL_T_CRIT 60
/* Hạn mức thời gian — ĐỔI 23/09 theo yêu cầu người phụ trách. 180 s cũ cắt giữa
   chừng: có keo tản nhiệt + Kapton thì nhiệt vào cell chậm, đo được cell vẫn
   đang lên khi bị cắt (lệch +1,2 °C lúc cắt, lên tới +2,0 °C sau đó). Mục đích
   của nó — bắt đầu dò TUỘT — giờ do DH_NORESP_* làm, và làm đúng hơn: nó đọc
   xem nhiệt có THẬT SỰ vào cell không, thay vì đoán bằng đồng hồ. */
#define DH_MAX_ON_MS      1200000UL // chốt cuối 20 phút bật — KHÔNG đọc cảm biến
#define DH_NORESP_MS      240000UL  // sau 4 phút bật mà...
#define DH_NORESP_RISE_C  0.5f      // ...cell nóng nhất lệch thêm chưa tới 0,5 °C => đầu dò tuột
#define DH_DEADMAN_MS     15000UL   // lệnh xin hết hiệu lực sau bấy nhiêu

/* HAI KỊCH BẢN (23/09). Chế độ NHANH bật hết cỡ tới +6 °C rồi bật/tắt quanh
   đó — mỗi lần bật lại là một đợt vọt thật, nên Lớp 1 thấy TH-1 gần như suốt
   (đo trên chip 23/09: 132/160 mẫu). Muốn diễn TH-2 thì cell phải NÓNG MÀ
   KHÔNG CÒN TĂNG, nên chế độ ỔN ĐỊNH điều khiển TỈ LỆ: công suất giảm dần khi
   tới gần đích, trần công suất thấp để tốc độ nóng không vượt ngưỡng "vọt"
   1 °C/phút của bảng tra. Hai chế độ dùng CHUNG mọi hạn mức an toàn ở trên —
   ổn định chỉ đổi cách bật/tắt BÊN DƯỚI các hạn mức đó, không nới cái nào. */
enum DhMode : uint8_t {
  DH_MODE_FAST   = 0,   // TH-1: bơm hết cỡ, cell vọt lên
  DH_MODE_STEADY = 1,   // TH-2: giữ ấm ổn định quanh DH_STEADY_DELTA_C
};
/* +5 chứ không +3: mô phỏng với trọng số thật cho thấy lệch ỔN ĐỊNH dưới
   ~+5 °C thì autoencoder chưa vượt ngưỡng (TH-2 chỉ hiện dạng, không báo
   động). +5 để khán giả thấy cả báo động lẫn nhãn TH-2; vẫn dưới trần +6. */
#define DH_STEADY_DELTA_C  5.0f
#define DH_STEADY_KP       0.4f      // tỉ lệ công suất cho mỗi °C còn thiếu
#define DH_STEADY_DUTY_MAX 0.30f     // ~1 °C/phút lúc xa đích — không thành "vọt"
#define DH_STEADY_WIN_MS   10000UL   // chu kỳ băm xung; nhiệt cell lọc mịn bên trong

enum DhState : uint8_t {
  DH_OFF = 0,     // không ai xin
  DH_HEATING,     // đang bơm nhiệt
  DH_HOLDING,     // đã tới +DH_MAX_DELTA_C, đang giữ (tắt, chờ nguội rồi bật lại)
  DH_BLOCKED,     // đã chốt vì chạm hạn mức an toàn — chỉ reset mới nhả
};

class DemoHeater {
 public:
  void begin();

  /* Xin bật trong `hold_ms` mili giây. Gọi lại để gia hạn. Đây là ĐIỂM VÀO DUY
     NHẤT từ bên ngoài (serial hoặc MQTT) — và nó chỉ XIN, không bật. */
  void request(uint32_t hold_ms = DH_DEADMAN_MS, DhMode mode = DH_MODE_FAST);

  /* Thu hồi lệnh xin ngay lập tức. */
  void stop();

  /* Gọi MỖI vòng lặp. temps = nhiệt các cell đã hiệu chỉnh; sensor_ok = bus còn
     đủ cảm biến khoẻ không. Tự quyết bật/tắt theo hạn mức. */
  void update(const float* temps, int n, bool sensor_ok);

  bool     on() const { return on_; }
  DhState  state() const { return st_; }
  DhMode   mode() const { return mode_; }
  const char* reason() const { return reason_; }
  /* Chênh lệch cell nóng nhất so với trung vị pack — số mà demo muốn đẩy lên. */
  float    delta() const { return delta_; }
  uint32_t secondsLeft() const;

 private:
  void  setPin(bool on);
  void  block(const char* why);

  bool     on_ = false;
  DhState  st_ = DH_OFF;
  DhMode   mode_ = DH_MODE_FAST;
  const char* reason_ = "chua ai xin";
  float    delta_ = 0;
  uint32_t deadman_until_ = 0;
  uint32_t t_on_ = 0;          // lúc bật lần gần nhất
  uint32_t on_accum_ = 0;      // tổng thời gian đã bật trong phiên xin này
  float    delta0_ = 0;        // chênh lệch lúc bắt đầu phiên — để đo nhiệt có vào cell không
  bool     delta0_set_ = false;
};
