huynhpham13790-rgb/Innowork-2026/VEDCaPhenika/esp32s3_wiseiot_test/cell_ae_weights.h

// Tự sinh bởi ai/export_c_model.py — ĐỪNG sửa tay.
// BẢN 11 ĐẶC TRƯNG THUẦN TƯƠNG ĐỐI (QĐ-033): đã bỏ 5 đặc trưng mang
// giá trị tuyệt đối (T-amb, packT-amb, |I|/scale, soc, (T-25)/25) vì
// chúng gắn chặt với một pack cụ thể và chặn đường sản xuất hàng loạt.
// Autoencoder phát hiện cell bất thường: 11 -> 8 -> 4 -> 8 -> 11
// Trọng số float32, firmware tự nhân (xem cell_ai.cpp).
#pragma once

#define AE_N_IN      11
#define AE_THRESHOLD 1.07072544f   // sai số tái tạo vượt mức này = bất thường
#define AE_PERSIST_S 30        // phải vượt liên tục bấy nhiêu giây mới báo động

// Chuẩn hoá đầu vào. PHẢI khớp ai/data/prepared/scaler.npz.
const float AE_FEAT_MEAN[11] = {
  0.000516513013f, -0.253373325f, 0.000395770738f, 0.500082731f, 3.37550759f, 0.00110849994f, 1.71874999e-05f, 0.0010913125f,
  0.000326716254f, 0.000189818355f, 0.165497705f
};

const float AE_FEAT_STD[11] = {
  1.51304042f, 1.58729672f, 0.996312857f, 0.323300481f, 3.36822748f, 1.93919015f, 0.714863777f, 1.79129803f,
  1.49314356f, 0.243471041f, 0.144185781f
};

// lớp 0: enc1  11 -> 8  (relu)
#define AE_L0_IN  11
#define AE_L0_OUT 8
const float AE_W0[88] = {
  0.445275784f, -0.193216696f, -0.0748918131f, -0.160330623f, 0.920237482f, -0.000251524005f, -0.271484435f, 0.0331013687f,
  0.206036419f, 0.053800486f, -0.0685394257f, -0.471074104f, 0.346042991f, 0.164334133f, 0.26757732f, -1.46502924f,
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
};

const float AE_B3[11] = {
  -0.326051831f, 0.461459607f, -0.697107673f, -0.457312047f, -0.652139068f, 0.14349027f, 2.64276028f, -1.05916703f,
  -0.128835633f, 0.338040113f, -0.971979439f
};
