huynhpham13790-rgb/Innowork-2026/(commit log)

2026-09-06 Khởi tạo repo + vá 4 lỗi chặng ESP32 -> cloud
    Kiểm chứng đường truyền Plan B bằng cách dựng thật stack Docker và giả lập
    ESP32 bắn đúng payload WISE-PaaS. Đường truyền thông, nhưng lộ ra 4 vấn đề:
    1. Node-RED (1880) và InfluxDB (8086) mở ra 0.0.0.0 mà Node-RED không có
    mật khẩu mặc định -> deploy được function node tuỳ ý = chạy code trên máy
    chủ. Đã rút cả hai về 127.0.0.1, vào từ xa bằng SSH tunnel.
    2. Lỗi ghi InfluxDB im lặng hoàn toàn: token sai (401) hay ts năm 1970 do NTP
    fail (422) đều mất dữ liệu mà không log gì, container vẫn xanh. Thêm node
    kiểm tra statusC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
    [DANH_SACH_MUA_LINH_KIEN_DOT1_DOT2.xlsx, DANH_SACH_MUA_LINH_KIEN_HuTieu.xlsx]
2026-09-06 Chạy thật trên ESP32-S3: store-and-forward hỏng, đã sửa
    Lần đầu nạp firmware lên board thật (MAC 7c:e8:b1:b2:7c:d4). Đường truyền
    thông: 800 điểm vào InfluxDB, đúng 100 mỗi cell, không mất gói. Dashboard
    Grafana đã dựng.
    Nhưng màn store-and-forward THẤT BẠI ở lần chạy đầu, và thất bại im lặng:
    Serial báo: [BUFF] day bu 33 goi, con lai 0 <- trông như thành công
    InfluxDB: LỖ HỔNG 15:15:06 -> 15:16:24 (78s) <- mất sạch
    Nguyên nhân: broker sống lại lúc 22:16:08, ESP32 nối lại sau 5s và bắn ngay
    33 gói buffer, nhưng Node-RED mãi 22:16:23 mới nối lại. Dữ liệu được publish
    v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
    [esp32s3_wiseiot_test.ino, test_spool.cpp]
2026-09-11 Lớp 1: autoencoder phát hiện cell bất thường, 4,1 KB INT8
    Pipeline đầy đủ từ tải dữ liệu tới file .h nhúng vào firmware.
    Quyết định thiết kế quan trọng nhất: mô hình KHÔNG nhận nhiệt độ cả pack mà
    nhận 16 đặc trưng TƯƠNG ĐỐI của từng cell so với phần còn lại. Nhờ vậy train
    trên pack 36 cell của bộ UPC nhưng chạy được thẳng trên pack 8 cell của đội,
    không phải sửa gì. Dữ liệu cũng được ép về đúng phần cứng trước khi train:
    1 cảm biến/cell (8× DS18B20), 1 Hz, bước lượng tử 0,0625 °C.
    Kết quả trên ca an toàn quan trọng nhất (ramp = tiền đề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
2026-09-11 C hoá đặc trưng + nhúng autoencoder vào ESP32, chạy được trên board thật
    Lớp 1 giờ chạy on-device: 16 đặc trưng viết lại bằng C, autoencoder tự nhân
    tay, +5,5 KB flash và +2,9 KB RAM. Trên board thật cell #5 (cố ý cho nóng dần)
    đạt điểm 5,189 so với ngưỡng 1,847, trong khi 7 cell còn lại đều ~0,4.
    Kết quả AI đi hết lên InfluxDB mà KHÔNG phải sửa data contract — mã hoá trạng
    thái bằng số nên vẫn lọt qua payload WISE-PaaS như dữ liệu nhiệt độ, và cũng
    được store-and-forward đệm lại khi mất mạng.
    Khác kế hoạch ban đầu: KHÔNG dùng TFLite Micro (QĐ-013). Mô hình 356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
2026-09-11 Lớp 2 RUL/SOH: mô hình đơn giản thắng LSTM, và cập nhật ngược tài liệu
    LỚP 2 — dự báo số chu kỳ còn lại tới khi pin còn 80% dung lượng, chạy cloud.
    NASA PCoE, 4 pin, 364 chu kỳ, đánh giá leave-one-battery-out.
    Chỉ dùng đặc trưng PHA SẠC (QĐ-016): dung lượng phóng vừa là rò rỉ nhãn (RUL
    tính TỪ nó), vừa không đo được ngoài đời vì phải phóng kiệt pin. Pha sạc thì
    ngày nào cũng có. Bẫy đã gặp: thời gian sạc CC thô vô dụng vì phụ thuộc pin
    còn bao nhiêu lúc cắm (11 phút vs 38 phút, không phải do lão hoá) -> mọi đặc
    trưng thời gian đo trên khoảng điện á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
2026-09-11 Nối luồng thật Lớp 2: ESP32 -> cloud tính RUL/SOH -> Grafana
    Toàn tuyến chạy trên board thật: ESP32 gửi 9 đặc trưng pha sạc mỗi chu kỳ,
    Node-RED nhân hệ số ra RUL/SOH, ghi InfluxDB, vẽ Grafana. Quan sát được
    RUL giảm 85,2 -> 79,6 chu kỳ và SOH 90,6% -> 90,2% khi pin mô phỏng già đi.
    Chia việc (QĐ-018): ESP32 KHÔNG chạy mô hình, chỉ gửi 9 con số. Mô hình là
    tích vô hướng (RUL 2 tham số, SOH 10) nên nhúng hệ số thẳng vào node function
    của Node-RED - không thêm container. Đổi mô hình không phải nạp lại firmware,
    cần thiết vì hệ số còn phải hiệu chỉnh cho pack thật.
    Test so C v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
2026-09-14 Cảm biến thật: 8/8 chạy, nhưng lệch 0,575°C giữa cảm biến; chốt giữ Wi-Fi, BLE làm sau
    - BANG_CHUNG_CAM_BIEN_2026-09-14.md: 8 DS18B20 lên bus, nhiễu 0,03°C nhưng
    sai lệch giữa kênh 0,575°C -> AE bắt lỗi offset 0,5°C ở 41,7%, tức là
    ~4/10 khả năng báo động giả vĩnh viễn nếu không hiệu chỉnh.
    - NGUOI_DUNG_VA_KICH_BAN.md: tách 3 nhóm người dùng (quản lý / thợ / người
    lái) và phân vai 4 kênh truyền. BLE phục vụ thợ, không thay được cloud.
    - QĐ-021 (giữ Wi-Fi, BLE bổ sung), QĐ-022 (hiệu chỉnh offset + đọc không chặn).
    - AC-06.10..6.14.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
2026-09-14 Bán kết là 26/09 chứ không phải 15/09; bỏ cách lập luận theo đếm ngày
    Landing page BTC ghi 26/09, tài liệu đội ghi 15/09 — DOC_LANDING_PAGE_BTC.md
    đã nêu chênh lệch này từ 06/09, nay chốt theo BTC.
    Giữ nguyên mọi mốc 15/9/2026 của việc tắt sóng 2G — đó là sự kiện khác, chỉ
    sửa câu nói nhầm rằng nó trùng ngày Bán kết.
    Viết lại Phần 3 của NGUOI_DUNG_VA_KICH_BAN và QĐ-021: chốt phương án dựa trên
    ba nhóm người dùng đứng ở ba chỗ khác nhau, không dựa trên còn bao nhiêu ngày.
    Kết luận không đổi (Wi-Fi là kênh chính, BLE là kênh phụ cho thợ kỹ thuật)
    nhưng l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
2026-09-14 Ép bus DS18B20: phát hiện đang chạy nguồn ký sinh, lỗi đọc tới 35%
    Chạy 4 lần cùng sketch, không động vào phần cứng: tỉ lệ lỗi 0,00% -> 31,86%
    -> 35,42%. isParasitePowerMode() = true. Cả 8 kênh mất cùng lúc, P08 đọc ra
    -20C và +43C trong phòng 28C -> sụt áp lúc chuyển đổi, không phải cảm biến hỏng.
    Rút lại con số 0,575C ở commit trước: đo trên bus không tin được, và đo trong
    không khí là môi trường không đẳng nhiệt (offset lệch 0,15C giữa các lần chạy,
    gấp 5 lần nhiễu). Kết luận 'phải hiệu chỉnh' vẫn đúng, bảng số thì phải đo lại.
    QĐ-023 + AC-06.12..6.1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
2026-09-14 Đính chính: đấu dây vẫn đúng, lỗi là do cờ ký sinh bị chốt + tiếp xúc chập chờn
    Hỏi readPowerSupply() riêng từng con 200 lần/con: 1600 lần hỏi, 0 lần ký sinh.
    Cách đấu 3 hàng + trở 4,7k là đúng. Kết luận 'phải đấu lại VDD' ở commit trước SAI.
    Nguyên nhân thật: trong DallasTemperature 4.0.6, parasite=false chỉ nằm ở
    setOneWire(), begin() chỉ bật chứ không tắt, và quyết định bằng đúng một lần
    hỏi mỗi con lúc quét bus. Một lần nhiễu thoáng qua là chốt cả phiên -> giải
    thích vì sao lỗi có dạng chốt 0%/33% chứ không suy giảm dần.
    Lỗi bus hiện không tái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
2026-09-14 Hiệu chuẩn offset 8 cảm biến trong nước: 0,3665°C, hai lần khớp 0,025°C
    Bó cụm nhúng nước, đo 2 lần độc lập 5 phút/350 vòng. Lệch lớn nhất giữa hai
    lần 0,025°C, dưới tiêu chí 0,05 -> số liệu tin được. So với đo trong không khí
    (cùng kênh xáo trộn tới 0,359°C) thì ổn định hơn 14 lần.
    Sai số chế tạo thật: 0,3665°C (P03 nóng nhất, P02 lạnh nhất). Trong dải ±0,5°C
    của datasheet nhưng vượt xa ngưỡng bỏ qua 0,1°C -> PHẢI hiệu chỉnh.
    Hệ số + 8 địa chỉ ROM ghi vào esp32s3_wiseiot_test/ds18b20_offsets.h.
    QĐ-025: chỉ hiệu chuẩn cái thuộc về DỤNG CỤ ĐO, khô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
2026-09-14 Nối 8 cảm biến thật vào firmware: Lớp 1 chạy trên nhiệt độ đo được
    cell_temp.h/.cpp — module đọc DS18B20 dùng được trên xe thật:
    - đọc theo ROM (bảng DS_ROM), không theo index: thay cảm biến không làm hoán
    vị dữ liệu 8 cell
    - không chặn: requestTemperatures() rồi quay lại lấy kết quả sau 760ms, để
    mqtt.loop() không rớt keep-alive
    - trừ offset chế tạo (QĐ-022)
    - đếm lỗi theo từng kênh, loại kênh hỏng khỏi đầu vào Lớp 1 (QĐ-024), đẩy
    Sensor_Healthy/ErrPct/FaultMask lên cloud đúng data contract cũ
    Kiểm chứng trên board (test/cell_temp_ai_bench, symlink tới nguồn thật)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
2026-09-14 Tìm ra nguyên nhân lỗi bus: ẩm ở đầu dò, không phải tiếp xúc breadboard
    Lau khô đầu dò -> 3 lần chạy 5 phút liên tiếp đều 0,0000% lỗi (3×2800 đọc).
    Từ 9,4% về 0% chỉ bằng thao tác lau khô. AC-06.14 đạt.
    Nghi ngờ ban đầu (tiếp xúc breadboard) sai hướng. Giữ lại đoạn suy luận sai
    vì bài học đáng giá: dấu hiệu 'cả 8 kênh mất cùng lúc' hợp với CẢ HAI giả
    thuyết nên không phân biệt được — thứ phân biệt được là can thiệp rồi đo lại.
    KQ-11: ba lần đo lúc khô cho bảng offset khớp bảng nước trong 0,028C ở 6 kênh,
    riêng P07/P08 lệch 0,049 và 0,068. Ba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
2026-09-14 WiFi ICTU (mạng mở) + setup() không còn chờ WiFi vô hạn
    Mạng mở phải gọi WiFi.begin(ssid) một tham số; truyền chuỗi rỗng làm mật khẩu
    thì driver vẫn thương lượng theo kiểu có mã hoá và hỏng im lặng.
    Bỏ vòng chờ vô hạn trong setup(): mạng hỏng là board treo, Lớp 1 không chạy,
    còi không kêu — trong khi an toàn tại chỗ đúng ra KHÔNG được phụ thuộc đường
    truyền. Giờ chờ tối đa 20s rồi đi tiếp, ensureWifi() tự thử lại nền.
    Chạy thật trên ICTU: WiFi OK (RSSI -49), NTP OK, MQTT OK, 8/8 cảm biến,
    tỉ lệ lỗi 0,000%, store-and-forward đẩy bù 9 gói, Lớp 2 gửi 9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
2026-09-14 Toàn tuyến trên cảm biến thật: phép thử mù, AI chỉ đúng kênh bị làm nóng
    Người làm chọn một đầu dò bất kỳ áp vào máy tính nóng, không nói là con nào.
    AI chỉ ra cell 8, điểm 55,077 vs ngưỡng 1,847 — vượt 30 lần, trong khi 7 cell
    còn lại 1,29–1,71 đều dưới ngưỡng. Đáp án đúng.
    InfluxDB nhận đủ: Cell08_Temp 43,18 trong khi 7 cell kia ~28,5; AI_WorstCell=8;
    Sensor_Healthy=8, Sensor_ErrPct=0. Bốn tag Sensor_* là phần mới theo QĐ-024,
    vẫn trong {"d":{...},"ts":...} nên không đụng data contract.
    Hạ tầng:
    - ESP32 chuyển từ HiveMQ công cộng sang broker của đội
    - mật khẩu MQTT t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
    [arduino_secrets.example.h, esp32s3_wiseiot_test.ino]
2026-09-14 Cảm biến thứ 9 đo nhiệt độ môi trường — bỏ được hằng số 28°C giả định
    Trước đây ambient là hằng số nhét vào giữa đường dữ liệu thật: pack nóng lên
    10°C vì trời nắng sẽ bị đọc nhầm thành pack tự sinh nhiệt. Giờ là số đo.
    Không có con thứ 9 thì vẫn chạy (lùi về hằng số), nhưng mã hoá chuyện đó thành
    tag Ambient_IsReal=0 lên dashboard chứ không im lặng dùng số giả định.
    Offset của nó CHƯA hiệu chuẩn (DS_AMBIENT_CALIBRATED 0) — phải nhúng nước cả 9
    con MỘT LƯỢT, vì thứ cần đúng là chênh lệch giữa nó và các cell; hiệu chuẩn
    riêng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
2026-09-14 Đính chính: pack là 18650 2,55 Ah (không phải HG2 3 Ah) — Lớp 2 khả thi hơn tưởng
    Tài liệu ghi LG HG2 3 Ah là KẾ HOẠCH MUA, không phải thứ đã mua. Thực tế 18650
    2,55 Ah, 8 viên, 2 đế 4 cell nối tiếp (8S).
    Hệ quả lớn: NASA PCoE dùng CÙNG loại cell 18650, 2,0 Ah — lệch dung lượng chỉ
    27%. Mượn hệ số NASA giờ có cơ sở vật lý chứ không còn là chắp vá. Điều kiện:
    phải sạc ở 1,9 A để khớp tốc độ 0,75C của NASA.
    QĐ-026 cũng ghi lại đường vòng cho việc hiệu chuẩn: không lão hoá được pin thì
    mượn pin đã chai sẵn (18650 tháo từ pin laptop), đo dung lượng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
2026-09-14 Hiệu chuẩn lại cả 9 cảm biến trong nước — hai lần khớp 0,012°C
    Bó cả 9 con, chỉ nhúng đầu kim loại (giữ dây trên mặt nước, theo bài học ẩm
    gây lỗi bus). Hai lần chạy 6,5 phút, cả hai 0,0000% lỗi.
    Hai bảng khớp nhau trong 0,012°C — tốt gấp 4 lần tiêu chí 0,05. Và khớp bảng
    đo mẻ trước (8 con) trong 0,029°C ở MỌI kênh, kể cả P07/P08 vốn từng lệch
    0,049 và 0,068 khi đo lúc khô. Kết luận: bản đo trong không khí mới là bản sai,
    do bó cụm khô vẫn còn chênh nhiệt giữa lõi và rìa. Nước là đúng.
    Offset cảm biến môi trường: +0,0452°C. Mốc quy chiếu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
2026-09-14 QĐ-027: trả lời phản biện 'đo từng cell để làm gì'
    Đính chính sự thật: Lớp 2 vốn ĐÃ là mức pack (charge_cycle.cpp nhận pack_voltage,
    xuất một RUL + một SOH), không đo từng cell. Kịch bản '7 cell 85%, 1 cell 80%'
    không phải thứ hệ thống sinh ra. Pack nối tiếp có dung lượng bằng cell yếu nhất
    nên SOH pack đã phản ánh cell yếu nhất rồi.
    Lớp 1 đo từng cell vì (a) an toàn — hành động là NGẮT SẠC và cách ly, không phải
    thay cell; một cell nóng chỉ kéo trung bình pack lên 1/8 nên đo trung bình là
    pha loãng tín hiệu 8 lần; (b) chẩn đoán — phân biệt 'một cell lỗi'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
2026-09-14 Tài liệu: hai lớp AI hoạt động ra sao, 7 trường hợp và việc phải làm
    Viết docs/HAI_LOP_AI_HOAT_DONG_THE_NAO.md để ai trong đội cũng giải thích được.
    Lớp 1: 5 trường hợp — cell nóng nhanh hơn hẳn (tiền đề thermal runaway, ngắt
    sạc + cách ly), cell nóng ổn định (theo dõi, đổi vị trí để phân biệt cell hay
    tản nhiệt), cell LẠNH bất thường (mất kết nối / cảm biến bong — dễ bỏ sót vì ai
    cũng chỉ canh nóng), cả pack nóng (Lớp 1 KHÔNG bắt được, bắt bằng ngưỡng cứng),
    vượt 60°C (ngắt ngay).
    Lớp 2: giải thích vật lý — cell chai thì nội trở tăng,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
2026-09-15 Báo động tại chỗ: còi + đèn 4 mức leo thang (QĐ-028)
    Trước đây hệ chỉ cảnh báo qua Serial và dashboard — cả hai đều giả định
    có người đang nhìn màn hình. Kịch bản nguy hiểm nhất là sạc qua đêm.
    - alarm.{h,cpp}: 4 mức OK/THEO DÕI/BÁO ĐỘNG/NGUY KỊCH + trạng thái
    riêng cho mất cảm biến (xanh dương, không trộn vào màu đỏ)
    - Ngưỡng cứng 60°C đi đường riêng, không qua AI: AI sai thì nó vẫn kêu
    - Trễ 5°C chống còi kêu ngắt quãng quanh ngưỡng
    - Tắt tiếng được, tự huỷ khi leo thang
    - test/alarm_bench: 11/11 đạt, symlink tới mã thật nên không phân kỳ
    - S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
2026-09-15 Đo mức đánh đổi khi bớt cảm biến nhiệt (QĐ-030)
    Kết thúc tranh luận trong đội bằng số liệu thay vì cảm giác.
    - ramp ở 2°C/10phút: trễ 1142s (8 cb) / 2993s (4 cb) / 8063s (2 cb)
    - offset 5°C: 100% / 96% / 0% — pha loãng làm N=2 mù hoàn toàn
    - Bẫy: báo oan GIẢM khi bớt cảm biến, vì mù chứ không phải chính xác
    - Kết luận: lab giữ 8, thương mại rút tối đa còn 4, loại bỏ 2
2026-09-15 Driver INA228: dòng + điện áp pack + đếm coulomb (QĐ-031)
    Không cần mua gì thêm để đo điện áp pack — INA228 đo bus tới 85V
    bằng ADC 20 bit, pack 8S tối đa 33,6V.
    - pack_meter.{h,cpp}: kiểm DEVICE_ID, dải shunt rộng chống tràn,
    kiểm khoảng hợp lý, thanh ghi CHARGE cho đếm coulomb
    - Phép giải mã tách thành hàm thuần => kiểm được KHÔNG CẦN CHIP
    - test/pack_meter_bench: 14/14 đạt, giá trị thô tính tay từ datasheet
    - runAI() thôi dùng hằng số bịa 0.0f/80.0f; có Meter_IsReal lên cloud
    - Còn nợ: đo lại PM_R_SHUNT (~5% sai số), SOC bằng đếm coulomb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
2026-09-15 Kiểm chứng Lớp 1 trên pack thật: TRƯỢT, và tìm ra nguyên nhân (QĐ-032)
    Bộ McMaster 72 cell, lỗi nhiệt gây cố ý, CC-BY 4.0. Zero-shot.
    Kết quả âm tính: file BÌNH THƯỜNG US06_15C bị báo 98,7% thời gian,
    cao hơn cả file LỖI UDDS_Blocked (12,4%). Tỉ lệ báo bám theo chu
    trình lái và nhiệt độ buồng, không bám theo nhãn lỗi.
    Nguyên nhân khoanh được: 4 đặc trưng bối cảnh toàn pack lệch tới
    8,6 sd; các đặc trưng tương đối giữa cell chỉ lệch <=1,6 sd và
    chuyển giao tốt. Vì 4 cái kia giống nhau ở mọi cell nên chúng đẩy
    sai số của tất cả cell lên cùng lúc.
    Cũng phát hi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
2026-09-15 AE thuần tương đối + ESP32 tự tìm broker (QĐ-033 đề xuất, QĐ-034)
    Trả lời câu 'mỗi pack một khác thì sản xuất hàng loạt kiểu gì'.
    Vấn đề không phải mỗi pack một khác, mà là đang trộn hai loại thông
    tin khác hẳn nhau vào một mô hình. Bỏ 5 đặc trưng tuyệt đối, giữ 11
    đặc trưng thuần tương đối:
    - Báo oan 0,0360% -> 0,0106% (thấp hơn 3,4 lần)
    - offset 2°C 79% -> 100%; ramp 2°C trễ 1142s -> 844s
    - drift 5°C 46% -> 88% (điểm yếu nặng nhất, gần gấp đôi)
    - McMaster: lỗi 0,36-1,26% vs bình thường <=0,065%, tách ~19 lần
    Dự đoán của tớ trước khi chạy (báo oan tăn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
    [broker_find.cpp, broker_find.h, esp32s3_wiseiot_test.ino]
2026-09-15 Thiết kế lại giao diện + WiFi nhiều mạng
    Giao diện: 6 -> 13 panel, đối tượng là giám khảo trong 5 phút.
    - Hàng đầu trả lời 'an toàn không / cell nào / tin được không' trong
    3 giây, không phải đọc biểu đồ. Bản cũ đặt 8 đường nhiệt lên đầu,
    bắt người xem làm việc của máy.
    - Thêm hàng ĐỘ TIN CẬY: Meter_IsReal, Sensor_Healthy, Sensor_ErrPct,
    Alarm_Level, Alarm_Events — số giả định phải tự khai là giả định
    - Nhiệt độ 8 cell dùng bar gauge (so sánh không gian) thay vì 8 đường
    - Ngưỡng 1,847 và 60°C vẽ thành đường, không bắt người xem tự nhớ
    - Sinh bằn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
2026-09-15 Bỏ file cấu hình riêng của máy khỏi repo
    docker-compose.override.yml.khong-can-nua là cấu hình local. Đổi tên
    file làm nó thoát .gitignore (mẫu cũ chỉ khớp đúng tên gốc). Sửa mẫu
    thành docker-compose.override.yml* để không dính lại.
2026-09-15 Chuyển Lớp 1 sang 11 đặc trưng thuần tương đối (QĐ-033 đã chốt)
    So sánh trực tiếp, cùng script dò ngưỡng, cùng dữ liệu val:
    ngưỡng 1,8474 -> 1,0707
    giữ 60s -> 30s
    trễ ramp 138ph -> 104ph
    báo oan 1 lần/1,3 ngày -> 0 lần trên 6.123.080 mẫu-cell
    Bỏ 5 đặc trưng mang giá trị tuyệt đối (T-amb, packT-amb, |I|/scale,
    soc, (T-25)/25). Chúng giống hệt nhau ở mọi cell nên không giúp phân
    biệt cell nào, mà lại gắn chặt với một pack cụ thể. Nút thắt 4 chiều
    giờ dành trọn cho cấu trúc tương đối.
    - cell_ae_weights.h: 271 tham số, 1,1 KB (nhỏ hơn bản cũ)
    - test_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
2026-09-21 Bring-up phần cứng đợt 3: INA226 + D4184 + sưởi + còi (QĐ-037)
    Sketch chẩn đoán test/hw_bringup_6s, menu serial T1..T9 theo phiếu test, cộng
    thêm 'd' — quét 3 trạng thái gate. Chín test ĐẠT toàn bộ.
    Test 'd' không có trong phiếu gốc và chính nó tìm ra lỗi: phiếu đo gate LOW ở
    T2 và gate HIGH ở T3 trong hai lần chạy khác nhau, nên hai số không so được
    với nhau. Đo liên tiếp LOW/HIGH/thả-nổi mới thấy cả ba đều 619 mA.
    Nguyên nhân: dây 3,3 V cắm vào cọc trigger D4184 ghim cứng gate lên cao. Bằng
    chứng quyết định là bật điện trở kéo xuống TRONG chip mà GPIO10 vẫn đọc mức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
2026-09-21 PackMeter chạy được cả INA226 lẫn INA228, tự nhận chip (QĐ-037)
    INA228 chưa về, đội lắp INA226 vào chạy trước. Thay vì sửa qua sửa lại mỗi lần
    đổi chip, begin() đọc mã định danh rồi cấu hình theo con đang cắm. Giao diện
    PackMeasurement không đổi nên firmware chính không phải sửa dòng nào.
    Thử INA228 trước trong chuỗi nhận dạng: thanh ghi 0x3F không tồn tại trên
    INA226 nên đọc ra giá trị không xác định, còn 0xFE/0xFF của INA228 lại là thanh
    ghi hợp lệ khác — thứ tự ngược lại dễ nhận nhầm hơn.
    Ba khác biệt của INA226 và cách xử lý:
    - Toàn thang chỉ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
2026-09-21 Chuyển pack sang 6S, gom số cell về một nguồn sự thật (QĐ-038)
    Thực hiện QĐ-036 (chốt 19/09, chưa sửa code). Pack chạy 6S; 8S giữ làm bản dự
    phòng, bật lại bằng một dòng.
    QĐ-036 liệt kê năm hằng số ở bốn file và cảnh báo "đổi thiếu một chỗ là lệch
    chỉ số cell âm thầm". Sửa tay năm chỗ thì lần sau đổi lại vẫn đúng rủi ro ấy,
    nên thêm pack_config.h giữ PACK_N_CELLS duy nhất, mọi hằng số khác suy ra.
    PACK_N_CELLS khác 6/8 bị #error chặn ngay lúc biên dịch.
    QĐ-036 đếm thiếu — có SÁU chỗ chứ không phải năm. NUM_CELLS trong .ino không
    nằm trong danh sác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
    [cell_ai.h, cell_temp.cpp, cell_temp.h, charge_cycle.h, ds18b20_offsets.h, esp32s3_wiseiot_test.ino, pack_config.h]
2026-09-21 Hồ sơ + slide Bán kết, sửa 2 lỗi dashboard, cập nhật tài liệu
    Hồ sơ nộp BTC (tiếng Anh) + bản tiếng Việt y hệt, và bộ 19 slide song ngữ, đều
    sinh lại được bằng docs/tools/build_dossier.py và build_deck.py — sửa chữ thì
    sửa trong script rồi chạy lại, đừng sửa thẳng file xuất ra.
    Cố ý KHÔNG đưa con số phần trăm lên slide/hồ sơ: đội đang nghiên cứu trên pack
    thí nghiệm dựng từ cell cùng loại và trên dữ liệu công khai, chưa đo trên pack
    xe điện đang chạy. Số liệu gốc gom trong HUONG_DAN để trả lời khi bị hỏi.
    Ảnh xe cháy trên slide 2 là xe XĂNG và ch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
2026-09-21 Gán nhãn 8 đầu dò DS18B20 bằng nước lạnh, sửa lại chẩn đoán P05
    test/ds18b20_identify: nhúng một đầu dò vào nước lạnh, sketch in ra tên con
    đang tụt nhiệt. Đã gán nhãn xong cả 8 sợi, dán giấy 1..8.
    Cả 8 ROM khớp 100 % bảng DS_ROM đã hiệu chuẩn, không có ROM lạ => không con
    nào bị thay => DS_OFFSET vẫn đúng, không phải hiệu chuẩn lại (QĐ-025).
    So với TRUNG VỊ cả dàn chứ không dùng ngưỡng tuyệt đối kiểu "dưới 20 °C là
    đang nhúng": ngưỡng đó phụ thuộc nước lạnh tới đâu và phòng nóng tới đâu, hôm
    nay đúng mai sai. Trung vị chứ không phải trung bìn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
2026-09-21 Sửa chập chờn bus 1-Wire: nguyên nhân là cắm nhầm ray, đã hàn chụm
    Người phụ trách tìm ra nguyên nhân thật: có đầu dò cắm nhầm ray trên
    breadboard. Ray nguồn bị cắt đôi ở giữa, hai nửa không thông nhau trừ khi có
    dây bắc qua — con nào nằm nửa có điện thì chạy, nửa kia thì câm, chạm tay vào
    là đổi. Khớp toàn bộ số liệu đã đo.
    Đã hàn 8 DATA / 8 VDD / 8 GND thành ba bó, mỗi bó ra một dây jump.
    Đo sau khi sửa:
    so cam bien 7/8 chap chon -> 8/8 on dinh qua nhieu lan khoi dong
    loi doc (T5 x2) - -> 1 / 2.272 (0,04 %), luot hai 0/1136
    tan nhiet cac kenh 0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
2026-09-21 Đo Lớp 1 ở 6 cell (QĐ-039): giữ nguyên mô hình và ngưỡng
    ai/pack_size_study.py: so cùng một mô hình chạy trên pack 8 cell và 6 cell.
    Pack 6 lấy là 6 cell ĐẦU của đúng pack 8 đó, lỗi tiêm vào CÙNG một cell — nên
    mọi khác biệt đo được đều đến từ thống kê pack, không phải từ việc hai bên nhìn
    vào những cell khác nhau.
    Kết quả: KHÔNG phải huấn luyện lại, KHÔNG phải đổi ngưỡng.
    bao dong gia @1.0707 N=8 0.0000% N=6 0.0000%
    nguong p99.9 cua diem N=8 1.17955 N=6 1.17975 (lech 0,02%)
    offset 2 °C N=8 100%/75s N=6 100%/77s
    ramp 1 °C/10ph N=8 100%/3212s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
2026-09-21 Đặc tính nhiệt điện trở sưởi (QĐ-040): ngưỡng cắt không phải trần nhiệt
    test/heater_thermal: đầu dò P07 (ngoài cấu hình 6S) quấn lên điện trở sứ, đo
    tốc độ lên, độ vọt lố sau khi cắt, và hằng số nguội.
    toc do len 0,115 °C/s (28,81 -> 40,00 °C trong 97,7 s, 720 J)
    cat tai 40,00 °C, t = 97 s
    DINH 45,62 °C tai t = 157 s -> 60 GIAY SAU KHI CAT
    VOT LO +5,62 °C
    hang so nguoi tau ~ 407 s (nguoi 95 % can ~20 phut)
    LỖ HỔNG 1 — ngưỡng cắt không phải trần nhiệt. Nhiệt đã nằm trong khối sứ vẫn
    lan ra đầu dò sau khi ngắt điện. Chiếu sang AL_T_CRIT =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
2026-09-21 Đo lại hằng số nguội bằng mốc dài hơn, và cái bẫy demo chạy hai lần
    Người phụ trách thấy điện trở "đã nguội" trong khi tài liệu ghi ~20 phút. Đo
    lại: lúc đó đầu dò đọc 35,25 °C, nền 26,4 °C — còn cao hơn nền 8,9 °C, mới đi
    được nửa đường. Da người ~33 °C nên 35 °C sờ vào thấy trung tính; bàn tay là
    dụng cụ tốt ở dải nóng nhưng mù ở dải ấm.
    tau uoc lai ~359 s (tu 54 % quang duong, 4,6 phut) so voi 407 s uoc dau (tu 2
    diem tren 122 s, moi 26 % quang duong). Lech 12 % — uoc dau khong te, nhung da
    duoc trinh bay chac chan hon muc du lieu cho phep. Con so dung: ~18 phut de ve
    trong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
2026-09-21 Kịch bản đầu-cuối chạy thông, và 3 lỗi chỉ lộ ra khi chạy trọn chuỗi
    demo_heater: module duy nhất trong firmware chủ động bơm nhiệt vào pack. Ba
    nguyên tắc, cả ba đến từ chuyện đã xảy ra trên bàn 21/09:
    1. Cloud chỉ được XIN, thiết bị mới QUYẾT — không lệnh nào từ mạng nâng được
    hạn mức. Nút dashboard chỉ gửi "xin bật".
    2. Lệnh xin tự hết hạn sau 15 s (công tắc chết người). Mất mạng, sập Node-RED,
    đóng tab -> sưởi TẮT, không kẹt ở trạng thái bật lúc không ai nhìn.
    3. Hạn mức thời gian KHÔNG đọc cảm biến — vẫn cắt khi đầ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
2026-09-21 Bảng điều khiển demo trên Node-RED: cloud xin, thiết bị quyết
    http://127.0.0.1:1880/hutieu — nút xin bật sưởi và tắt tiếng còi khi diễn.
    Chỉ dùng node LÕI của Node-RED (http in / template / mqtt out), không cài
    palette nào: giữ kỷ luật ghim phiên bản, và không thêm thứ có thể hỏng vào
    ngày thi.
    NGUYÊN TẮC: onMqttMessage() KHÔNG bật sưởi. Nó chỉ gọi gHeater.request(), rồi
    DemoHeater tự kiểm trần 50 °C, hạn mức thời gian, mất cảm biến mới quyết. Không
    lệnh nào từ mạng nâng được hạn mức; request() còn kẹp hold_ms xuống tối đa
    DH_DEADMAN_MS nên payload xin 1 giờ cũng c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
2026-09-21 BLE chỉ đọc cho thợ kỹ thuật, và cổng USB thôi tự bấm nút tắt tiếng
    Thêm ble_view: dịch vụ GATT "HuTieu-BMS", 5 đặc tính CHỈ ĐỌC + notify, có
    nhãn tiếng Việt nên đọc được bằng nRF Connect mà không phải viết app. Đây là
    bản tối giản QĐ-021 đã hẹn, phục vụ NGƯỜI DÙNG B (thợ đứng cạnh pack) —
    không phải người lái xe, và không thay Wi-Fi.
    Không có đặc tính nào ghi được: BLE không xác thực, một đặc tính ghi được là
    cho người lạ trong bán kính 10 m bật sưởi của pack lithium. test/ble_check.py
    kiểm chuyện đó tự động, cùng notify và việc quảng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
2026-09-21 Nút tắt tiếng: an toàn trước máy nhưng chết với người — sửa nốt vế thứ hai
    Ba lần vá trước mới chứng minh cổng USB không bấm hộ được. Vế còn lại chưa ai
    kiểm: người bấm thì có ăn không? Đo ra là KHÔNG.
    Hai nguyên nhân, cả hai do chọn số bằng cảm tính:
    - pollMute() chạy nhịp 1 Hz, mà cú nhấn tay chỉ 200-260 ms nên lọt trọn vào
    giữa hai lần lấy mẫu. Tách Alarm::pollButton(), gọi mỗi vòng loop().
    - Ngưỡng tối thiểu 600 ms của lần vá đầu đã LOẠI SẠCH mọi cú nhấn bình thường
    ngay từ đầu, và trần 1500 ms loại nốt cú giữ lâu (đo thật: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
2026-09-21 Lớp 1 nói được DẠNG bất thường, và mở đúng một đường ghi qua BLE
    (A) cell_ai tra bảng TH-1/2/3 ngay trên thiết bị từ ba đặc trưng đã có sẵn
    (dev_mean, dT_diff, dev_shock). BLE và dashboard giờ nói "NONG LEN NHANH (TH-1)
    - NGAT SAC, cach ly pack" thay vì chỉ đưa một con số điểm. Phân biệt TH-1 với
    TH-2 chính là khác biệt giữa "cách ly ngay" và "mai xem" — quyết định đắt nhất
    mà thợ phải ra tại chỗ.
    Đây là TRA BẢNG, không phải bộ phân loại được huấn luyện, và không đụng gì tới
    quyết định báo động. Ba con số thô luôn đi kèm lời khuyên để người còn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
2026-09-21 Bằng chứng bản demo sạch, và sửa hai dòng tài liệu đã chết
    Bản demo sạch từ nền phẳng: THEO DOI sau 35 s, BAO DONG sau 65 s, cách nhau
    29 s đúng quy tắc giữ 30 s. Điểm cell 3 = 26,974 trên ngưỡng 1,071. Năm cell
    kia đứng yên tuyệt đối suốt 275 giây. Dữ liệu đã lên InfluxDB.
    Hai cái bẫy cho ngày thi: cắt sưởi không làm nhiệt giảm ngay nên không diễn
    được hai lần liên tiếp; và tắt tiếng còn nguyên sang lần sau — đã chứng kiến
    trực tiếp cảnh BAO DONG nằm cạnh [COI DANG TAT TIENG], còi im suốt lúc báo.
    Ghi kèm lược đồ InfluxDB đúng (_measurement="cell", tên cảm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
2026-09-21 Hàng chẩn đoán trên Grafana, và hai lỗ hổng nó phơi ra
    Thêm hàng DẠNG bất thường / Việc phải làm / Ba số đã dùng để tra, viết vào
    make_dashboard.py chứ không kéo thả. Tớ đã lỡ vá thẳng vào Grafana đang chạy
    trước khi nhớ ra, nên repo và thực tế lệch nhau một lúc — đúng cái docstring
    của chính script đó cảnh báo. Giờ đã khớp lại.
    Lỗ hổng 1: AI_Score01..06 chỉ được gửi trong publishAnomaly(), tức chỉ lúc
    vào/ra báo động, nên biểu đồ điểm AI TRỐNG RỖNG suốt lúc bình thường — trống
    đúng lúc giám khảo nhìn. Đường nền phẳng mới là thứ ch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
2026-09-21 App BLE cho Android: trang web nối thẳng pack, không cần mạng
    Web Bluetooth trong Chrome trên Android — không cài đặt, không Play Store,
    không máy chủ trung gian. Hiện trạng thái, 6 cell, thẻ chẩn đoán TH-1/2/3,
    điện áp/dòng, và nút tắt còi (ghi qua đặc tính lệnh, cần ghép đôi).
    Mạng chỉ cần để TẢI trang; sau khi kết nối thì dữ liệu đi thẳng qua BLE, tắt
    Wi-Fi và 4G vẫn chạy. Node-RED phục vụ trang tại /hutieu/app.
    Mất sóng thì app NÓI RA và ghi rõ số đang hiển thị đã cũ, thay vì giữ nguyên
    màn hình như không có chuyện gì — cùng nguyên tắc đã áp dụng ở firmwar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
2026-09-22 Barem thật thay cho tiêu chí đội tự suy ra — WISE-IoT đáng 0 điểm trực tiếp
    Đội đã tự suy ra từ thông báo cũ rằng "WISE-IoT chiếm phần lớn điểm Bán kết"
    và dùng nó làm căn cứ cho nhiều quyết định kiến trúc. Đọc phiếu chấm thật của
    BTC (docs/PHIẾU CHẤM BÁN KẾT AIOT.docx): barem KHÔNG nhắc tới WISE-IoT một lần
    nào.
    Thêm docs/BAREM_CHAM_BAN_KET.md làm nguồn sự thật duy nhất, và đính chính tại
    chỗ 7 vị trí ở 6 file. KHÔNG xoá file nào — ba tài liệu đó chứa nhiều nội dung
    còn đúng và đang được tham chiếu khắp nơi; xoá cả file là mất luôn phần t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
2026-09-22 Lớp 2 chạy trên chip: RUL/SOH không cần mạng, và một test chặn hai bên lệch nhau
    Cloud vẫn là bản chuẩn (đổi hệ số không phải nạp lại firmware cho từng thiết bị
    ngoài hiện trường — hệ số đang mượn NASA và chắc chắn phải hiệu chỉnh). Chip
    thêm bản dự phòng để trả lời được khi mất mạng và để app BLE có số.
    Lý do cũ "cloud tính để ăn điểm WISE-IoT" đã bị bác bỏ bởi barem thật, nhưng lý
    do còn lại vẫn đứng vững nên giữ cả hai. Giữ cloud tốn 0 công: rul_predict.js
    đã chạy sẵn, ESP32 đã gửi CYC_* sẵn.
    Chỗ nguy hiểm nhất là hai bản s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
2026-09-22 Kiểm chứng Lớp 2 trên chip thật: chạy được, khớp cloud, sống qua mất điện
    Nạp lên ESP32-S3 và kiểm bốn thứ, mỗi thứ quan sát từ bên ngoài chứ không
    tin vào code:
    - Chip tự tính: RUL 85,2 chu kỳ / SOH 94,0%, không có cờ ngoại suy.
    - Kết quả lên tới cloud: bắt gói ONB_* bằng mosquitto_sub, đúng data contract cũ.
    - Lịch sử sống qua reset cứng: 0 -> 7 chu kỳ. Không có bước này thì mọi con số
    xu hướng mất khi rút điện.
    - ONB_SOH_Slope vắng ở n=2, có ở n=3 — đúng chốt chặn "2 điểm luôn thẳng hàng".
    Sửa một log nói sai sự thật: BLE vẫn in "CHI DOC, khong co len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
    [ble_view.cpp]
2026-09-22 App BLE: phục vụ file tĩnh riêng thay vì phơi cổng Node-RED ra LAN
    README cũ bảo mở http://<IP>:1880/hutieu/app từ điện thoại. Làm theo là phải
    phơi cổng 1880 ra LAN — đúng thứ ràng buộc cứng #4 trong CLAUDE.md cấm, vì ai
    vào được 1880 là deploy được function node, tức chạy code tuỳ ý trên máy chủ,
    và Node-RED không có mật khẩu mặc định.
    Trang này là file tĩnh thuần, không gọi mạng lần nào, nên phục vụ bằng một
    http.server riêng ở cổng 8088 là đủ và không đụng tới Node-RED.
    Sửa luôn mục 'Lớp 2 không có ở đây' — hết đúng từ QĐ-043, app đọc đặc tính
    0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
2026-09-22 App Android gốc cho điện thoại, vì bản web phụ thuộc mạng mà mạng trường chặn
    Điện thoại không mở được bản web trên Wi-Fi trường. Chẩn đoán đầu của AI là
    "sai bước chrome://flags" và nó SAI: log máy chủ tĩnh không có một request nào
    từ IP điện thoại, trong khi máy tính tự gọi vẫn 200. Trang chưa bao giờ tải
    được nên Web Bluetooth còn chưa tới lượt — mạng trường chặn máy-nói-với-máy.
    App gốc bỏ được đúng phụ thuộc đó: cài một lần rồi chạy offline hoàn toàn.
    Hôm thi không ai biết Wi-Fi hội trường thế nào.
    Không thư viện ngoài nào (không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
2026-09-22 App Android chạy được trên máy thật: dữ liệu, Lớp 2, và nút tắt còi tới chip
    Galaxy M34 / Android 16 (mới hơn targetSdk 34 nên là bài kiểm thật).
    Nút tắt còi kiểm bằng ba đường độc lập: Android báo GATT_SUCCESS, chip in
    lenh "mute on", và cloud thấy Alarm_Muted=1. Đường thứ ba không đi qua BLE nên
    loại trừ khả năng app tự báo thành công mà chip chưa nhận gì.
    Bốn lỗi tìm ra và sửa:
    - Ghi lệnh trả 0x03 WRITE_NOT_PERMITTED (KHÔNG phải thiếu quyền — thiếu xác
    thực là 0x05). Thêm xoá cache GATT qua reflection. KHÔNG chứng minh được đây
    là thứ đã chữa: bản sửa đ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
2026-09-22 Tắt tiếng được ở mức nguy kịch, nút phản ánh trạng thái thật, và song ngữ
    QĐ-045 — Chủ dự án quyết định cho tắt tiếng cả ở mức NGUY KỊCH, đảo lại thiết
    kế cũ. Còi 100 dB cạnh người đang xử lý sự cố thì thứ bị tắt sẽ là cả hệ thống.
    Kèm hạn 2 phút tự bật lại BẤT KỂ tắt bằng đường nào: đường BLE vốn đã có hạn 5
    phút, nhưng NÚT BẤM thì im vĩnh viễn — chú thích đầu tiên của AI ghi sai chỗ
    này rồi mới phát hiện.
    QĐ-046 — Thêm đặc tính BLE 000A dạng khoá=giá trị (mute/quiet/lvl/ttl). App
    trước chỉ báo "đã gửi lệnh": ng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
2026-09-22 Grafana bản tiếng Anh, và kiểm chứng tắt tiếng ở mức NGUY KỊCH trên máy thật
    Grafana: make_dashboard.py --lang en sinh dashboard thứ hai từ CÙNG mã nguồn
    (uid hutieu-pin-en), nên hai bản không lệch nhau về bố cục hay truy vấn. Grafana
    không đổi được ngôn ngữ theo người xem vì tiêu đề panel là chuỗi tĩnh trong JSON.
    Bản dịch đầu của AI chỉ dịch tiêu đề và mô tả, BỎ SÓT hẳn nhãn giá trị và tên
    trục — thứ người xem đọc nhiều nhất. Dashboard "tiếng Anh" vẫn hiện NGẮT SẠC ·
    NGẮT TẢI. Nay i18n_en.py TỰ DÒ chuỗi còn dấu tiếng Việt và in cảnh báo, và
    ch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
2026-09-22 Tắt tiếng Lớp 1 giữ được qua dao động mức, và nấc tự cứu khi Wi-Fi nói dối
    QĐ-047 — Bất thường Lớp 1 thì tắt còi là tắt hẳn; mức NGUY KỊCH thì còi tự kêu
    lại sau 2 phút để nhắc. Bỏ hẳn hẹn giờ 5 phút của đường BLE: nó áp cho MỌI mức
    và là đường duy nhất có hạn, trong khi nút bấm thì không có hạn nào. Hạn giờ
    nay nằm ở alarm.cpp nên áp cho cả hai đường.
    QĐ-047b — Lỗi chỉ lộ ra khi CHẠY THẬT. Sau khi bỏ hẹn giờ, tắt tiếng vẫn kêu
    lại sau 98 giây: luật cũ `lvl_ > prev` tính mỗi lần mức nhấp lên là leo thang,
    mà điểm AI thì dao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
2026-09-22 Tài liệu tổng quan toàn hệ thống — cho người ngoài đọc và cho phần phản biện
    Một file trả lời từ đầu: bài toán là gì, hệ gồm những gì, autoencoder là gì và
    vì sao chọn nó, Grafana/InfluxDB/MQTT là gì, ba user flow, so sánh với BMS phổ
    thông và BMS cao cấp, lộ trình 4 giai đoạn có mốc thời gian và chi phí.
    Ba chỗ cố ý viết ngược với kiểu tài liệu tiếp thị:
    - Mục "hệ thống hiện KHÔNG làm được gì" liệt kê 7 thứ, trong đó nói rõ blocker
    thật của Lớp 2 không phải thiếu đồ mà là thiếu THỜI GIAN cho pin già đi —
    thứ không mua được bằng ti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
2026-09-23 Diễn được TH-2 trên chip thật: sưởi giữ ấm tỉ lệ, trang 1880 chọn TH-1/TH-2
    - demo_heater: thêm chế độ ỔN ĐỊNH (băm xung tỉ lệ, trần 30 %), mọi hạn mức
    an toàn giữ nguyên. Lệnh heat nhận "mode":"steady", Serial 'w'.
    - cell_ai: shock chỉ tính là TH-1 khi cell còn đang lên (dt_diff >= 0,3).
    Đo trên chip: 82 mẫu bị gọi "cách ly pack" chỉ vì nền EMA bám chậm.
    - Trang 1880: hai nút TH-1 nóng vọt / TH-2 ấm ổn định.
    - Grafana: link đổi VI <-> EN ở góc trên hai dashboard.
    - App Android: ChipText.kt dựng lại chữ Lớp 1/Lớp 2 từ số, có dấu, song ngữ;
    hết sót tiếng Việt ở b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
2026-09-23 Seed lịch sử Lớp 2 bằng pin NASA phát lại, và sửa ba lỗi làm Lớp 2 hỏng
    - seed_layer2.py: phát lại 60 chu kỳ pin NASA B0005 qua MQTT thật; Node-RED
    tự tính SOH/RUL bằng đúng mô hình. Không bịa kết quả, chỉ dàn dựng thời điểm.
    - Grafana: panel Lớp 2 đọc measurement "rul" (trước truy vấn "cell" nên trống
    từ đầu); biểu đồ RUL xem 30 ngày.
    - Firmware: mô phỏng sạc già 0,5 s/chu kỳ từ tau 1370 (trước 15 phút là ra
    khỏi dải, SOH 55 %, RUL 0); bỏ làm tròn đặc trưng CYC_* (cloud lệch chip
    3,45 điểm SOH vì dvdt_cc ~1e-4 bị làm tròn mất).
    Bằng chứng: docs/BANG_CHUNG_LOP2_SE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
2026-09-23 Bằng chứng: ảnh Grafana Lớp 2 sau khi seed, xem bằng Chrome thật
    Claude-Session: https://claude.ai/code/session_0158BSDhdi8TZzuhvqiNTbVT
2026-09-23 Dashboard: thay ô 'số THẬT?' bằng điện áp/dòng INA226, bỏ đường -100 °C
    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
2026-09-23 Tài liệu: sửa câu cũ 'Lớp 1 trượt chuyển giao', thêm mục cell sát cực chính
    TONG_QUAN còn ghi kết quả của bản 16 đặc trưng (QĐ-032). Bản hiện tại (QĐ-033)
    qua được chuyển giao sang McMaster mà không train lại, chỉ bỏ sót UDDS_Blocked.
    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
2026-09-23 Standee 80×180: file in PDF (đã gồm bleed 3 mm) + mã nguồn HTML
    Ảnh phần cứng, logo, mã QR để ô chờ dán. Số liệu lấy từ QĐ-033 và rul_predict.js.
    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
2026-09-23 Standee bản 2: tông sáng, ảnh chụp thật dashboard + app; mô phỏng sạc già chậm hơn
    Bỏ logo, QR, bốn con số và hình 6 cell theo góp ý. Mô phỏng sạc 0,5 -> 0,05 s/chu kỳ
    vì RUL tụt ~12 chu kỳ/giờ làm biểu đồ 30 ngày có vách dựng đứng.
    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
2026-09-23 Standee: chụp lại ảnh app, không còn bong bóng Zalo
    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
2026-09-23 Sưởi demo chạy tới khi người bấm dừng; nút DỪNG SƯỞI + trạng thái trên trang 1880
    Bỏ mốc tự cắt 180 s (cắt giữa chừng khi có keo tản nhiệt), thay bằng chốt
    'bật 4 phút mà cell không nóng thêm 0,5 °C'. Giữ trần 50 °C, mất cảm biến, deadman. QĐ-051.
    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
